RH-Electronics/MyGeiger_ver2/Photos/mygeiger-dosimeter-assembled-kit.jpg

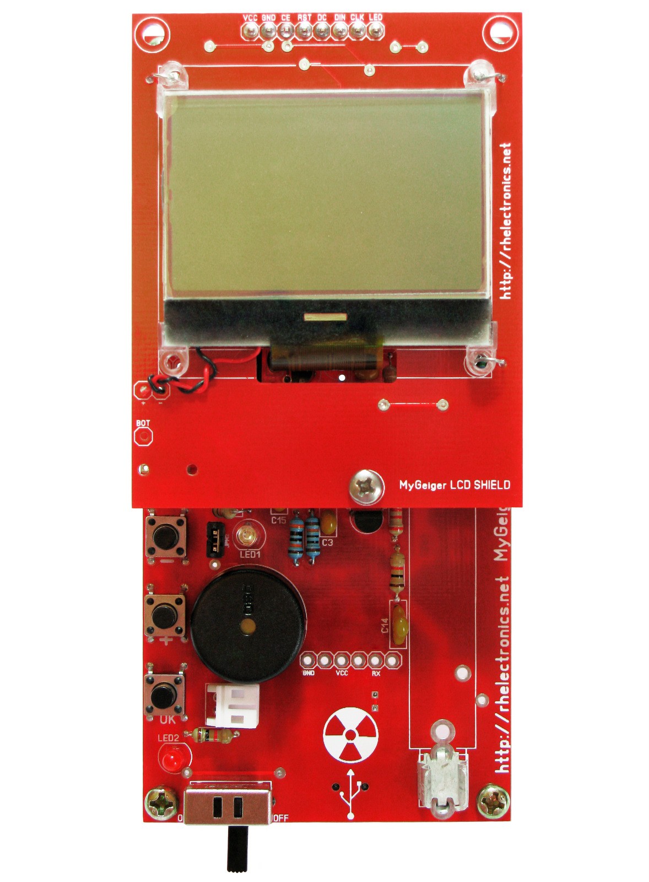
Photos/mygeiger-dosimeter-assembled-kit.jpg
