RH-Electronics/MyGeiger_ver2/Hardware/DYaDNbcA.jpeg

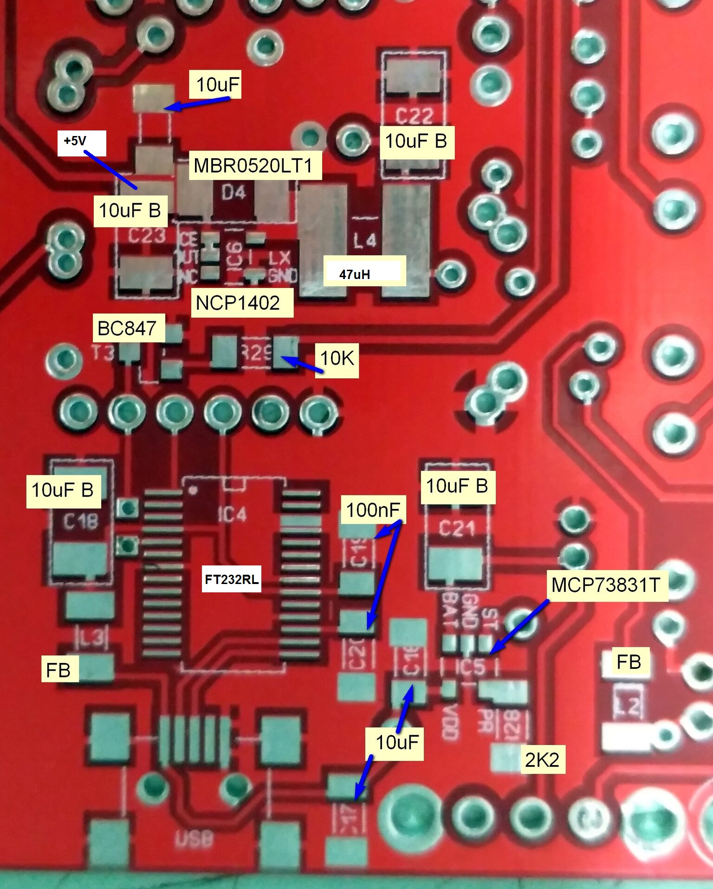
Hardware/DYaDNbcA.jpeg
