RH-Electronics/MyGeiger_ver2/README.md

# MyGeiger_ver2
MyGeiger ver.2 Dosimeter DIY Geiger Counter Kit with LCD Shield and USB

https://www.rhelectronics.store/mygeiger-dosimeter-diy-geiger-counter-kit-with-lcd-shield-usb-pic18f2550-second-edition
