RH-Electronics/MyGeiger_ver2/Firmware/readme

Firmware files with source code for main board and SD Logger module
