RH-Electronics/MyGeiger_ver2/Hardware/pic18f2550_ver2.GIF

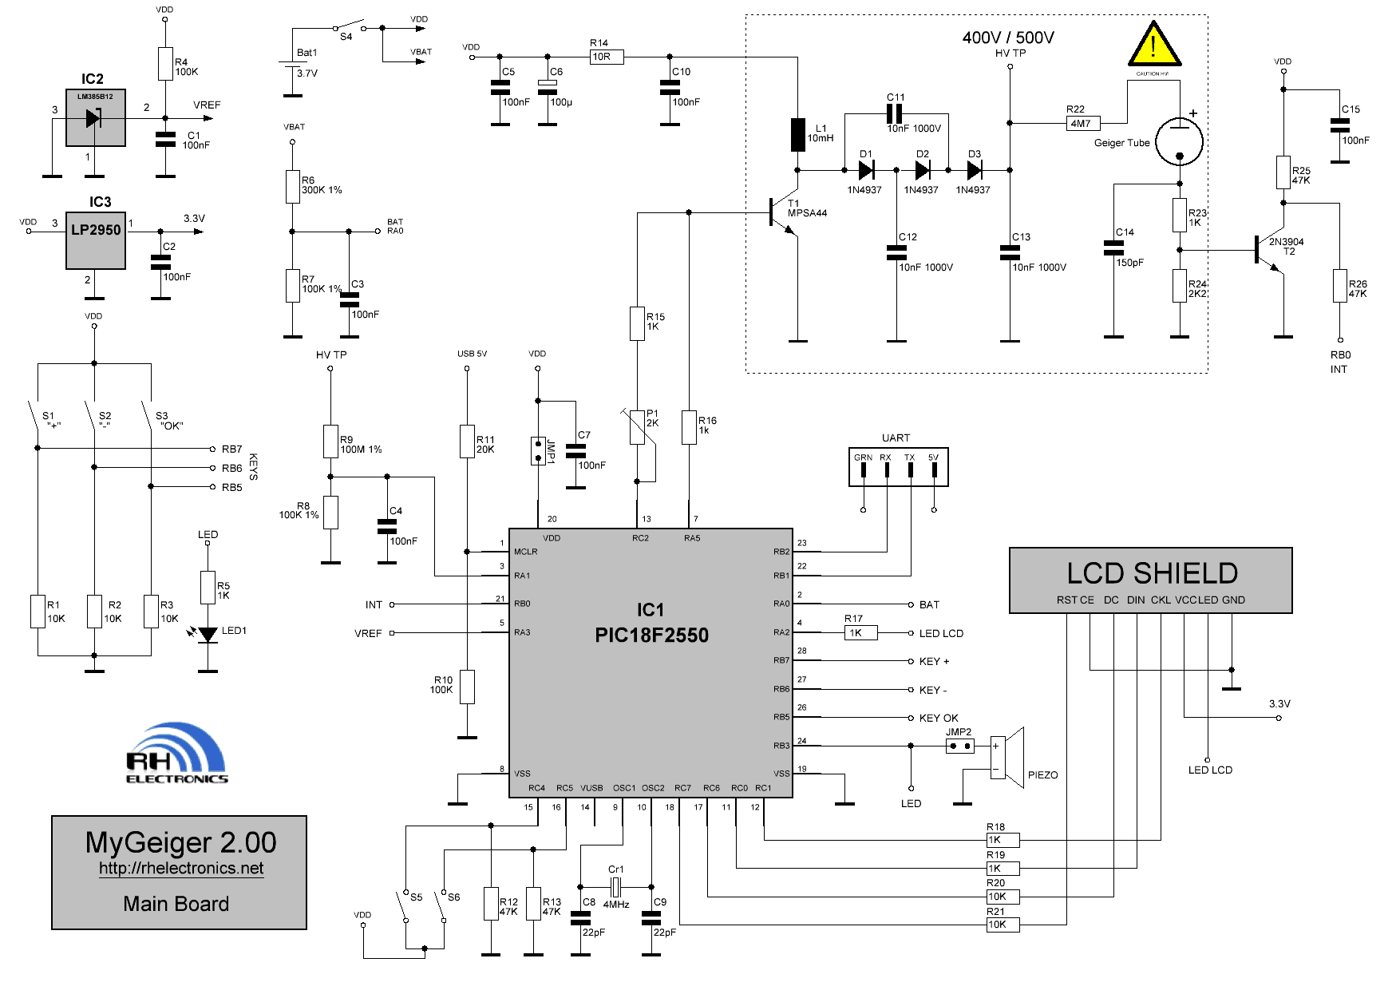
Hardware/pic18f2550_ver2.GIF
