RH-Electronics/MyGeiger_ver2/Photos/dosimeter_mygeiger_second_edition.jpg

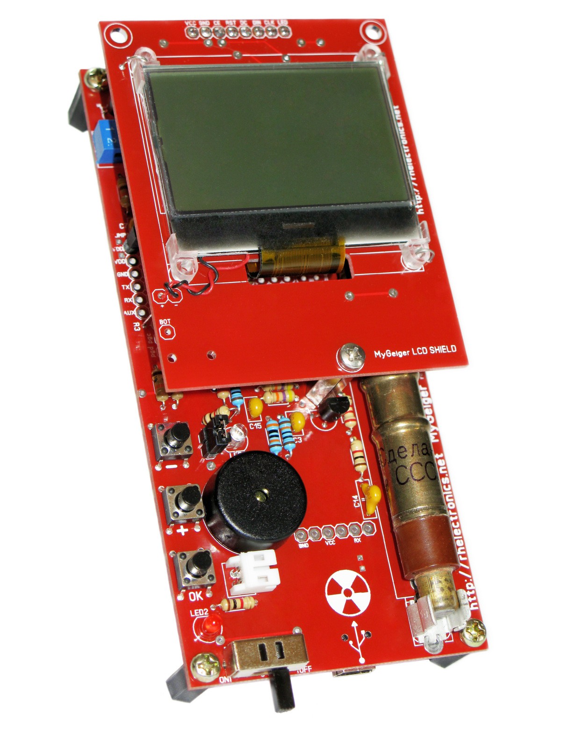
Photos/dosimeter_mygeiger_second_edition.jpg
