RH-Electronics/MyGeiger_ver2/Photos/img_1046.jpg

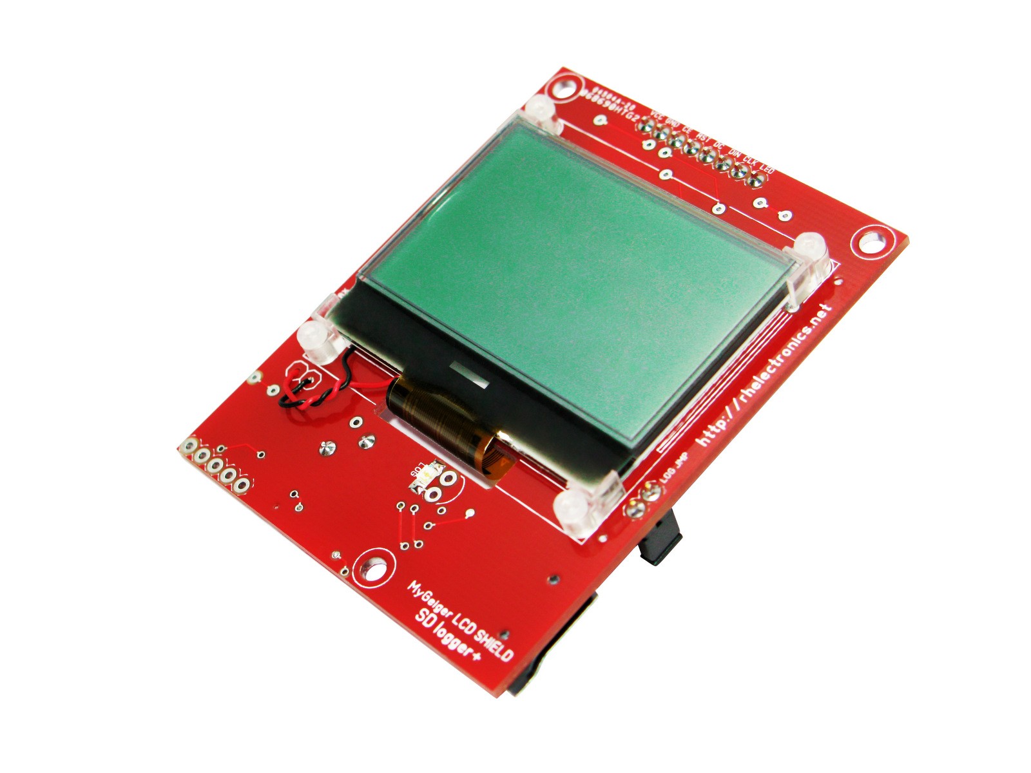
Photos/img_1046.jpg
