RH-Electronics/MyGeiger_ver2/Photos/img_1079.jpg

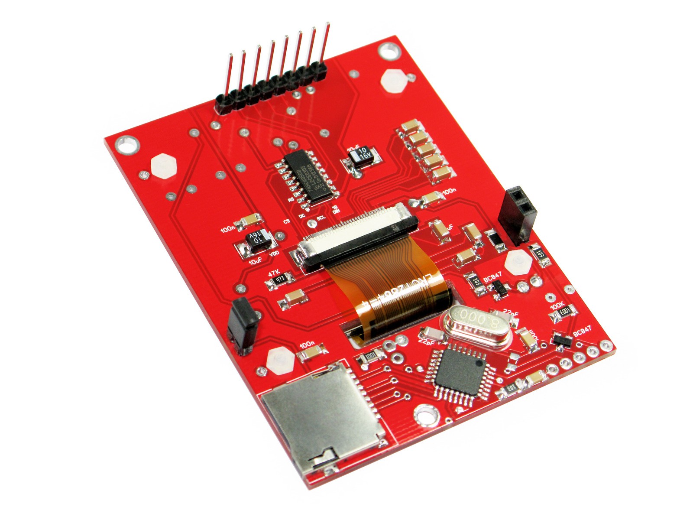
Photos/img_1079.jpg
