RH-Electronics/MyGeiger_ver2/Photos/img_8147.jpg

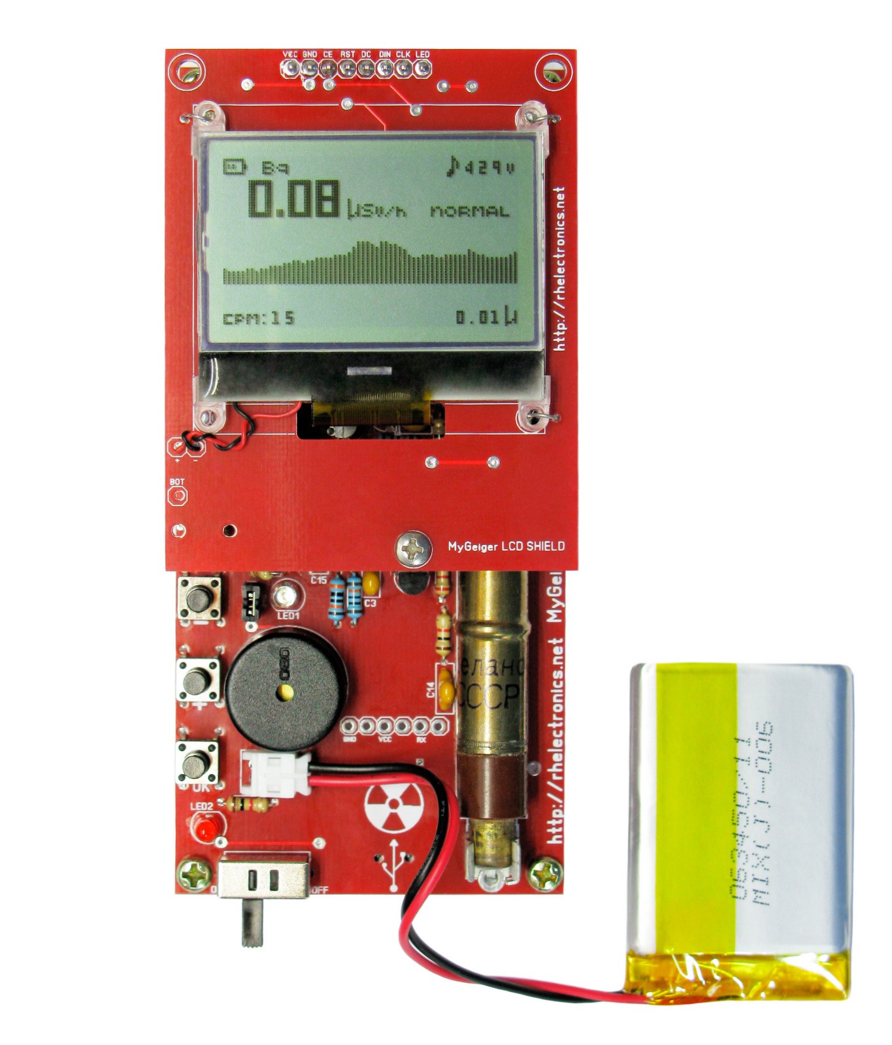
Photos/img_8147.jpg
