RH-Electronics/MyGeiger_ver2/Photos/img_8734_vertical.jpg

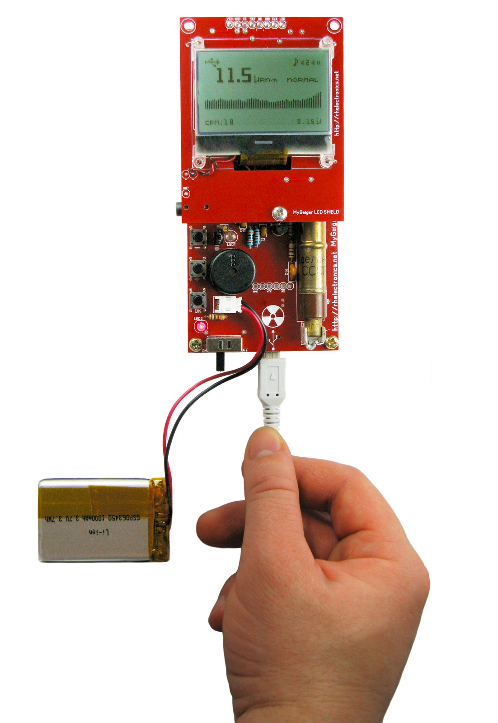
Photos/img_8734_vertical.jpg
