RH-Electronics/MyGeiger_ver2/Photos/mygeiger-urn.jpg

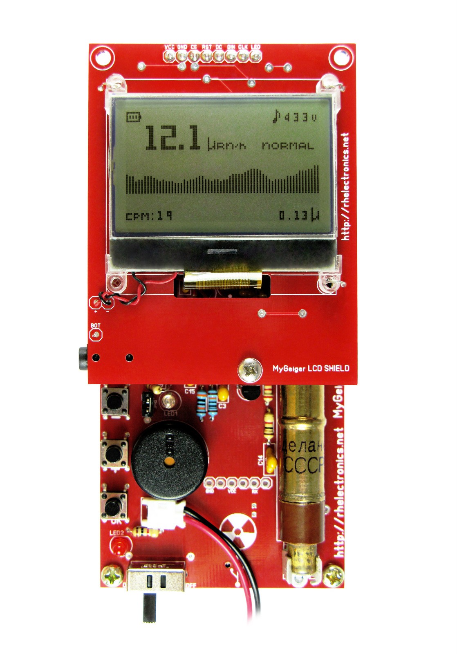
Photos/mygeiger-urn.jpg
