RH-Electronics/MyGeiger_ver2/Photos/mygeiger_2.jpg

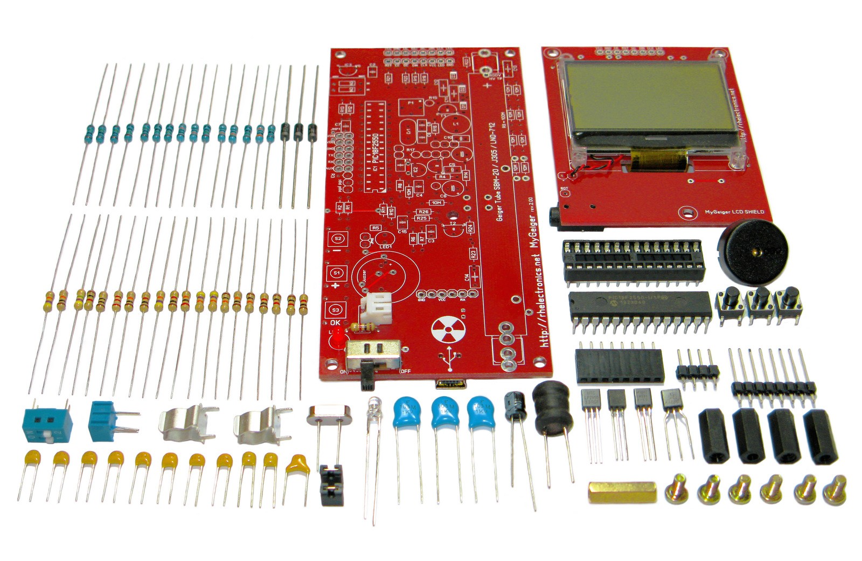
Photos/mygeiger_2.jpg
