RH-Electronics/MyGeiger_ver2/Photos/mygeiger_diy_dosimeter.jpg

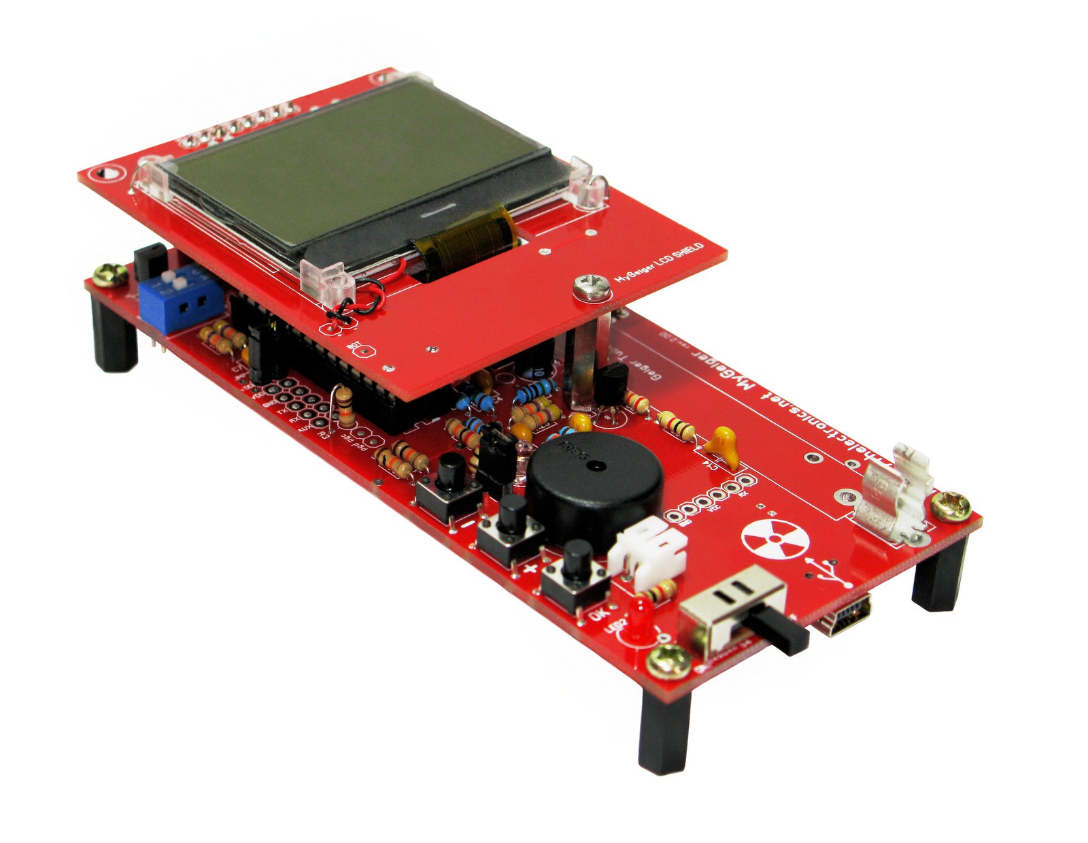
Photos/mygeiger_diy_dosimeter.jpg
