RH-Electronics/MyGeiger_ver2/Photos/mygeiger_diy_kit.jpg

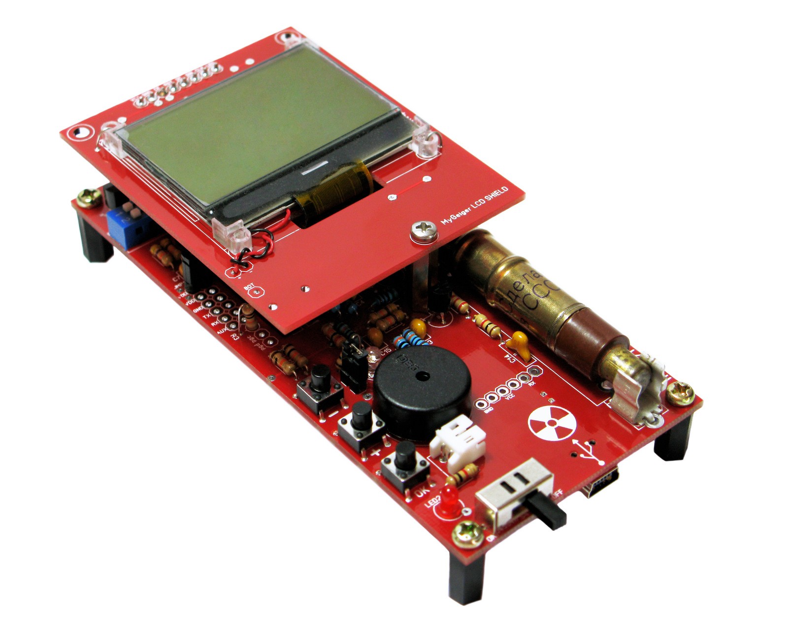
Photos/mygeiger_diy_kit.jpg
