RH-Electronics/MyGeiger_ver2/Photos/mygeiger_kit.jpg

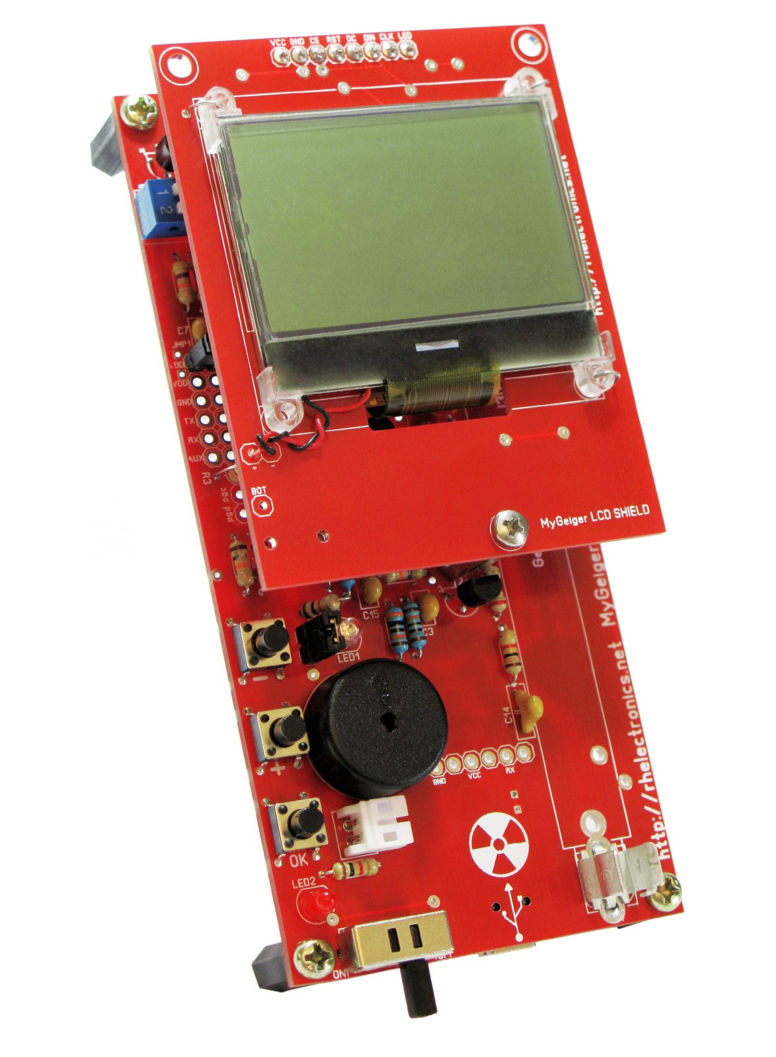
Photos/mygeiger_kit.jpg
