RH-Electronics/MyGeiger_ver2/Photos/mygeiger_side_view.jpg

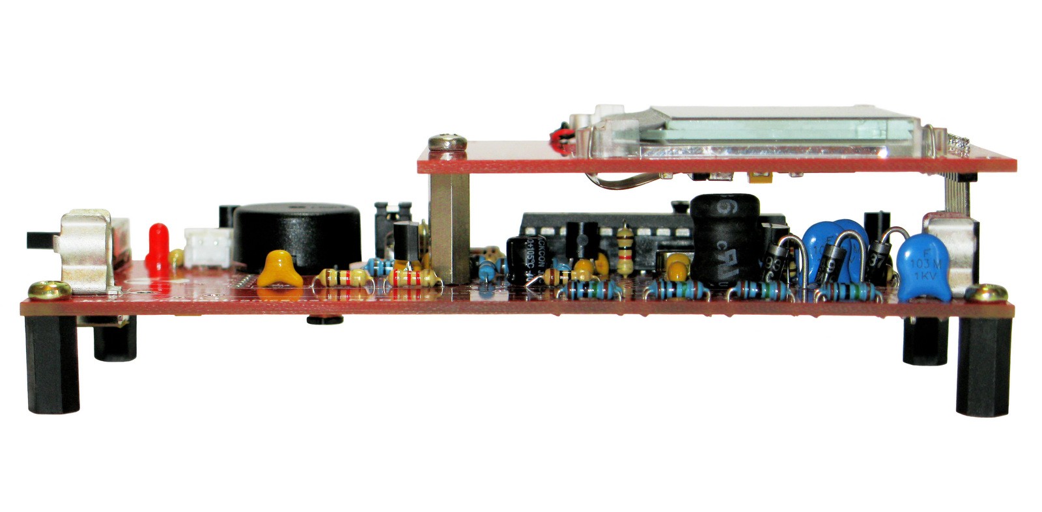
Photos/mygeiger_side_view.jpg
