RH-Electronics/MyGeiger_ver2/Photos/mygeiger_side_view_with_sbm-20.jpg

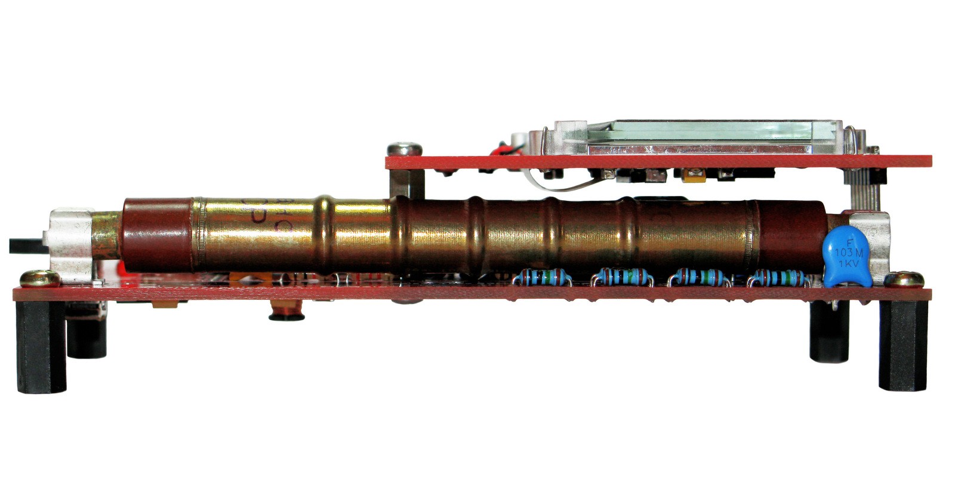
Photos/mygeiger_side_view_with_sbm-20.jpg
