RH-Electronics/MyGeiger_ver2/Photos/mygeiger_with_sbm-20.jpg

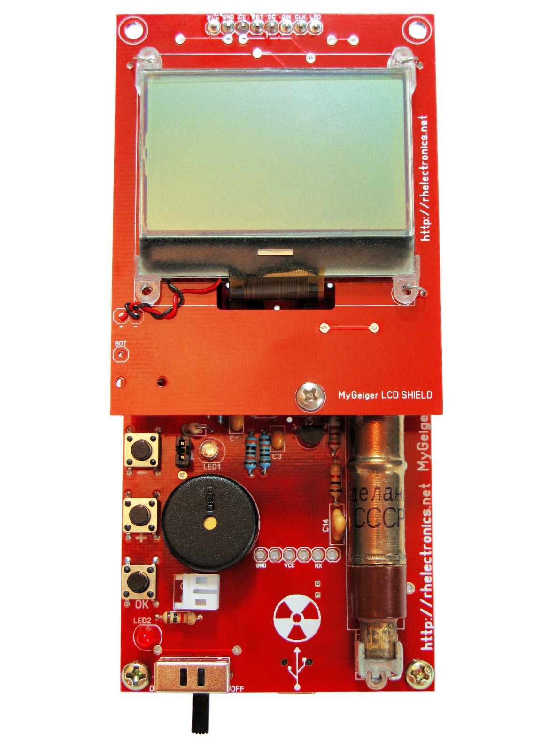
Photos/mygeiger_with_sbm-20.jpg
