RH-Electronics/MyGeiger_ver2/Photos/SD_Logger_LCD_Shield-002.jpg

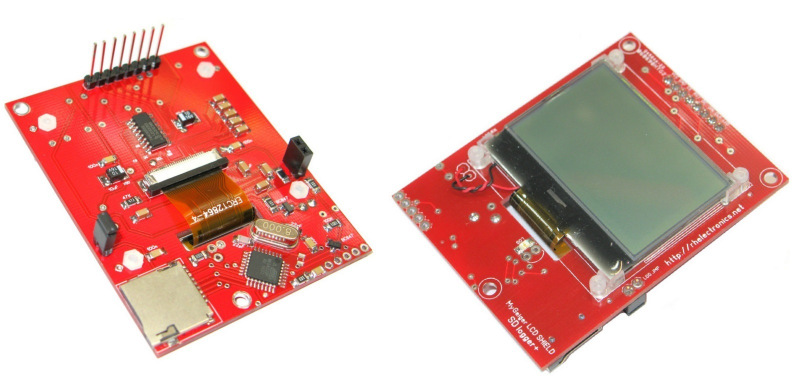
Photos/SD_Logger_LCD_Shield-002.jpg
