RH-Electronics/MyGeiger_ver2/Hardware/BOM-MyGeiger-2.xlsx

Sheet: CUSTOMER
Component Name | Quantitiy | Additional
Resistor 10K | 5 | 0.25W 5%
Resistor 1K | 7 | 0.25W 5%
Resistor 20K | 1 | 0.25W 5%
Resistor 2.2K | 1 | 0.25W 5%
Resistor 47K | 4 | 0.25W 5%
Resistor 10R | 1 | 0.25W 5%
Resistor 4.7M | 1 | 0.25W 5%
Resistor 300K | 1 | 0.25W 1%
Resistor 100K | 4 | 0.25W 1%
Resistor 10M | 10 | 0.25W 1%
Potentiometer 2K | 1 | 3362P
Ceramic Capacitor 100nF | 8 | Multilayer
Ceramic Capacitor 22pF | 2 | Multilayer
Ceramic Capacitor 150pF | 1 | Multilayer
Ceramic Capacitor 10nF 1000V | 3 | Multilayer
Electrolythic Capacitor 100uF | 1 | 5x6 mm
LED blue | 1 | 3mm
Diode 1N4937 | 3 | Fast Rectifier
Crystal 4.000MHz | 1 | HS-49S
Piezo Buzzer | 1 | Passive
Ferrite Radial Inductor 10mH | 1 | 8x10 15Ohm
Tact Switch | 3 | 6x6
Dip Switch 2 Position | 1
8 Pin Female Header | 1
2 Pin Male Header | 2
Jumper Cup | 2
Tube Clips | 2
M3x6 Screw | 6
M3x12 Standoff | 4
M3x15 Standoff | 1
28 Pin IC Socket | 1
Transistor MPSA44 | 1 | TO-92
Transistor 2N3904 | 1 | TO-92
LP2950 3.3V LDO | 1 | TO-92
LM385B12 VREF | 1 | TO-92
PIC18F2550 | 1 | DIP-28

Sheet: MAIN BOARD SMD
Component Name | Quantitiy | Additional | LINK
Resistor 1k | 1 | 0.25 W DIP
LED red | 1 | 3mm DIP
Resistor 2.2K | 1 | 1206
Resistor 10K | 1 | 1206
Ceramic Capacitor 100nF | 3 | 1206
Ceramic Capacitor 10uF | 2 | 1206
Tantalum Capacitor 10uF B | 4 | 3528
Diode MBR0520LT1 | 1 | SOD123
Inductor 47uH | 1 | CD54-470L
Ferrite Bead | 2 | 1206
Mini USB 5 Pin | 1 | SMD
BC847 | 1 | SOT-23
NCP1402 5V | 1 | SOT-23-5
MCP73831T | 1 | SOT-23-5
FT232-RL | 1 | SSOP-28 | https://www.digikey.co.il/product-detail/en/ftdi-future-technology-devices-international-ltd/FT232RL-REEL/768-1007-1-ND/1836402
Slide Switch | 1 | On/Off
LIPO Connector | 1 | 2.0mm
zener 75V BZX84C75 | 1 | sot-23
zener 91V MMBZ5270BLT1G | 2 | sot-23
zener 51V BZX84C51 | 1 | sot-23

Sheet: LCD SHIELD without Logger
Component Name | Quantitiy | Additional | LINK
Resistor 10K | 1 | 1206
Resistor 200R | 1 | 1206
Resistor 3.9K | 1 | 1206
Resistor 39K | 1 | 1206
Resistor 47K | 1 | 1206
Ceramic Capacitor 1uF 25V | 9 | 1206
Ceramic Capacitor 100nF | 2 | 1206
Ceramic Capacitor 10nF | 1 | 1206
Tantalum Capacitor 10uF size B | 2 | 3528
TRSS Audio Connector for Geiger Bot | 1 | SMD
Transistor BC847 | 1 | SOT-23
74HC4050 | 1 | SOP-16
1.8 inch SPI Serial 128x64 COG LCD | 1 | ERC12864FBF | https://www.buydisplay.com/default/1-8-inch-spi-serial-128x64-touch-cog-lcd-module-display-black-on-blue
30 Pins 0.50mm Pitch ZIF Connector | 1
8 Pin Male Header Long 15mm | 1

Sheet: LCD_SHIELD with Logger
Component Name | Quantitiy | Additional | LINK
Resistor 100K | 1 | 1206
Resistor 10K | 3 | 1206
Resistor 200R | 1 | 1206
Resistor 1K | 1 | 1206
Resistor 39K | 1 | 1206
Resistor 47K | 1 | 1206
Ceramic Capacitor 1uF 25V | 9 | 1206
Ceramic Capacitor 100nF | 5 | 1206
Ceramic Capacitor 22pF | 2 | 1206
SMD led | 1 | 1206
Tantalum Capacitor 10uF size B | 2 | 3528
Transistor BC847 | 2 | SOT-23
74HC4050 | 1 | SOP-16
1.8 inch SPI Serial 128x64 COG LCD | 1 | ERC12864FBF | https://www.buydisplay.com/default/1-8-inch-spi-serial-128x64-touch-cog-lcd-module-display-black-on-blue
30 Pins 0.50mm Pitch ZIF Connector | 1
10 Pin Male Header Long 15mm | 1
2.54mm Jumper cup | 1
ATMEGA328PB-AU | 1 | 32-TQFP (7x7) | install arduino IDE prior soldering, see PDF manual for logger
Crystal 8MHz | 1 | HC-49S
SD Socket | 1 | Micro SD Push/Push Socket w/ 9 SMT Contacts | https://www.ebay.com/itm/10Pcs-Push-Push-Type-TF-Micro-SD-Card-Solder-Socket-Memmory-Card-Connector/171722065875
