RH-Electronics/MyGeiger_ver2/Photos/atomic-dave-internal-wiring-diagram.jpg

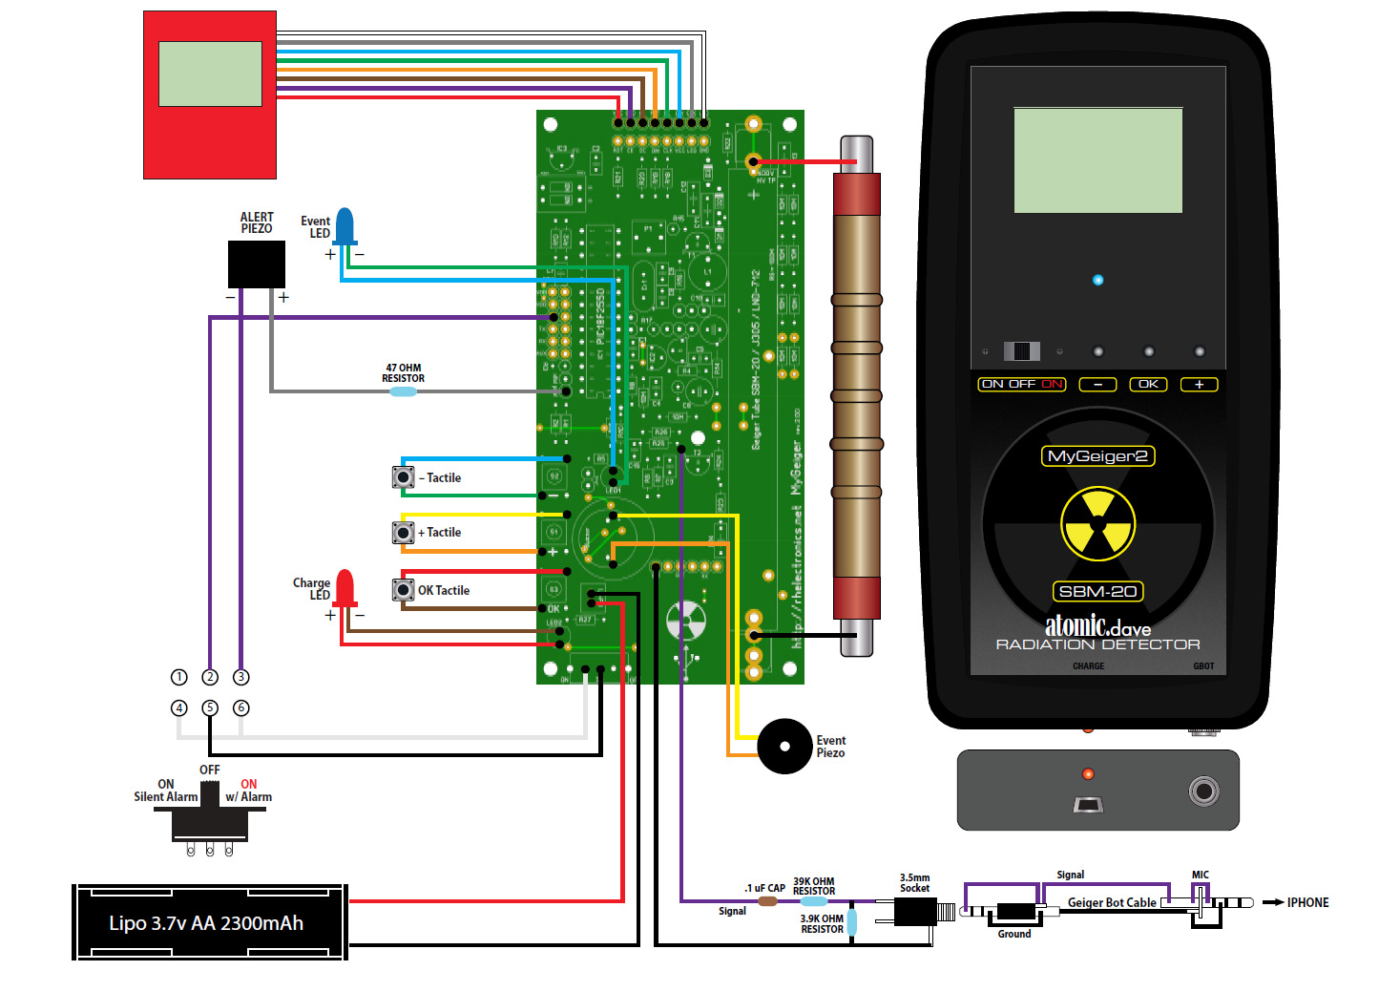
Photos/atomic-dave-internal-wiring-diagram.jpg
