RH-Electronics/MyGeiger_ver2/(list of files, drawings)

Other design files:
Hardware/LOGGER_LCD.lay6
Hardware/MyGeiger_ver2_main_board.lay6
