RH-Electronics/MyGeiger_ver2/Firmware/MyGeiger_NT.asm

_interrupt:

;MyGeiger_NT.mbas,477 :: 		sub procedure interrupt()             ' Interrupt Settings
;MyGeiger_NT.mbas,479 :: 		if (TMR0IF_bit = 1) then
	BTFSS       TMR0IF_bit+0, BitPos(TMR0IF_bit+0) 
	GOTO        L__interrupt2
;MyGeiger_NT.mbas,480 :: 		LATA.5  = 0                        ' turn off podkachka
	BCF         LATA+0, 5 
;MyGeiger_NT.mbas,481 :: 		T0CON = %01001000
	MOVLW       72
	MOVWF       T0CON+0 
;MyGeiger_NT.mbas,482 :: 		TMR0IF_bit = 0
	BCF         TMR0IF_bit+0, BitPos(TMR0IF_bit+0) 
L__interrupt2:
;MyGeiger_NT.mbas,485 :: 		if (TMR3IF_bit = 1) then
	BTFSS       TMR3IF_bit+0, BitPos(TMR3IF_bit+0) 
	GOTO        L__interrupt5
;MyGeiger_NT.mbas,486 :: 		if (buzzer_counter = 4) then
	MOVF        _buzzer_counter+0, 0 
	XORLW       4
	BTFSS       STATUS+0, 2 
	GOTO        L__interrupt8
;MyGeiger_NT.mbas,487 :: 		LATB.3 = 0
	BCF         LATB+0, 3 
;MyGeiger_NT.mbas,488 :: 		buzzer_counter = 0
	CLRF        _buzzer_counter+0 
;MyGeiger_NT.mbas,489 :: 		buzzer_started = 0
	BCF         _buzzer_started+0, BitPos(_buzzer_started+0) 
;MyGeiger_NT.mbas,490 :: 		TMR3ON_bit = 0
	BCF         TMR3ON_bit+0, BitPos(TMR3ON_bit+0) 
	GOTO        L__interrupt9
;MyGeiger_NT.mbas,491 :: 		else
L__interrupt8:
;MyGeiger_NT.mbas,492 :: 		if buzzer_started = 1 then
	BTFSS       _buzzer_started+0, BitPos(_buzzer_started+0) 
	GOTO        L__interrupt11
;MyGeiger_NT.mbas,493 :: 		LATB.3 = not LATB.3
	BTG         LATB+0, 3 
L__interrupt11:
;MyGeiger_NT.mbas,495 :: 		inc (buzzer_counter)
	INCF        _buzzer_counter+0, 1 
;MyGeiger_NT.mbas,496 :: 		end if
L__interrupt9:
;MyGeiger_NT.mbas,497 :: 		TMR3H = 0xFF
	MOVLW       255
	MOVWF       TMR3H+0 
;MyGeiger_NT.mbas,498 :: 		TMR3L = 0x91                       'd2
	MOVLW       145
	MOVWF       TMR3L+0 
;MyGeiger_NT.mbas,500 :: 		TMR3IF_bit = 0
	BCF         TMR3IF_bit+0, BitPos(TMR3IF_bit+0) 
L__interrupt5:
;MyGeiger_NT.mbas,505 :: 		if (TMR1IF_bit = 1) then             ' Test Timer1 interrupt flag
	BTFSS       TMR1IF_bit+0, BitPos(TMR1IF_bit+0) 
	GOTO        L__interrupt14
;MyGeiger_NT.mbas,507 :: 		if(b_count = 4) then               ' let check buttons every 250 ms
	MOVF        _b_count+0, 0 
	XORLW       4
	BTFSS       STATUS+0, 2 
	GOTO        L__interrupt17
;MyGeiger_NT.mbas,508 :: 		b_count = 0
	CLRF        _b_count+0 
;MyGeiger_NT.mbas,509 :: 		button_check = 1
	BSF         _button_check+0, BitPos(_button_check+0) 
	GOTO        L__interrupt18
;MyGeiger_NT.mbas,510 :: 		else
L__interrupt17:
;MyGeiger_NT.mbas,511 :: 		inc(b_count)
	INCF        _b_count+0, 1 
;MyGeiger_NT.mbas,512 :: 		end if
L__interrupt18:
;MyGeiger_NT.mbas,514 :: 		if(sek_counter = 19) then          ' secund is over timer
	MOVF        _sek_counter+0, 0 
	XORLW       19
	BTFSS       STATUS+0, 2 
	GOTO        L__interrupt20
;MyGeiger_NT.mbas,515 :: 		sek_counter = 0
	CLRF        _sek_counter+0 
;MyGeiger_NT.mbas,516 :: 		sek_cnt = cnt_s
	MOVF        _cnt_s+0, 0 
	MOVWF       _sek_cnt+0 
	MOVF        _cnt_s+1, 0 
	MOVWF       _sek_cnt+1 
;MyGeiger_NT.mbas,517 :: 		cnt_s = 0
	CLRF        _cnt_s+0 
	CLRF        _cnt_s+1 
;MyGeiger_NT.mbas,518 :: 		sek_over = 1
	BSF         _sek_over+0, BitPos(_sek_over+0) 
	GOTO        L__interrupt21
;MyGeiger_NT.mbas,519 :: 		else
L__interrupt20:
;MyGeiger_NT.mbas,520 :: 		inc(sek_counter)
	INCF        _sek_counter+0, 1 
;MyGeiger_NT.mbas,521 :: 		end if
L__interrupt21:
;MyGeiger_NT.mbas,523 :: 		if(timer_cnt = m_period) then      ' When time elapsed    m_period
	MOVF        _timer_cnt+0, 0 
	XORWF       _m_period+0, 0 
	BTFSS       STATUS+0, 2 
	GOTO        L__interrupt23
;MyGeiger_NT.mbas,524 :: 		counts = cnt                     ' Store result in counts
	MOVF        _cnt+0, 0 
	MOVWF       _counts+0 
	MOVF        _cnt+1, 0 
	MOVWF       _counts+1 
;MyGeiger_NT.mbas,525 :: 		cnt = 0                          ' Reset counter
	CLRF        _cnt+0 
	CLRF        _cnt+1 
;MyGeiger_NT.mbas,526 :: 		timer_cnt = 0                    ' Reset timer_cnt
	CLRF        _timer_cnt+0 
;MyGeiger_NT.mbas,527 :: 		cpm_read_done = 1                ' Set flag = 1
	BSF         _cpm_read_done+0, BitPos(_cpm_read_done+0) 
	GOTO        L__interrupt24
;MyGeiger_NT.mbas,528 :: 		else
L__interrupt23:
;MyGeiger_NT.mbas,529 :: 		inc(timer_cnt)                   ' Increment timer_cnt if not elapsed 10 second
	INCF        _timer_cnt+0, 1 
;MyGeiger_NT.mbas,530 :: 		end if
L__interrupt24:
;MyGeiger_NT.mbas,532 :: 		TMR1H = 0xE7                       ' First write higher byte to TMR1 0xCF2C
	MOVLW       231
	MOVWF       TMR1H+0 
;MyGeiger_NT.mbas,533 :: 		TMR1L = 0x96                       ' Write lower byte to TMR1
	MOVLW       150
	MOVWF       TMR1L+0 
;MyGeiger_NT.mbas,536 :: 		TMR1IF_bit = 0                     ' Clear Timer1 interrupt flag
	BCF         TMR1IF_bit+0, BitPos(TMR1IF_bit+0) 
L__interrupt14:
;MyGeiger_NT.mbas,539 :: 		if(INT0F_bit) then                   ' Test RB0/INT interrupt flag
	BTFSS       INT0F_bit+0, BitPos(INT0F_bit+0) 
	GOTO        L__interrupt26
;MyGeiger_NT.mbas,540 :: 		cnt = cnt + 1                      ' Count interrupts on RB0/INT pin
	INFSNZ      _cnt+0, 1 
	INCF        _cnt+1, 1 
;MyGeiger_NT.mbas,541 :: 		cnt_s = cnt_s + 1
	INFSNZ      _cnt_s+0, 1 
	INCF        _cnt_s+1, 1 
;MyGeiger_NT.mbas,542 :: 		if probe = 0x00 then
	MOVF        _probe+0, 0 
	XORLW       0
	BTFSS       STATUS+0, 2 
	GOTO        L__interrupt29
;MyGeiger_NT.mbas,543 :: 		LATA.5  = 1                        ' Turn on podka4ka
	BSF         LATA+0, 5 
;MyGeiger_NT.mbas,545 :: 		TMR0L   = timer_byte               ' set timer
	MOVF        _timer_byte+0, 0 
	MOVWF       TMR0L+0 
;MyGeiger_NT.mbas,546 :: 		T0CON = %11001000                  ' start timer
	MOVLW       200
	MOVWF       T0CON+0 
L__interrupt29:
;MyGeiger_NT.mbas,549 :: 		if sound = 1 then
	BTFSS       _sound+0, BitPos(_sound+0) 
	GOTO        L__interrupt32
;MyGeiger_NT.mbas,550 :: 		buzzer_started = 1
	BSF         _buzzer_started+0, BitPos(_buzzer_started+0) 
;MyGeiger_NT.mbas,551 :: 		buzzer_counter = 0
	CLRF        _buzzer_counter+0 
;MyGeiger_NT.mbas,552 :: 		LATB.3 = 1
	BSF         LATB+0, 3 
;MyGeiger_NT.mbas,553 :: 		TMR3H = 0xFF
	MOVLW       255
	MOVWF       TMR3H+0 
;MyGeiger_NT.mbas,554 :: 		TMR3L = 0x91
	MOVLW       145
	MOVWF       TMR3L+0 
;MyGeiger_NT.mbas,555 :: 		TMR3ON_bit = 1
	BSF         TMR3ON_bit+0, BitPos(TMR3ON_bit+0) 
L__interrupt32:
;MyGeiger_NT.mbas,557 :: 		INT0F_bit = 0                      ' Clear RB0/INT interrupt flag
	BCF         INT0F_bit+0, BitPos(INT0F_bit+0) 
L__interrupt26:
;MyGeiger_NT.mbas,561 :: 		end sub
L_end_interrupt:
L__interrupt805:
	RETFIE      1
; end of _interrupt

_InitLCD:

;MyGeiger_NT.mbas,566 :: 		sub procedure InitLCD()
;MyGeiger_NT.mbas,567 :: 		rreset = 1
	BSF         PORTC+0, 7 
;MyGeiger_NT.mbas,568 :: 		ddata  = 0
	BCF         PORTC+0, 6 
;MyGeiger_NT.mbas,569 :: 		Soft_SPI_Write (RESETD)
	MOVLW       226
	MOVWF       FARG_Soft_SPI_Write_sdata+0 
	CALL        _Soft_SPI_Write+0, 0
;MyGeiger_NT.mbas,570 :: 		delay_us(2000)
	MOVLW       3
	MOVWF       R12, 0
	MOVLW       151
	MOVWF       R13, 0
L__InitLCD35:
	DECFSZ      R13, 1, 1
	BRA         L__InitLCD35
	DECFSZ      R12, 1, 1
	BRA         L__InitLCD35
	NOP
	NOP
;MyGeiger_NT.mbas,571 :: 		rreset = 0
	BCF         PORTC+0, 7 
;MyGeiger_NT.mbas,572 :: 		delay_us(2000)
	MOVLW       3
	MOVWF       R12, 0
	MOVLW       151
	MOVWF       R13, 0
L__InitLCD36:
	DECFSZ      R13, 1, 1
	BRA         L__InitLCD36
	DECFSZ      R12, 1, 1
	BRA         L__InitLCD36
	NOP
	NOP
;MyGeiger_NT.mbas,573 :: 		rreset = 1
	BSF         PORTC+0, 7 
;MyGeiger_NT.mbas,574 :: 		delay_ms(100)
	MOVLW       130
	MOVWF       R12, 0
	MOVLW       221
	MOVWF       R13, 0
L__InitLCD37:
	DECFSZ      R13, 1, 1
	BRA         L__InitLCD37
	DECFSZ      R12, 1, 1
	BRA         L__InitLCD37
	NOP
	NOP
;MyGeiger_NT.mbas,575 :: 		Soft_SPI_Write (CLEAR_ADC)
	MOVLW       160
	MOVWF       FARG_Soft_SPI_Write_sdata+0 
	CALL        _Soft_SPI_Write+0, 0
;MyGeiger_NT.mbas,576 :: 		Soft_SPI_Write (CLEAR_BIAS)
	MOVLW       162
	MOVWF       FARG_Soft_SPI_Write_sdata+0 
	CALL        _Soft_SPI_Write+0, 0
;MyGeiger_NT.mbas,577 :: 		Soft_SPI_Write (%00101111)              ' power control
	MOVLW       47
	MOVWF       FARG_Soft_SPI_Write_sdata+0 
	CALL        _Soft_SPI_Write+0, 0
;MyGeiger_NT.mbas,578 :: 		Soft_SPI_Write (%00100100)              ' LCD contrast level 4
	MOVLW       36
	MOVWF       FARG_Soft_SPI_Write_sdata+0 
	CALL        _Soft_SPI_Write+0, 0
;MyGeiger_NT.mbas,581 :: 		Soft_SPI_Write (SET_SHL)
	MOVLW       200
	MOVWF       FARG_Soft_SPI_Write_sdata+0 
	CALL        _Soft_SPI_Write+0, 0
;MyGeiger_NT.mbas,582 :: 		Soft_SPI_Write (0x40)                   ' initial dispaly line  COM0
	MOVLW       64
	MOVWF       FARG_Soft_SPI_Write_sdata+0 
	CALL        _Soft_SPI_Write+0, 0
;MyGeiger_NT.mbas,583 :: 		Soft_SPI_Write (DISPLAY_ON)
	MOVLW       175
	MOVWF       FARG_Soft_SPI_Write_sdata+0 
	CALL        _Soft_SPI_Write+0, 0
;MyGeiger_NT.mbas,585 :: 		end sub
L_end_InitLCD:
	RETURN      0
; end of _InitLCD

_ClearLCD:

;MyGeiger_NT.mbas,588 :: 		dim cl, cnn as byte
;MyGeiger_NT.mbas,589 :: 		for cl = 176 to 183 step 1            ' clear whole display   183 176
	MOVLW       176
	MOVWF       ClearLCD_cl+0 
L__ClearLCD40:
;MyGeiger_NT.mbas,590 :: 		ddata = 0
	BCF         PORTC+0, 6 
;MyGeiger_NT.mbas,591 :: 		Soft_SPI_Write(cl)             ' set page from 0 to 7
	MOVF        ClearLCD_cl+0, 0 
	MOVWF       FARG_Soft_SPI_Write_sdata+0 
	CALL        _Soft_SPI_Write+0, 0
;MyGeiger_NT.mbas,592 :: 		Soft_SPI_Write(%00010000)     ' set column on 0 column position
	MOVLW       16
	MOVWF       FARG_Soft_SPI_Write_sdata+0 
	CALL        _Soft_SPI_Write+0, 0
;MyGeiger_NT.mbas,593 :: 		Soft_SPI_Write(%00000000)
	CLRF        FARG_Soft_SPI_Write_sdata+0 
	CALL        _Soft_SPI_Write+0, 0
;MyGeiger_NT.mbas,594 :: 		ddata = 1
	BSF         PORTC+0, 6 
;MyGeiger_NT.mbas,595 :: 		for cnn = 0 to 127            ' write zero array
	CLRF        ClearLCD_cnn+0 
L__ClearLCD45:
;MyGeiger_NT.mbas,596 :: 		Soft_SPI_Write(0x00)
	CLRF        FARG_Soft_SPI_Write_sdata+0 
	CALL        _Soft_SPI_Write+0, 0
;MyGeiger_NT.mbas,597 :: 		next cnn
	MOVF        ClearLCD_cnn+0, 0 
	XORLW       127
	BTFSC       STATUS+0, 2 
	GOTO        L__ClearLCD48
	INCF        ClearLCD_cnn+0, 1 
	GOTO        L__ClearLCD45
L__ClearLCD48:
;MyGeiger_NT.mbas,598 :: 		next cl
	MOVF        ClearLCD_cl+0, 0 
	XORLW       183
	BTFSC       STATUS+0, 2 
	GOTO        L__ClearLCD43
	INCF        ClearLCD_cl+0, 1 
	GOTO        L__ClearLCD40
L__ClearLCD43:
;MyGeiger_NT.mbas,599 :: 		end sub
L_end_ClearLCD:
	RETURN      0
; end of _ClearLCD

_PositionLCD:

;MyGeiger_NT.mbas,602 :: 		dim position_low, position_high, temp_x as byte
;MyGeiger_NT.mbas,604 :: 		position_high = %00010000 OR x>>4
	MOVF        FARG_PositionLCD_x+0, 0 
	MOVWF       R0 
	RRCF        R0, 1 
	BCF         R0, 7 
	RRCF        R0, 1 
	BCF         R0, 7 
	RRCF        R0, 1 
	BCF         R0, 7 
	RRCF        R0, 1 
	BCF         R0, 7 
	MOVLW       16
	IORWF       R0, 0 
	MOVWF       PositionLCD_position_high+0 
;MyGeiger_NT.mbas,605 :: 		position_low  = %00000000 OR temp_x<<4
	MOVF        FARG_PositionLCD_x+0, 0 
	MOVWF       PositionLCD_position_low+0 
	RLCF        PositionLCD_position_low+0, 1 
	BCF         PositionLCD_position_low+0, 0 
	RLCF        PositionLCD_position_low+0, 1 
	BCF         PositionLCD_position_low+0, 0 
	RLCF        PositionLCD_position_low+0, 1 
	BCF         PositionLCD_position_low+0, 0 
	RLCF        PositionLCD_position_low+0, 1 
	BCF         PositionLCD_position_low+0, 0 
;MyGeiger_NT.mbas,606 :: 		position_low  = %00000000 OR position_low>>4
	RRCF        PositionLCD_position_low+0, 1 
	BCF         PositionLCD_position_low+0, 7 
	RRCF        PositionLCD_position_low+0, 1 
	BCF         PositionLCD_position_low+0, 7 
	RRCF        PositionLCD_position_low+0, 1 
	BCF         PositionLCD_position_low+0, 7 
	RRCF        PositionLCD_position_low+0, 1 
	BCF         PositionLCD_position_low+0, 7 
;MyGeiger_NT.mbas,607 :: 		ddata = 0
	BCF         PORTC+0, 6 
;MyGeiger_NT.mbas,609 :: 		case 7
	MOVF        FARG_PositionLCD_y+0, 0 
	XORLW       7
	BTFSS       STATUS+0, 2 
	GOTO        L__PositionLCD53
;MyGeiger_NT.mbas,610 :: 		Soft_SPI_Write(183)
	MOVLW       183
	MOVWF       FARG_Soft_SPI_Write_sdata+0 
	CALL        _Soft_SPI_Write+0, 0
	GOTO        L__PositionLCD50
L__PositionLCD53:
;MyGeiger_NT.mbas,611 :: 		case 6
	MOVF        FARG_PositionLCD_y+0, 0 
	XORLW       6
	BTFSS       STATUS+0, 2 
	GOTO        L__PositionLCD56
;MyGeiger_NT.mbas,612 :: 		Soft_SPI_Write(182)
	MOVLW       182
	MOVWF       FARG_Soft_SPI_Write_sdata+0 
	CALL        _Soft_SPI_Write+0, 0
	GOTO        L__PositionLCD50
L__PositionLCD56:
;MyGeiger_NT.mbas,613 :: 		case 5
	MOVF        FARG_PositionLCD_y+0, 0 
	XORLW       5
	BTFSS       STATUS+0, 2 
	GOTO        L__PositionLCD59
;MyGeiger_NT.mbas,614 :: 		Soft_SPI_Write(181)
	MOVLW       181
	MOVWF       FARG_Soft_SPI_Write_sdata+0 
	CALL        _Soft_SPI_Write+0, 0
	GOTO        L__PositionLCD50
L__PositionLCD59:
;MyGeiger_NT.mbas,615 :: 		case 4
	MOVF        FARG_PositionLCD_y+0, 0 
	XORLW       4
	BTFSS       STATUS+0, 2 
	GOTO        L__PositionLCD62
;MyGeiger_NT.mbas,616 :: 		Soft_SPI_Write(180)
	MOVLW       180
	MOVWF       FARG_Soft_SPI_Write_sdata+0 
	CALL        _Soft_SPI_Write+0, 0
	GOTO        L__PositionLCD50
L__PositionLCD62:
;MyGeiger_NT.mbas,617 :: 		case 3
	MOVF        FARG_PositionLCD_y+0, 0 
	XORLW       3
	BTFSS       STATUS+0, 2 
	GOTO        L__PositionLCD65
;MyGeiger_NT.mbas,618 :: 		Soft_SPI_Write(179)
	MOVLW       179
	MOVWF       FARG_Soft_SPI_Write_sdata+0 
	CALL        _Soft_SPI_Write+0, 0
	GOTO        L__PositionLCD50
L__PositionLCD65:
;MyGeiger_NT.mbas,619 :: 		case 2
	MOVF        FARG_PositionLCD_y+0, 0 
	XORLW       2
	BTFSS       STATUS+0, 2 
	GOTO        L__PositionLCD68
;MyGeiger_NT.mbas,620 :: 		Soft_SPI_Write(178)
	MOVLW       178
	MOVWF       FARG_Soft_SPI_Write_sdata+0 
	CALL        _Soft_SPI_Write+0, 0
	GOTO        L__PositionLCD50
L__PositionLCD68:
;MyGeiger_NT.mbas,621 :: 		case 1
	MOVF        FARG_PositionLCD_y+0, 0 
	XORLW       1
	BTFSS       STATUS+0, 2 
	GOTO        L__PositionLCD71
;MyGeiger_NT.mbas,622 :: 		Soft_SPI_Write(177)
	MOVLW       177
	MOVWF       FARG_Soft_SPI_Write_sdata+0 
	CALL        _Soft_SPI_Write+0, 0
	GOTO        L__PositionLCD50
L__PositionLCD71:
;MyGeiger_NT.mbas,623 :: 		case 0
	MOVF        FARG_PositionLCD_y+0, 0 
	XORLW       0
	BTFSS       STATUS+0, 2 
	GOTO        L__PositionLCD74
;MyGeiger_NT.mbas,624 :: 		Soft_SPI_Write(176)
	MOVLW       176
	MOVWF       FARG_Soft_SPI_Write_sdata+0 
	CALL        _Soft_SPI_Write+0, 0
	GOTO        L__PositionLCD50
L__PositionLCD74:
L__PositionLCD50:
;MyGeiger_NT.mbas,626 :: 		Soft_SPI_Write(position_high)
	MOVF        PositionLCD_position_high+0, 0 
	MOVWF       FARG_Soft_SPI_Write_sdata+0 
	CALL        _Soft_SPI_Write+0, 0
;MyGeiger_NT.mbas,627 :: 		Soft_SPI_Write(position_low)
	MOVF        PositionLCD_position_low+0, 0 
	MOVWF       FARG_Soft_SPI_Write_sdata+0 
	CALL        _Soft_SPI_Write+0, 0
;MyGeiger_NT.mbas,628 :: 		ddata = 1
	BSF         PORTC+0, 6 
;MyGeiger_NT.mbas,629 :: 		end sub
L_end_PositionLCD:
	RETURN      0
; end of _PositionLCD

_Chr_LCD:

;MyGeiger_NT.mbas,632 :: 		Dim l, m as Byte
;MyGeiger_NT.mbas,633 :: 		ddata = 1
	BSF         PORTC+0, 6 
;MyGeiger_NT.mbas,634 :: 		For l = 1 to 5
	MOVLW       1
	MOVWF       Chr_LCD_l+0 
L__Chr_LCD77:
;MyGeiger_NT.mbas,635 :: 		m = (symlcd - 32)
	MOVLW       32
	SUBWF       FARG_Chr_LCD_symlcd+0, 0 
	MOVWF       R0 
;MyGeiger_NT.mbas,636 :: 		m = m * 5
	MOVLW       5
	MULWF       R0 
	MOVF        PRODL+0, 0 
	MOVWF       R0 
;MyGeiger_NT.mbas,637 :: 		m = m + l
	MOVF        Chr_LCD_l+0, 0 
	ADDWF       R0, 1 
;MyGeiger_NT.mbas,638 :: 		m = m - 1
	DECF        R0, 1 
;MyGeiger_NT.mbas,639 :: 		Soft_SPI_Write(fontlookup1[m])
	MOVLW       _fontlookup1+0
	ADDWF       R0, 0 
	MOVWF       TBLPTRL 
	MOVLW       hi_addr(_fontlookup1+0)
	MOVWF       TBLPTRH 
	MOVLW       0
	ADDWFC      TBLPTRH, 1 
	MOVLW       higher_addr(_fontlookup1+0)
	MOVWF       TBLPTRU 
	MOVLW       0
	ADDWFC      TBLPTRU, 1 
	TBLRD*+
	MOVFF       TABLAT+0, FARG_Soft_SPI_Write_sdata+0
	CALL        _Soft_SPI_Write+0, 0
;MyGeiger_NT.mbas,640 :: 		Next l
	MOVF        Chr_LCD_l+0, 0 
	XORLW       5
	BTFSC       STATUS+0, 2 
	GOTO        L__Chr_LCD80
	INCF        Chr_LCD_l+0, 1 
	GOTO        L__Chr_LCD77
L__Chr_LCD80:
;MyGeiger_NT.mbas,641 :: 		Soft_SPI_Write(0x00)          ' Space between characters
	CLRF        FARG_Soft_SPI_Write_sdata+0 
	CALL        _Soft_SPI_Write+0, 0
;MyGeiger_NT.mbas,643 :: 		end sub
L_end_Chr_LCD:
	RETURN      0
; end of _Chr_LCD

_Text_LCD:

;MyGeiger_NT.mbas,646 :: 		Dim v as byte
;MyGeiger_NT.mbas,648 :: 		PositionLCD(x,y)
	MOVF        FARG_Text_LCD_x+0, 0 
	MOVWF       FARG_PositionLCD_x+0 
	MOVF        FARG_Text_LCD_y+0, 0 
	MOVWF       FARG_PositionLCD_y+0 
	CALL        _PositionLCD+0, 0
;MyGeiger_NT.mbas,649 :: 		For v = 0 to length(sentance)-1
	CLRF        Text_LCD_v+0 
L__Text_LCD82:
	MOVF        FARG_Text_LCD_sentance+0, 0 
	MOVWF       FARG_Length_Text+0 
	MOVF        FARG_Text_LCD_sentance+1, 0 
	MOVWF       FARG_Length_Text+1 
	CALL        _Length+0, 0
	MOVLW       1
	SUBWF       R0, 0 
	MOVWF       FLOC__Text_LCD+0 
	MOVLW       0
	SUBWFB      R1, 0 
	MOVWF       FLOC__Text_LCD+1 
	MOVLW       0
	SUBWF       FLOC__Text_LCD+1, 0 
	BTFSS       STATUS+0, 2 
	GOTO        L__Text_LCD811
	MOVF        Text_LCD_v+0, 0 
	SUBWF       FLOC__Text_LCD+0, 0 
L__Text_LCD811:
	BTFSS       STATUS+0, 0 
	GOTO        L__Text_LCD86
;MyGeiger_NT.mbas,650 :: 		Chr_LCD(sentance[v])
	MOVF        Text_LCD_v+0, 0 
	ADDWF       FARG_Text_LCD_sentance+0, 0 
	MOVWF       FSR0 
	MOVLW       0
	ADDWFC      FARG_Text_LCD_sentance+1, 0 
	MOVWF       FSR0H 
	MOVF        POSTINC0+0, 0 
	MOVWF       FARG_Chr_LCD_symlcd+0 
	CALL        _Chr_LCD+0, 0
;MyGeiger_NT.mbas,651 :: 		Next v
	MOVLW       0
	XORWF       FLOC__Text_LCD+1, 0 
	BTFSS       STATUS+0, 2 
	GOTO        L__Text_LCD812
	MOVF        FLOC__Text_LCD+0, 0 
	XORWF       Text_LCD_v+0, 0 
L__Text_LCD812:
	BTFSC       STATUS+0, 2 
	GOTO        L__Text_LCD86
	INCF        Text_LCD_v+0, 1 
	GOTO        L__Text_LCD82
L__Text_LCD86:
;MyGeiger_NT.mbas,652 :: 		End Sub
L_end_Text_LCD:
	RETURN      0
; end of _Text_LCD

_Char_LCD:

;MyGeiger_NT.mbas,656 :: 		dim character as integer
;MyGeiger_NT.mbas,657 :: 		ddata = 1
	BSF         PORTC+0, 6 
;MyGeiger_NT.mbas,658 :: 		for index =1 to 5
	MOVLW       1
	MOVWF       Char_LCD_index+0 
	MOVLW       0
	MOVWF       Char_LCD_index+1 
L__Char_LCD89:
;MyGeiger_NT.mbas,659 :: 		character = bykva - 0x20
	MOVLW       32
	SUBWF       FARG_Char_LCD_bykva+0, 0 
	MOVWF       R0 
	MOVLW       0
	MOVWF       R1 
	MOVLW       0
	SUBFWB      R1, 1 
;MyGeiger_NT.mbas,660 :: 		character = character * 5
	MOVLW       5
	MOVWF       R4 
	MOVLW       0
	MOVWF       R5 
	CALL        _Mul_16x16_U+0, 0
;MyGeiger_NT.mbas,661 :: 		character = character + index
	MOVF        Char_LCD_index+0, 0 
	ADDWF       R0, 1 
	MOVF        Char_LCD_index+1, 0 
	ADDWFC      R1, 1 
;MyGeiger_NT.mbas,662 :: 		character = character - 1
	MOVLW       1
	SUBWF       R0, 1 
	MOVLW       0
	SUBWFB      R1, 1 
;MyGeiger_NT.mbas,663 :: 		Soft_SPI_Write(table[character])
	MOVLW       _table+0
	ADDWF       R0, 0 
	MOVWF       TBLPTRL 
	MOVLW       hi_addr(_table+0)
	ADDWFC      R1, 0 
	MOVWF       TBLPTRH 
	MOVLW       higher_addr(_table+0)
	MOVWF       TBLPTRU 
	MOVLW       0
	BTFSC       R1, 7 
	MOVLW       255
	ADDWFC      TBLPTRU, 1 
	TBLRD*+
	MOVFF       TABLAT+0, FARG_Soft_SPI_Write_sdata+0
	CALL        _Soft_SPI_Write+0, 0
;MyGeiger_NT.mbas,665 :: 		next index
	MOVLW       0
	XORWF       Char_LCD_index+1, 0 
	BTFSS       STATUS+0, 2 
	GOTO        L__Char_LCD814
	MOVLW       5
	XORWF       Char_LCD_index+0, 0 
L__Char_LCD814:
	BTFSC       STATUS+0, 2 
	GOTO        L__Char_LCD92
	INFSNZ      Char_LCD_index+0, 1 
	INCF        Char_LCD_index+1, 1 
	GOTO        L__Char_LCD89
L__Char_LCD92:
;MyGeiger_NT.mbas,666 :: 		end sub
L_end_Char_LCD:
	RETURN      0
; end of _Char_LCD

_MyText_LCD:

;MyGeiger_NT.mbas,669 :: 		Dim v as byte
;MyGeiger_NT.mbas,671 :: 		PositionLCD(x,y)
	MOVF        FARG_MyText_LCD_x+0, 0 
	MOVWF       FARG_PositionLCD_x+0 
	MOVF        FARG_MyText_LCD_y+0, 0 
	MOVWF       FARG_PositionLCD_y+0 
	CALL        _PositionLCD+0, 0
;MyGeiger_NT.mbas,672 :: 		For v = 0 to length(sentance)-1
	CLRF        MyText_LCD_v+0 
L__MyText_LCD94:
	MOVF        FARG_MyText_LCD_sentance+0, 0 
	MOVWF       FARG_Length_Text+0 
	MOVF        FARG_MyText_LCD_sentance+1, 0 
	MOVWF       FARG_Length_Text+1 
	CALL        _Length+0, 0
	MOVLW       1
	SUBWF       R0, 0 
	MOVWF       FLOC__MyText_LCD+0 
	MOVLW       0
	SUBWFB      R1, 0 
	MOVWF       FLOC__MyText_LCD+1 
	MOVLW       0
	SUBWF       FLOC__MyText_LCD+1, 0 
	BTFSS       STATUS+0, 2 
	GOTO        L__MyText_LCD816
	MOVF        MyText_LCD_v+0, 0 
	SUBWF       FLOC__MyText_LCD+0, 0 
L__MyText_LCD816:
	BTFSS       STATUS+0, 0 
	GOTO        L__MyText_LCD98
;MyGeiger_NT.mbas,673 :: 		Char_LCD(sentance[v])
	MOVF        MyText_LCD_v+0, 0 
	ADDWF       FARG_MyText_LCD_sentance+0, 0 
	MOVWF       FSR0 
	MOVLW       0
	ADDWFC      FARG_MyText_LCD_sentance+1, 0 
	MOVWF       FSR0H 
	MOVF        POSTINC0+0, 0 
	MOVWF       FARG_Char_LCD_bykva+0 
	CALL        _Char_LCD+0, 0
;MyGeiger_NT.mbas,674 :: 		Soft_SPI_Write(0x00)
	CLRF        FARG_Soft_SPI_Write_sdata+0 
	CALL        _Soft_SPI_Write+0, 0
;MyGeiger_NT.mbas,675 :: 		Next v
	MOVLW       0
	XORWF       FLOC__MyText_LCD+1, 0 
	BTFSS       STATUS+0, 2 
	GOTO        L__MyText_LCD817
	MOVF        FLOC__MyText_LCD+0, 0 
	XORWF       MyText_LCD_v+0, 0 
L__MyText_LCD817:
	BTFSC       STATUS+0, 2 
	GOTO        L__MyText_LCD98
	INCF        MyText_LCD_v+0, 1 
	GOTO        L__MyText_LCD94
L__MyText_LCD98:
;MyGeiger_NT.mbas,676 :: 		End Sub
L_end_MyText_LCD:
	RETURN      0
; end of _MyText_LCD

_LCD_Chr_Big:

;MyGeiger_NT.mbas,679 :: 		dim hh as byte
;MyGeiger_NT.mbas,681 :: 		PositionLCD (px, py)
	MOVF        FARG_LCD_Chr_Big_px+0, 0 
	MOVWF       FARG_PositionLCD_x+0 
	MOVF        FARG_LCD_Chr_Big_py+0, 0 
	MOVWF       FARG_PositionLCD_y+0 
	CALL        _PositionLCD+0, 0
;MyGeiger_NT.mbas,682 :: 		py = py + 1
	INCF        FARG_LCD_Chr_Big_py+0, 1 
;MyGeiger_NT.mbas,683 :: 		digit = 48+digit
	MOVF        FARG_LCD_Chr_Big_digit+0, 0 
	ADDLW       48
	MOVWF       R1 
	MOVF        R1, 0 
	MOVWF       FARG_LCD_Chr_Big_digit+0 
;MyGeiger_NT.mbas,684 :: 		ddata = 1
	BSF         PORTC+0, 6 
;MyGeiger_NT.mbas,685 :: 		if digit = "0" then
	MOVF        R1, 0 
	XORLW       48
	BTFSS       STATUS+0, 2 
	GOTO        L__LCD_Chr_Big101
;MyGeiger_NT.mbas,686 :: 		for hh = 0 to 11
	CLRF        LCD_Chr_Big_hh+0 
L__LCD_Chr_Big104:
;MyGeiger_NT.mbas,687 :: 		Soft_SPI_Write (Zero[hh])
	MOVLW       _Zero+0
	ADDWF       LCD_Chr_Big_hh+0, 0 
	MOVWF       TBLPTRL 
	MOVLW       hi_addr(_Zero+0)
	MOVWF       TBLPTRH 
	MOVLW       0
	ADDWFC      TBLPTRH, 1 
	MOVLW       higher_addr(_Zero+0)
	MOVWF       TBLPTRU 
	MOVLW       0
	ADDWFC      TBLPTRU, 1 
	TBLRD*+
	MOVFF       TABLAT+0, FARG_Soft_SPI_Write_sdata+0
	CALL        _Soft_SPI_Write+0, 0
;MyGeiger_NT.mbas,688 :: 		next hh
	MOVF        LCD_Chr_Big_hh+0, 0 
	XORLW       11
	BTFSC       STATUS+0, 2 
	GOTO        L__LCD_Chr_Big107
	INCF        LCD_Chr_Big_hh+0, 1 
	GOTO        L__LCD_Chr_Big104
L__LCD_Chr_Big107:
;MyGeiger_NT.mbas,689 :: 		PositionLCD (px, py)
	MOVF        FARG_LCD_Chr_Big_px+0, 0 
	MOVWF       FARG_PositionLCD_x+0 
	MOVF        FARG_LCD_Chr_Big_py+0, 0 
	MOVWF       FARG_PositionLCD_y+0 
	CALL        _PositionLCD+0, 0
;MyGeiger_NT.mbas,690 :: 		for hh = 12 to 23
	MOVLW       12
	MOVWF       LCD_Chr_Big_hh+0 
L__LCD_Chr_Big109:
;MyGeiger_NT.mbas,691 :: 		Soft_SPI_Write (Zero[hh])
	MOVLW       _Zero+0
	ADDWF       LCD_Chr_Big_hh+0, 0 
	MOVWF       TBLPTRL 
	MOVLW       hi_addr(_Zero+0)
	MOVWF       TBLPTRH 
	MOVLW       0
	ADDWFC      TBLPTRH, 1 
	MOVLW       higher_addr(_Zero+0)
	MOVWF       TBLPTRU 
	MOVLW       0
	ADDWFC      TBLPTRU, 1 
	TBLRD*+
	MOVFF       TABLAT+0, FARG_Soft_SPI_Write_sdata+0
	CALL        _Soft_SPI_Write+0, 0
;MyGeiger_NT.mbas,692 :: 		next hh
	MOVF        LCD_Chr_Big_hh+0, 0 
	XORLW       23
	BTFSC       STATUS+0, 2 
	GOTO        L__LCD_Chr_Big112
	INCF        LCD_Chr_Big_hh+0, 1 
	GOTO        L__LCD_Chr_Big109
L__LCD_Chr_Big112:
L__LCD_Chr_Big101:
;MyGeiger_NT.mbas,695 :: 		if digit = "1" then
	MOVF        FARG_LCD_Chr_Big_digit+0, 0 
	XORLW       49
	BTFSS       STATUS+0, 2 
	GOTO        L__LCD_Chr_Big114
;MyGeiger_NT.mbas,696 :: 		for hh = 0 to 11
	CLRF        LCD_Chr_Big_hh+0 
L__LCD_Chr_Big117:
;MyGeiger_NT.mbas,697 :: 		Soft_SPI_Write (One[hh])
	MOVLW       _One+0
	ADDWF       LCD_Chr_Big_hh+0, 0 
	MOVWF       TBLPTRL 
	MOVLW       hi_addr(_One+0)
	MOVWF       TBLPTRH 
	MOVLW       0
	ADDWFC      TBLPTRH, 1 
	MOVLW       higher_addr(_One+0)
	MOVWF       TBLPTRU 
	MOVLW       0
	ADDWFC      TBLPTRU, 1 
	TBLRD*+
	MOVFF       TABLAT+0, FARG_Soft_SPI_Write_sdata+0
	CALL        _Soft_SPI_Write+0, 0
;MyGeiger_NT.mbas,698 :: 		next hh
	MOVF        LCD_Chr_Big_hh+0, 0 
	XORLW       11
	BTFSC       STATUS+0, 2 
	GOTO        L__LCD_Chr_Big120
	INCF        LCD_Chr_Big_hh+0, 1 
	GOTO        L__LCD_Chr_Big117
L__LCD_Chr_Big120:
;MyGeiger_NT.mbas,699 :: 		PositionLCD (px, py)
	MOVF        FARG_LCD_Chr_Big_px+0, 0 
	MOVWF       FARG_PositionLCD_x+0 
	MOVF        FARG_LCD_Chr_Big_py+0, 0 
	MOVWF       FARG_PositionLCD_y+0 
	CALL        _PositionLCD+0, 0
;MyGeiger_NT.mbas,700 :: 		for hh = 12 to 23
	MOVLW       12
	MOVWF       LCD_Chr_Big_hh+0 
L__LCD_Chr_Big122:
;MyGeiger_NT.mbas,701 :: 		Soft_SPI_Write (One[hh])
	MOVLW       _One+0
	ADDWF       LCD_Chr_Big_hh+0, 0 
	MOVWF       TBLPTRL 
	MOVLW       hi_addr(_One+0)
	MOVWF       TBLPTRH 
	MOVLW       0
	ADDWFC      TBLPTRH, 1 
	MOVLW       higher_addr(_One+0)
	MOVWF       TBLPTRU 
	MOVLW       0
	ADDWFC      TBLPTRU, 1 
	TBLRD*+
	MOVFF       TABLAT+0, FARG_Soft_SPI_Write_sdata+0
	CALL        _Soft_SPI_Write+0, 0
;MyGeiger_NT.mbas,702 :: 		next hh
	MOVF        LCD_Chr_Big_hh+0, 0 
	XORLW       23
	BTFSC       STATUS+0, 2 
	GOTO        L__LCD_Chr_Big125
	INCF        LCD_Chr_Big_hh+0, 1 
	GOTO        L__LCD_Chr_Big122
L__LCD_Chr_Big125:
L__LCD_Chr_Big114:
;MyGeiger_NT.mbas,705 :: 		if digit = "2" then
	MOVF        FARG_LCD_Chr_Big_digit+0, 0 
	XORLW       50
	BTFSS       STATUS+0, 2 
	GOTO        L__LCD_Chr_Big127
;MyGeiger_NT.mbas,706 :: 		for hh = 0 to 11
	CLRF        LCD_Chr_Big_hh+0 
L__LCD_Chr_Big130:
;MyGeiger_NT.mbas,707 :: 		Soft_SPI_Write (Two[hh])
	MOVLW       _Two+0
	ADDWF       LCD_Chr_Big_hh+0, 0 
	MOVWF       TBLPTRL 
	MOVLW       hi_addr(_Two+0)
	MOVWF       TBLPTRH 
	MOVLW       0
	ADDWFC      TBLPTRH, 1 
	MOVLW       higher_addr(_Two+0)
	MOVWF       TBLPTRU 
	MOVLW       0
	ADDWFC      TBLPTRU, 1 
	TBLRD*+
	MOVFF       TABLAT+0, FARG_Soft_SPI_Write_sdata+0
	CALL        _Soft_SPI_Write+0, 0
;MyGeiger_NT.mbas,708 :: 		next hh
	MOVF        LCD_Chr_Big_hh+0, 0 
	XORLW       11
	BTFSC       STATUS+0, 2 
	GOTO        L__LCD_Chr_Big133
	INCF        LCD_Chr_Big_hh+0, 1 
	GOTO        L__LCD_Chr_Big130
L__LCD_Chr_Big133:
;MyGeiger_NT.mbas,709 :: 		PositionLCD (px, py)
	MOVF        FARG_LCD_Chr_Big_px+0, 0 
	MOVWF       FARG_PositionLCD_x+0 
	MOVF        FARG_LCD_Chr_Big_py+0, 0 
	MOVWF       FARG_PositionLCD_y+0 
	CALL        _PositionLCD+0, 0
;MyGeiger_NT.mbas,710 :: 		for hh = 12 to 23
	MOVLW       12
	MOVWF       LCD_Chr_Big_hh+0 
L__LCD_Chr_Big135:
;MyGeiger_NT.mbas,711 :: 		Soft_SPI_Write (Two[hh])
	MOVLW       _Two+0
	ADDWF       LCD_Chr_Big_hh+0, 0 
	MOVWF       TBLPTRL 
	MOVLW       hi_addr(_Two+0)
	MOVWF       TBLPTRH 
	MOVLW       0
	ADDWFC      TBLPTRH, 1 
	MOVLW       higher_addr(_Two+0)
	MOVWF       TBLPTRU 
	MOVLW       0
	ADDWFC      TBLPTRU, 1 
	TBLRD*+
	MOVFF       TABLAT+0, FARG_Soft_SPI_Write_sdata+0
	CALL        _Soft_SPI_Write+0, 0
;MyGeiger_NT.mbas,712 :: 		next hh
	MOVF        LCD_Chr_Big_hh+0, 0 
	XORLW       23
	BTFSC       STATUS+0, 2 
	GOTO        L__LCD_Chr_Big138
	INCF        LCD_Chr_Big_hh+0, 1 
	GOTO        L__LCD_Chr_Big135
L__LCD_Chr_Big138:
L__LCD_Chr_Big127:
;MyGeiger_NT.mbas,715 :: 		if digit = "3" then
	MOVF        FARG_LCD_Chr_Big_digit+0, 0 
	XORLW       51
	BTFSS       STATUS+0, 2 
	GOTO        L__LCD_Chr_Big140
;MyGeiger_NT.mbas,716 :: 		for hh = 0 to 11
	CLRF        LCD_Chr_Big_hh+0 
L__LCD_Chr_Big143:
;MyGeiger_NT.mbas,717 :: 		Soft_SPI_Write (Thre[hh])
	MOVLW       _Thre+0
	ADDWF       LCD_Chr_Big_hh+0, 0 
	MOVWF       TBLPTRL 
	MOVLW       hi_addr(_Thre+0)
	MOVWF       TBLPTRH 
	MOVLW       0
	ADDWFC      TBLPTRH, 1 
	MOVLW       higher_addr(_Thre+0)
	MOVWF       TBLPTRU 
	MOVLW       0
	ADDWFC      TBLPTRU, 1 
	TBLRD*+
	MOVFF       TABLAT+0, FARG_Soft_SPI_Write_sdata+0
	CALL        _Soft_SPI_Write+0, 0
;MyGeiger_NT.mbas,718 :: 		next hh
	MOVF        LCD_Chr_Big_hh+0, 0 
	XORLW       11
	BTFSC       STATUS+0, 2 
	GOTO        L__LCD_Chr_Big146
	INCF        LCD_Chr_Big_hh+0, 1 
	GOTO        L__LCD_Chr_Big143
L__LCD_Chr_Big146:
;MyGeiger_NT.mbas,719 :: 		PositionLCD (px, py)
	MOVF        FARG_LCD_Chr_Big_px+0, 0 
	MOVWF       FARG_PositionLCD_x+0 
	MOVF        FARG_LCD_Chr_Big_py+0, 0 
	MOVWF       FARG_PositionLCD_y+0 
	CALL        _PositionLCD+0, 0
;MyGeiger_NT.mbas,720 :: 		for hh = 12 to 23
	MOVLW       12
	MOVWF       LCD_Chr_Big_hh+0 
L__LCD_Chr_Big148:
;MyGeiger_NT.mbas,721 :: 		Soft_SPI_Write (Thre[hh])
	MOVLW       _Thre+0
	ADDWF       LCD_Chr_Big_hh+0, 0 
	MOVWF       TBLPTRL 
	MOVLW       hi_addr(_Thre+0)
	MOVWF       TBLPTRH 
	MOVLW       0
	ADDWFC      TBLPTRH, 1 
	MOVLW       higher_addr(_Thre+0)
	MOVWF       TBLPTRU 
	MOVLW       0
	ADDWFC      TBLPTRU, 1 
	TBLRD*+
	MOVFF       TABLAT+0, FARG_Soft_SPI_Write_sdata+0
	CALL        _Soft_SPI_Write+0, 0
;MyGeiger_NT.mbas,722 :: 		next hh
	MOVF        LCD_Chr_Big_hh+0, 0 
	XORLW       23
	BTFSC       STATUS+0, 2 
	GOTO        L__LCD_Chr_Big151
	INCF        LCD_Chr_Big_hh+0, 1 
	GOTO        L__LCD_Chr_Big148
L__LCD_Chr_Big151:
L__LCD_Chr_Big140:
;MyGeiger_NT.mbas,725 :: 		if digit = "4" then
	MOVF        FARG_LCD_Chr_Big_digit+0, 0 
	XORLW       52
	BTFSS       STATUS+0, 2 
	GOTO        L__LCD_Chr_Big153
;MyGeiger_NT.mbas,726 :: 		for hh = 0 to 11
	CLRF        LCD_Chr_Big_hh+0 
L__LCD_Chr_Big156:
;MyGeiger_NT.mbas,727 :: 		Soft_SPI_Write (Four[hh])
	MOVLW       _Four+0
	ADDWF       LCD_Chr_Big_hh+0, 0 
	MOVWF       TBLPTRL 
	MOVLW       hi_addr(_Four+0)
	MOVWF       TBLPTRH 
	MOVLW       0
	ADDWFC      TBLPTRH, 1 
	MOVLW       higher_addr(_Four+0)
	MOVWF       TBLPTRU 
	MOVLW       0
	ADDWFC      TBLPTRU, 1 
	TBLRD*+
	MOVFF       TABLAT+0, FARG_Soft_SPI_Write_sdata+0
	CALL        _Soft_SPI_Write+0, 0
;MyGeiger_NT.mbas,728 :: 		next hh
	MOVF        LCD_Chr_Big_hh+0, 0 
	XORLW       11
	BTFSC       STATUS+0, 2 
	GOTO        L__LCD_Chr_Big159
	INCF        LCD_Chr_Big_hh+0, 1 
	GOTO        L__LCD_Chr_Big156
L__LCD_Chr_Big159:
;MyGeiger_NT.mbas,729 :: 		PositionLCD (px, py)
	MOVF        FARG_LCD_Chr_Big_px+0, 0 
	MOVWF       FARG_PositionLCD_x+0 
	MOVF        FARG_LCD_Chr_Big_py+0, 0 
	MOVWF       FARG_PositionLCD_y+0 
	CALL        _PositionLCD+0, 0
;MyGeiger_NT.mbas,730 :: 		for hh = 12 to 23
	MOVLW       12
	MOVWF       LCD_Chr_Big_hh+0 
L__LCD_Chr_Big161:
;MyGeiger_NT.mbas,731 :: 		Soft_SPI_Write (Four[hh])
	MOVLW       _Four+0
	ADDWF       LCD_Chr_Big_hh+0, 0 
	MOVWF       TBLPTRL 
	MOVLW       hi_addr(_Four+0)
	MOVWF       TBLPTRH 
	MOVLW       0
	ADDWFC      TBLPTRH, 1 
	MOVLW       higher_addr(_Four+0)
	MOVWF       TBLPTRU 
	MOVLW       0
	ADDWFC      TBLPTRU, 1 
	TBLRD*+
	MOVFF       TABLAT+0, FARG_Soft_SPI_Write_sdata+0
	CALL        _Soft_SPI_Write+0, 0
;MyGeiger_NT.mbas,732 :: 		next hh
	MOVF        LCD_Chr_Big_hh+0, 0 
	XORLW       23
	BTFSC       STATUS+0, 2 
	GOTO        L__LCD_Chr_Big164
	INCF        LCD_Chr_Big_hh+0, 1 
	GOTO        L__LCD_Chr_Big161
L__LCD_Chr_Big164:
L__LCD_Chr_Big153:
;MyGeiger_NT.mbas,735 :: 		if digit = "5" then
	MOVF        FARG_LCD_Chr_Big_digit+0, 0 
	XORLW       53
	BTFSS       STATUS+0, 2 
	GOTO        L__LCD_Chr_Big166
;MyGeiger_NT.mbas,736 :: 		for hh = 0 to 11
	CLRF        LCD_Chr_Big_hh+0 
L__LCD_Chr_Big169:
;MyGeiger_NT.mbas,737 :: 		Soft_SPI_Write (Five[hh])
	MOVLW       _Five+0
	ADDWF       LCD_Chr_Big_hh+0, 0 
	MOVWF       TBLPTRL 
	MOVLW       hi_addr(_Five+0)
	MOVWF       TBLPTRH 
	MOVLW       0
	ADDWFC      TBLPTRH, 1 
	MOVLW       higher_addr(_Five+0)
	MOVWF       TBLPTRU 
	MOVLW       0
	ADDWFC      TBLPTRU, 1 
	TBLRD*+
	MOVFF       TABLAT+0, FARG_Soft_SPI_Write_sdata+0
	CALL        _Soft_SPI_Write+0, 0
;MyGeiger_NT.mbas,738 :: 		next hh
	MOVF        LCD_Chr_Big_hh+0, 0 
	XORLW       11
	BTFSC       STATUS+0, 2 
	GOTO        L__LCD_Chr_Big172
	INCF        LCD_Chr_Big_hh+0, 1 
	GOTO        L__LCD_Chr_Big169
L__LCD_Chr_Big172:
;MyGeiger_NT.mbas,739 :: 		PositionLCD (px, py)
	MOVF        FARG_LCD_Chr_Big_px+0, 0 
	MOVWF       FARG_PositionLCD_x+0 
	MOVF        FARG_LCD_Chr_Big_py+0, 0 
	MOVWF       FARG_PositionLCD_y+0 
	CALL        _PositionLCD+0, 0
;MyGeiger_NT.mbas,740 :: 		for hh = 12 to 23
	MOVLW       12
	MOVWF       LCD_Chr_Big_hh+0 
L__LCD_Chr_Big174:
;MyGeiger_NT.mbas,741 :: 		Soft_SPI_Write (Five[hh])
	MOVLW       _Five+0
	ADDWF       LCD_Chr_Big_hh+0, 0 
	MOVWF       TBLPTRL 
	MOVLW       hi_addr(_Five+0)
	MOVWF       TBLPTRH 
	MOVLW       0
	ADDWFC      TBLPTRH, 1 
	MOVLW       higher_addr(_Five+0)
	MOVWF       TBLPTRU 
	MOVLW       0
	ADDWFC      TBLPTRU, 1 
	TBLRD*+
	MOVFF       TABLAT+0, FARG_Soft_SPI_Write_sdata+0
	CALL        _Soft_SPI_Write+0, 0
;MyGeiger_NT.mbas,742 :: 		next hh
	MOVF        LCD_Chr_Big_hh+0, 0 
	XORLW       23
	BTFSC       STATUS+0, 2 
	GOTO        L__LCD_Chr_Big177
	INCF        LCD_Chr_Big_hh+0, 1 
	GOTO        L__LCD_Chr_Big174
L__LCD_Chr_Big177:
L__LCD_Chr_Big166:
;MyGeiger_NT.mbas,745 :: 		if digit = "6" then
	MOVF        FARG_LCD_Chr_Big_digit+0, 0 
	XORLW       54
	BTFSS       STATUS+0, 2 
	GOTO        L__LCD_Chr_Big179
;MyGeiger_NT.mbas,746 :: 		for hh = 0 to 11
	CLRF        LCD_Chr_Big_hh+0 
L__LCD_Chr_Big182:
;MyGeiger_NT.mbas,747 :: 		Soft_SPI_Write (Six[hh])
	MOVLW       _Six+0
	ADDWF       LCD_Chr_Big_hh+0, 0 
	MOVWF       TBLPTRL 
	MOVLW       hi_addr(_Six+0)
	MOVWF       TBLPTRH 
	MOVLW       0
	ADDWFC      TBLPTRH, 1 
	MOVLW       higher_addr(_Six+0)
	MOVWF       TBLPTRU 
	MOVLW       0
	ADDWFC      TBLPTRU, 1 
	TBLRD*+
	MOVFF       TABLAT+0, FARG_Soft_SPI_Write_sdata+0
	CALL        _Soft_SPI_Write+0, 0
;MyGeiger_NT.mbas,748 :: 		next hh
	MOVF        LCD_Chr_Big_hh+0, 0 
	XORLW       11
	BTFSC       STATUS+0, 2 
	GOTO        L__LCD_Chr_Big185
	INCF        LCD_Chr_Big_hh+0, 1 
	GOTO        L__LCD_Chr_Big182
L__LCD_Chr_Big185:
;MyGeiger_NT.mbas,749 :: 		PositionLCD (px, py)
	MOVF        FARG_LCD_Chr_Big_px+0, 0 
	MOVWF       FARG_PositionLCD_x+0 
	MOVF        FARG_LCD_Chr_Big_py+0, 0 
	MOVWF       FARG_PositionLCD_y+0 
	CALL        _PositionLCD+0, 0
;MyGeiger_NT.mbas,750 :: 		for hh = 12 to 23
	MOVLW       12
	MOVWF       LCD_Chr_Big_hh+0 
L__LCD_Chr_Big187:
;MyGeiger_NT.mbas,751 :: 		Soft_SPI_Write (Six[hh])
	MOVLW       _Six+0
	ADDWF       LCD_Chr_Big_hh+0, 0 
	MOVWF       TBLPTRL 
	MOVLW       hi_addr(_Six+0)
	MOVWF       TBLPTRH 
	MOVLW       0
	ADDWFC      TBLPTRH, 1 
	MOVLW       higher_addr(_Six+0)
	MOVWF       TBLPTRU 
	MOVLW       0
	ADDWFC      TBLPTRU, 1 
	TBLRD*+
	MOVFF       TABLAT+0, FARG_Soft_SPI_Write_sdata+0
	CALL        _Soft_SPI_Write+0, 0
;MyGeiger_NT.mbas,752 :: 		next hh
	MOVF        LCD_Chr_Big_hh+0, 0 
	XORLW       23
	BTFSC       STATUS+0, 2 
	GOTO        L__LCD_Chr_Big190
	INCF        LCD_Chr_Big_hh+0, 1 
	GOTO        L__LCD_Chr_Big187
L__LCD_Chr_Big190:
L__LCD_Chr_Big179:
;MyGeiger_NT.mbas,755 :: 		if digit = "7" then
	MOVF        FARG_LCD_Chr_Big_digit+0, 0 
	XORLW       55
	BTFSS       STATUS+0, 2 
	GOTO        L__LCD_Chr_Big192
;MyGeiger_NT.mbas,756 :: 		for hh = 0 to 11
	CLRF        LCD_Chr_Big_hh+0 
L__LCD_Chr_Big195:
;MyGeiger_NT.mbas,757 :: 		Soft_SPI_Write (Seven[hh])
	MOVLW       _Seven+0
	ADDWF       LCD_Chr_Big_hh+0, 0 
	MOVWF       TBLPTRL 
	MOVLW       hi_addr(_Seven+0)
	MOVWF       TBLPTRH 
	MOVLW       0
	ADDWFC      TBLPTRH, 1 
	MOVLW       higher_addr(_Seven+0)
	MOVWF       TBLPTRU 
	MOVLW       0
	ADDWFC      TBLPTRU, 1 
	TBLRD*+
	MOVFF       TABLAT+0, FARG_Soft_SPI_Write_sdata+0
	CALL        _Soft_SPI_Write+0, 0
;MyGeiger_NT.mbas,758 :: 		next hh
	MOVF        LCD_Chr_Big_hh+0, 0 
	XORLW       11
	BTFSC       STATUS+0, 2 
	GOTO        L__LCD_Chr_Big198
	INCF        LCD_Chr_Big_hh+0, 1 
	GOTO        L__LCD_Chr_Big195
L__LCD_Chr_Big198:
;MyGeiger_NT.mbas,759 :: 		PositionLCD(px, py)
	MOVF        FARG_LCD_Chr_Big_px+0, 0 
	MOVWF       FARG_PositionLCD_x+0 
	MOVF        FARG_LCD_Chr_Big_py+0, 0 
	MOVWF       FARG_PositionLCD_y+0 
	CALL        _PositionLCD+0, 0
;MyGeiger_NT.mbas,760 :: 		for hh = 12 to 23
	MOVLW       12
	MOVWF       LCD_Chr_Big_hh+0 
L__LCD_Chr_Big200:
;MyGeiger_NT.mbas,761 :: 		Soft_SPI_Write (Seven[hh])
	MOVLW       _Seven+0
	ADDWF       LCD_Chr_Big_hh+0, 0 
	MOVWF       TBLPTRL 
	MOVLW       hi_addr(_Seven+0)
	MOVWF       TBLPTRH 
	MOVLW       0
	ADDWFC      TBLPTRH, 1 
	MOVLW       higher_addr(_Seven+0)
	MOVWF       TBLPTRU 
	MOVLW       0
	ADDWFC      TBLPTRU, 1 
	TBLRD*+
	MOVFF       TABLAT+0, FARG_Soft_SPI_Write_sdata+0
	CALL        _Soft_SPI_Write+0, 0
;MyGeiger_NT.mbas,762 :: 		next hh
	MOVF        LCD_Chr_Big_hh+0, 0 
	XORLW       23
	BTFSC       STATUS+0, 2 
	GOTO        L__LCD_Chr_Big203
	INCF        LCD_Chr_Big_hh+0, 1 
	GOTO        L__LCD_Chr_Big200
L__LCD_Chr_Big203:
L__LCD_Chr_Big192:
;MyGeiger_NT.mbas,765 :: 		if digit = "8" then
	MOVF        FARG_LCD_Chr_Big_digit+0, 0 
	XORLW       56
	BTFSS       STATUS+0, 2 
	GOTO        L__LCD_Chr_Big205
;MyGeiger_NT.mbas,766 :: 		for hh = 0 to 11
	CLRF        LCD_Chr_Big_hh+0 
L__LCD_Chr_Big208:
;MyGeiger_NT.mbas,767 :: 		Soft_SPI_Write (Eight[hh])
	MOVLW       _Eight+0
	ADDWF       LCD_Chr_Big_hh+0, 0 
	MOVWF       TBLPTRL 
	MOVLW       hi_addr(_Eight+0)
	MOVWF       TBLPTRH 
	MOVLW       0
	ADDWFC      TBLPTRH, 1 
	MOVLW       higher_addr(_Eight+0)
	MOVWF       TBLPTRU 
	MOVLW       0
	ADDWFC      TBLPTRU, 1 
	TBLRD*+
	MOVFF       TABLAT+0, FARG_Soft_SPI_Write_sdata+0
	CALL        _Soft_SPI_Write+0, 0
;MyGeiger_NT.mbas,768 :: 		next hh
	MOVF        LCD_Chr_Big_hh+0, 0 
	XORLW       11
	BTFSC       STATUS+0, 2 
	GOTO        L__LCD_Chr_Big211
	INCF        LCD_Chr_Big_hh+0, 1 
	GOTO        L__LCD_Chr_Big208
L__LCD_Chr_Big211:
;MyGeiger_NT.mbas,769 :: 		PositionLCD (px, py)
	MOVF        FARG_LCD_Chr_Big_px+0, 0 
	MOVWF       FARG_PositionLCD_x+0 
	MOVF        FARG_LCD_Chr_Big_py+0, 0 
	MOVWF       FARG_PositionLCD_y+0 
	CALL        _PositionLCD+0, 0
;MyGeiger_NT.mbas,770 :: 		for hh = 12 to 23
	MOVLW       12
	MOVWF       LCD_Chr_Big_hh+0 
L__LCD_Chr_Big213:
;MyGeiger_NT.mbas,771 :: 		Soft_SPI_Write (Eight[hh])
	MOVLW       _Eight+0
	ADDWF       LCD_Chr_Big_hh+0, 0 
	MOVWF       TBLPTRL 
	MOVLW       hi_addr(_Eight+0)
	MOVWF       TBLPTRH 
	MOVLW       0
	ADDWFC      TBLPTRH, 1 
	MOVLW       higher_addr(_Eight+0)
	MOVWF       TBLPTRU 
	MOVLW       0
	ADDWFC      TBLPTRU, 1 
	TBLRD*+
	MOVFF       TABLAT+0, FARG_Soft_SPI_Write_sdata+0
	CALL        _Soft_SPI_Write+0, 0
;MyGeiger_NT.mbas,772 :: 		next hh
	MOVF        LCD_Chr_Big_hh+0, 0 
	XORLW       23
	BTFSC       STATUS+0, 2 
	GOTO        L__LCD_Chr_Big216
	INCF        LCD_Chr_Big_hh+0, 1 
	GOTO        L__LCD_Chr_Big213
L__LCD_Chr_Big216:
L__LCD_Chr_Big205:
;MyGeiger_NT.mbas,775 :: 		if digit = "9" then
	MOVF        FARG_LCD_Chr_Big_digit+0, 0 
	XORLW       57
	BTFSS       STATUS+0, 2 
	GOTO        L__LCD_Chr_Big218
;MyGeiger_NT.mbas,776 :: 		for hh = 0 to 11
	CLRF        LCD_Chr_Big_hh+0 
L__LCD_Chr_Big221:
;MyGeiger_NT.mbas,777 :: 		Soft_SPI_Write (Nine[hh])
	MOVLW       _Nine+0
	ADDWF       LCD_Chr_Big_hh+0, 0 
	MOVWF       TBLPTRL 
	MOVLW       hi_addr(_Nine+0)
	MOVWF       TBLPTRH 
	MOVLW       0
	ADDWFC      TBLPTRH, 1 
	MOVLW       higher_addr(_Nine+0)
	MOVWF       TBLPTRU 
	MOVLW       0
	ADDWFC      TBLPTRU, 1 
	TBLRD*+
	MOVFF       TABLAT+0, FARG_Soft_SPI_Write_sdata+0
	CALL        _Soft_SPI_Write+0, 0
;MyGeiger_NT.mbas,778 :: 		next hh
	MOVF        LCD_Chr_Big_hh+0, 0 
	XORLW       11
	BTFSC       STATUS+0, 2 
	GOTO        L__LCD_Chr_Big224
	INCF        LCD_Chr_Big_hh+0, 1 
	GOTO        L__LCD_Chr_Big221
L__LCD_Chr_Big224:
;MyGeiger_NT.mbas,779 :: 		PositionLCD (px, py)
	MOVF        FARG_LCD_Chr_Big_px+0, 0 
	MOVWF       FARG_PositionLCD_x+0 
	MOVF        FARG_LCD_Chr_Big_py+0, 0 
	MOVWF       FARG_PositionLCD_y+0 
	CALL        _PositionLCD+0, 0
;MyGeiger_NT.mbas,780 :: 		for hh = 12 to 23
	MOVLW       12
	MOVWF       LCD_Chr_Big_hh+0 
L__LCD_Chr_Big226:
;MyGeiger_NT.mbas,781 :: 		Soft_SPI_Write (Nine[hh])
	MOVLW       _Nine+0
	ADDWF       LCD_Chr_Big_hh+0, 0 
	MOVWF       TBLPTRL 
	MOVLW       hi_addr(_Nine+0)
	MOVWF       TBLPTRH 
	MOVLW       0
	ADDWFC      TBLPTRH, 1 
	MOVLW       higher_addr(_Nine+0)
	MOVWF       TBLPTRU 
	MOVLW       0
	ADDWFC      TBLPTRU, 1 
	TBLRD*+
	MOVFF       TABLAT+0, FARG_Soft_SPI_Write_sdata+0
	CALL        _Soft_SPI_Write+0, 0
;MyGeiger_NT.mbas,782 :: 		next hh
	MOVF        LCD_Chr_Big_hh+0, 0 
	XORLW       23
	BTFSC       STATUS+0, 2 
	GOTO        L__LCD_Chr_Big229
	INCF        LCD_Chr_Big_hh+0, 1 
	GOTO        L__LCD_Chr_Big226
L__LCD_Chr_Big229:
L__LCD_Chr_Big218:
;MyGeiger_NT.mbas,785 :: 		end sub
L_end_LCD_Chr_Big:
	RETURN      0
; end of _LCD_Chr_Big

_NOK_Print:

;MyGeiger_NT.mbas,786 :: 		sub procedure NOK_Print(dim poloska as byte)
;MyGeiger_NT.mbas,787 :: 		Soft_SPI_Write(poloska)
	MOVF        FARG_NOK_Print_poloska+0, 0 
	MOVWF       FARG_Soft_SPI_Write_sdata+0 
	CALL        _Soft_SPI_Write+0, 0
;MyGeiger_NT.mbas,788 :: 		end sub
L_end_NOK_Print:
	RETURN      0
; end of _NOK_Print

_Display_Logo:

;MyGeiger_NT.mbas,792 :: 		zz as word
;MyGeiger_NT.mbas,793 :: 		zz = 0
	CLRF        Display_Logo_zz+0 
	CLRF        Display_Logo_zz+1 
;MyGeiger_NT.mbas,794 :: 		for xx = 0 to 7
	CLRF        Display_Logo_xx+0 
L__Display_Logo233:
;MyGeiger_NT.mbas,795 :: 		PositionLCD (0, xx)
	CLRF        FARG_PositionLCD_x+0 
	MOVF        Display_Logo_xx+0, 0 
	MOVWF       FARG_PositionLCD_y+0 
	CALL        _PositionLCD+0, 0
;MyGeiger_NT.mbas,796 :: 		for yy = 0 to 127
	CLRF        Display_Logo_yy+0 
L__Display_Logo238:
;MyGeiger_NT.mbas,797 :: 		Soft_SPI_Write (rh_logo[zz+yy])
	MOVF        Display_Logo_yy+0, 0 
	ADDWF       Display_Logo_zz+0, 0 
	MOVWF       R0 
	MOVLW       0
	ADDWFC      Display_Logo_zz+1, 0 
	MOVWF       R1 
	MOVLW       _rh_logo+0
	ADDWF       R0, 0 
	MOVWF       TBLPTRL 
	MOVLW       hi_addr(_rh_logo+0)
	ADDWFC      R1, 0 
	MOVWF       TBLPTRH 
	MOVLW       higher_addr(_rh_logo+0)
	MOVWF       TBLPTRU 
	MOVLW       0
	ADDWFC      TBLPTRU, 1 
	TBLRD*+
	MOVFF       TABLAT+0, FARG_Soft_SPI_Write_sdata+0
	CALL        _Soft_SPI_Write+0, 0
;MyGeiger_NT.mbas,798 :: 		next yy
	MOVF        Display_Logo_yy+0, 0 
	XORLW       127
	BTFSC       STATUS+0, 2 
	GOTO        L__Display_Logo241
	INCF        Display_Logo_yy+0, 1 
	GOTO        L__Display_Logo238
L__Display_Logo241:
;MyGeiger_NT.mbas,799 :: 		zz = zz+128
	MOVLW       128
	ADDWF       Display_Logo_zz+0, 1 
	MOVLW       0
	ADDWFC      Display_Logo_zz+1, 1 
;MyGeiger_NT.mbas,800 :: 		next xx
	MOVF        Display_Logo_xx+0, 0 
	XORLW       7
	BTFSC       STATUS+0, 2 
	GOTO        L__Display_Logo236
	INCF        Display_Logo_xx+0, 1 
	GOTO        L__Display_Logo233
L__Display_Logo236:
;MyGeiger_NT.mbas,801 :: 		end sub
L_end_Display_Logo:
	RETURN      0
; end of _Display_Logo

_halt_system:

;MyGeiger_NT.mbas,805 :: 		zz as word
;MyGeiger_NT.mbas,806 :: 		zz = 0
	CLRF        halt_system_zz+0 
	CLRF        halt_system_zz+1 
;MyGeiger_NT.mbas,807 :: 		for xx = 0 to 7
	CLRF        halt_system_xx+0 
L__halt_system244:
;MyGeiger_NT.mbas,808 :: 		PositionLCD (0, xx)
	CLRF        FARG_PositionLCD_x+0 
	MOVF        halt_system_xx+0, 0 
	MOVWF       FARG_PositionLCD_y+0 
	CALL        _PositionLCD+0, 0
;MyGeiger_NT.mbas,809 :: 		for yy = 0 to 127
	CLRF        halt_system_yy+0 
L__halt_system249:
;MyGeiger_NT.mbas,810 :: 		Soft_SPI_Write (lowbat[zz+yy])
	MOVF        halt_system_yy+0, 0 
	ADDWF       halt_system_zz+0, 0 
	MOVWF       R0 
	MOVLW       0
	ADDWFC      halt_system_zz+1, 0 
	MOVWF       R1 
	MOVLW       _lowbat+0
	ADDWF       R0, 0 
	MOVWF       TBLPTRL 
	MOVLW       hi_addr(_lowbat+0)
	ADDWFC      R1, 0 
	MOVWF       TBLPTRH 
	MOVLW       higher_addr(_lowbat+0)
	MOVWF       TBLPTRU 
	MOVLW       0
	ADDWFC      TBLPTRU, 1 
	TBLRD*+
	MOVFF       TABLAT+0, FARG_Soft_SPI_Write_sdata+0
	CALL        _Soft_SPI_Write+0, 0
;MyGeiger_NT.mbas,811 :: 		next yy
	MOVF        halt_system_yy+0, 0 
	XORLW       127
	BTFSC       STATUS+0, 2 
	GOTO        L__halt_system252
	INCF        halt_system_yy+0, 1 
	GOTO        L__halt_system249
L__halt_system252:
;MyGeiger_NT.mbas,812 :: 		zz = zz+128
	MOVLW       128
	ADDWF       halt_system_zz+0, 1 
	MOVLW       0
	ADDWFC      halt_system_zz+1, 1 
;MyGeiger_NT.mbas,813 :: 		next xx
	MOVF        halt_system_xx+0, 0 
	XORLW       7
	BTFSC       STATUS+0, 2 
	GOTO        L__halt_system247
	INCF        halt_system_xx+0, 1 
	GOTO        L__halt_system244
L__halt_system247:
;MyGeiger_NT.mbas,814 :: 		LATA.2   = 0
	BCF         LATA+0, 2 
;MyGeiger_NT.mbas,815 :: 		LATB.3   = 0
	BCF         LATB+0, 3 
;MyGeiger_NT.mbas,816 :: 		LATA.5   = 0
	BCF         LATA+0, 5 
;MyGeiger_NT.mbas,817 :: 		TMR0IE_bit = 0
	BCF         TMR0IE_bit+0, BitPos(TMR0IE_bit+0) 
;MyGeiger_NT.mbas,818 :: 		TMR1IE_bit = 0
	BCF         TMR1IE_bit+0, BitPos(TMR1IE_bit+0) 
;MyGeiger_NT.mbas,819 :: 		TMR2IE_bit = 0
	BCF         TMR2IE_bit+0, BitPos(TMR2IE_bit+0) 
;MyGeiger_NT.mbas,820 :: 		TMR3IE_bit = 0
	BCF         TMR3IE_bit+0, BitPos(TMR3IE_bit+0) 
;MyGeiger_NT.mbas,821 :: 		INT0IE_bit = 0
	BCF         INT0IE_bit+0, BitPos(INT0IE_bit+0) 
;MyGeiger_NT.mbas,822 :: 		CCP1CON    = %00000000
	CLRF        CCP1CON+0 
;MyGeiger_NT.mbas,823 :: 		PORTC.2    = 0
	BCF         PORTC+0, 2 
;MyGeiger_NT.mbas,824 :: 		ADCON0     = %00000000
	CLRF        ADCON0+0 
;MyGeiger_NT.mbas,825 :: 		sleep
	SLEEP
;MyGeiger_NT.mbas,826 :: 		end sub
L_end_halt_system:
	RETURN      0
; end of _halt_system

_sendcpm:

;MyGeiger_NT.mbas,854 :: 		dim res1, v1 as byte
;MyGeiger_NT.mbas,855 :: 		ltrim (cpms)
	MOVF        FARG_sendcpm_cpms+0, 0 
	MOVWF       FARG_ltrim_astring+0 
	MOVF        FARG_sendcpm_cpms+1, 0 
	MOVWF       FARG_ltrim_astring+1 
	CALL        _ltrim+0, 0
;MyGeiger_NT.mbas,856 :: 		res1 = length(cpms)
	MOVF        FARG_sendcpm_cpms+0, 0 
	MOVWF       FARG_Length_Text+0 
	MOVF        FARG_sendcpm_cpms+1, 0 
	MOVWF       FARG_Length_Text+1 
	CALL        _Length+0, 0
	MOVF        R0, 0 
	MOVWF       sendcpm_res1+0 
;MyGeiger_NT.mbas,857 :: 		res1 = res1 -1
	DECF        R0, 0 
	MOVWF       sendcpm_res1+0 
;MyGeiger_NT.mbas,858 :: 		GIEH_bit = 0
	BCF         GIEH_bit+0, BitPos(GIEH_bit+0) 
;MyGeiger_NT.mbas,859 :: 		GIEL_bit = 0
	BCF         GIEL_bit+0, BitPos(GIEL_bit+0) 
;MyGeiger_NT.mbas,860 :: 		LATA.5  = 0
	BCF         LATA+0, 5 
;MyGeiger_NT.mbas,861 :: 		LATB.3 = 0
	BCF         LATB+0, 3 
;MyGeiger_NT.mbas,862 :: 		for v1 = 0 to res1
	CLRF        sendcpm_v1+0 
L__sendcpm254:
	MOVF        sendcpm_v1+0, 0 
	SUBWF       sendcpm_res1+0, 0 
	BTFSS       STATUS+0, 0 
	GOTO        L__sendcpm258
;MyGeiger_NT.mbas,863 :: 		Soft_UART_Write(cpms[v1])
	MOVF        sendcpm_v1+0, 0 
	ADDWF       FARG_sendcpm_cpms+0, 0 
	MOVWF       FSR0 
	MOVLW       0
	ADDWFC      FARG_sendcpm_cpms+1, 0 
	MOVWF       FSR0H 
	MOVF        POSTINC0+0, 0 
	MOVWF       FARG_Soft_UART_Write_udata+0 
	CALL        _Soft_UART_Write+0, 0
;MyGeiger_NT.mbas,864 :: 		next v1
	MOVF        sendcpm_v1+0, 0 
	XORWF       sendcpm_res1+0, 0 
	BTFSC       STATUS+0, 2 
	GOTO        L__sendcpm258
	INCF        sendcpm_v1+0, 1 
	GOTO        L__sendcpm254
L__sendcpm258:
;MyGeiger_NT.mbas,866 :: 		end sub
L_end_sendcpm:
	RETURN      0
; end of _sendcpm

_sendrandom:

;MyGeiger_NT.mbas,869 :: 		dim v2 as byte
;MyGeiger_NT.mbas,871 :: 		for v2 = 7 to 0 step -1
	MOVLW       7
	MOVWF       sendrandom_v2+0 
L__sendrandom261:
;MyGeiger_NT.mbas,872 :: 		Soft_UART_Write(randomtxt[v2])
	MOVF        sendrandom_v2+0, 0 
	ADDWF       FARG_sendrandom_randomtxt+0, 0 
	MOVWF       FSR0 
	MOVLW       0
	ADDWFC      FARG_sendrandom_randomtxt+1, 0 
	MOVWF       FSR0H 
	MOVF        POSTINC0+0, 0 
	MOVWF       FARG_Soft_UART_Write_udata+0 
	CALL        _Soft_UART_Write+0, 0
;MyGeiger_NT.mbas,873 :: 		next v2
	MOVF        sendrandom_v2+0, 0 
	XORLW       0
	BTFSC       STATUS+0, 2 
	GOTO        L__sendrandom264
	MOVLW       255
	ADDWF       sendrandom_v2+0, 1 
	GOTO        L__sendrandom261
L__sendrandom264:
;MyGeiger_NT.mbas,875 :: 		end sub
L_end_sendrandom:
	RETURN      0
; end of _sendrandom

_calibration:

;MyGeiger_NT.mbas,879 :: 		sub procedure calibration()
;MyGeiger_NT.mbas,880 :: 		GIE_bit = 0
	BCF         GIE_bit+0, BitPos(GIE_bit+0) 
;MyGeiger_NT.mbas,882 :: 		LATA.2   = 1 ' light
	BSF         LATA+0, 2 
;MyGeiger_NT.mbas,883 :: 		LATB.3 = 0
	BCF         LATB+0, 3 
;MyGeiger_NT.mbas,884 :: 		LATA.5  = 0
	BCF         LATA+0, 5 
;MyGeiger_NT.mbas,885 :: 		LATB.7  = 0             ' turn off alert on portb.7 and wait for button
	BCF         LATB+0, 7 
;MyGeiger_NT.mbas,886 :: 		TRISB.7 = 1             ' input
	BSF         TRISB+0, 7 
;MyGeiger_NT.mbas,888 :: 		ClearLCD()
	CALL        _ClearLCD+0, 0
;MyGeiger_NT.mbas,889 :: 		MyText_LCD(32,6,  "use to set:")
	MOVLW       32
	MOVWF       FARG_MyText_LCD_x+0 
	MOVLW       6
	MOVWF       FARG_MyText_LCD_y+0 
	MOVLW       117
	MOVWF       ?LocalText_calibration+0 
	MOVLW       115
	MOVWF       ?LocalText_calibration+1 
	MOVLW       101
	MOVWF       ?LocalText_calibration+2 
	MOVLW       32
	MOVWF       ?LocalText_calibration+3 
	MOVLW       116
	MOVWF       ?LocalText_calibration+4 
	MOVLW       111
	MOVWF       ?LocalText_calibration+5 
	MOVLW       32
	MOVWF       ?LocalText_calibration+6 
	MOVLW       115
	MOVWF       ?LocalText_calibration+7 
	MOVLW       101
	MOVWF       ?LocalText_calibration+8 
	MOVLW       116
	MOVWF       ?LocalText_calibration+9 
	MOVLW       58
	MOVWF       ?LocalText_calibration+10 
	CLRF        ?LocalText_calibration+11 
	MOVLW       ?LocalText_calibration+0
	MOVWF       FARG_MyText_LCD_sentance+0 
	MOVLW       hi_addr(?LocalText_calibration+0)
	MOVWF       FARG_MyText_LCD_sentance+1 
	CALL        _MyText_LCD+0, 0
;MyGeiger_NT.mbas,890 :: 		MyText_LCD(24, 7, "plus,minus,OK")
	MOVLW       24
	MOVWF       FARG_MyText_LCD_x+0 
	MOVLW       7
	MOVWF       FARG_MyText_LCD_y+0 
	MOVLW       112
	MOVWF       ?LocalText_calibration+0 
	MOVLW       108
	MOVWF       ?LocalText_calibration+1 
	MOVLW       117
	MOVWF       ?LocalText_calibration+2 
	MOVLW       115
	MOVWF       ?LocalText_calibration+3 
	MOVLW       44
	MOVWF       ?LocalText_calibration+4 
	MOVLW       109
	MOVWF       ?LocalText_calibration+5 
	MOVLW       105
	MOVWF       ?LocalText_calibration+6 
	MOVLW       110
	MOVWF       ?LocalText_calibration+7 
	MOVLW       117
	MOVWF       ?LocalText_calibration+8 
	MOVLW       115
	MOVWF       ?LocalText_calibration+9 
	MOVLW       44
	MOVWF       ?LocalText_calibration+10 
	MOVLW       79
	MOVWF       ?LocalText_calibration+11 
	MOVLW       75
	MOVWF       ?LocalText_calibration+12 
	CLRF        ?LocalText_calibration+13 
	MOVLW       ?LocalText_calibration+0
	MOVWF       FARG_MyText_LCD_sentance+0 
	MOVLW       hi_addr(?LocalText_calibration+0)
	MOVWF       FARG_MyText_LCD_sentance+1 
	CALL        _MyText_LCD+0, 0
;MyGeiger_NT.mbas,891 :: 		MyText_LCD(0,0, "CF=0.0")
	CLRF        FARG_MyText_LCD_x+0 
	CLRF        FARG_MyText_LCD_y+0 
	MOVLW       67
	MOVWF       ?LocalText_calibration+0 
	MOVLW       70
	MOVWF       ?LocalText_calibration+1 
	MOVLW       61
	MOVWF       ?LocalText_calibration+2 
	MOVLW       48
	MOVWF       ?LocalText_calibration+3 
	MOVLW       46
	MOVWF       ?LocalText_calibration+4 
	MOVLW       48
	MOVWF       ?LocalText_calibration+5 
	CLRF        ?LocalText_calibration+6 
	MOVLW       ?LocalText_calibration+0
	MOVWF       FARG_MyText_LCD_sentance+0 
	MOVLW       hi_addr(?LocalText_calibration+0)
	MOVWF       FARG_MyText_LCD_sentance+1 
	CALL        _MyText_LCD+0, 0
;MyGeiger_NT.mbas,892 :: 		ch = (CF div 100) mod 10
	MOVLW       100
	MOVWF       R4 
	MOVLW       0
	MOVWF       R5 
	MOVF        _CF+0, 0 
	MOVWF       R0 
	MOVLW       0
	MOVWF       R1 
	CALL        _Div_16x16_U+0, 0
	MOVLW       10
	MOVWF       R4 
	MOVLW       0
	MOVWF       R5 
	CALL        _Div_16x16_U+0, 0
	MOVF        R8, 0 
	MOVWF       R0 
	MOVF        R9, 0 
	MOVWF       R1 
	MOVF        R0, 0 
	MOVWF       _ch+0 
	MOVF        R1, 0 
	MOVWF       _ch+1 
;MyGeiger_NT.mbas,893 :: 		PositionLCD(36, 0)
	MOVLW       36
	MOVWF       FARG_PositionLCD_x+0 
	CLRF        FARG_PositionLCD_y+0 
	CALL        _PositionLCD+0, 0
;MyGeiger_NT.mbas,894 :: 		Char_LCD (48+ch)
	MOVF        _ch+0, 0 
	ADDLW       48
	MOVWF       FARG_Char_LCD_bykva+0 
	CALL        _Char_LCD+0, 0
;MyGeiger_NT.mbas,895 :: 		Soft_SPI_Write(0x00)
	CLRF        FARG_Soft_SPI_Write_sdata+0 
	CALL        _Soft_SPI_Write+0, 0
;MyGeiger_NT.mbas,896 :: 		ch = (CF div 10) mod 10
	MOVLW       10
	MOVWF       R4 
	MOVLW       0
	MOVWF       R5 
	MOVF        _CF+0, 0 
	MOVWF       R0 
	MOVLW       0
	MOVWF       R1 
	CALL        _Div_16x16_U+0, 0
	MOVLW       10
	MOVWF       R4 
	MOVLW       0
	MOVWF       R5 
	CALL        _Div_16x16_U+0, 0
	MOVF        R8, 0 
	MOVWF       R0 
	MOVF        R9, 0 
	MOVWF       R1 
	MOVF        R0, 0 
	MOVWF       _ch+0 
	MOVF        R1, 0 
	MOVWF       _ch+1 
;MyGeiger_NT.mbas,897 :: 		Char_LCD (48+ch)
	MOVF        R0, 0 
	ADDLW       48
	MOVWF       FARG_Char_LCD_bykva+0 
	CALL        _Char_LCD+0, 0
;MyGeiger_NT.mbas,898 :: 		Soft_SPI_Write(0x00)
	CLRF        FARG_Soft_SPI_Write_sdata+0 
	CALL        _Soft_SPI_Write+0, 0
;MyGeiger_NT.mbas,899 :: 		ch = CF mod 10
	MOVLW       10
	MOVWF       R4 
	MOVLW       0
	MOVWF       R5 
	MOVF        _CF+0, 0 
	MOVWF       R0 
	MOVLW       0
	MOVWF       R1 
	CALL        _Div_16x16_U+0, 0
	MOVF        R8, 0 
	MOVWF       R0 
	MOVF        R9, 0 
	MOVWF       R1 
	MOVF        R0, 0 
	MOVWF       _ch+0 
	MOVF        R1, 0 
	MOVWF       _ch+1 
;MyGeiger_NT.mbas,900 :: 		Char_LCD (48+ch)
	MOVF        R0, 0 
	ADDLW       48
	MOVWF       FARG_Char_LCD_bykva+0 
	CALL        _Char_LCD+0, 0
;MyGeiger_NT.mbas,901 :: 		Soft_SPI_Write(0x00)
	CLRF        FARG_Soft_SPI_Write_sdata+0 
	CALL        _Soft_SPI_Write+0, 0
;MyGeiger_NT.mbas,906 :: 		while (1)
L__calibration268:
;MyGeiger_NT.mbas,907 :: 		if Button (PORTB, 7, 150, 1) then
	MOVLW       PORTB+0
	MOVWF       FARG_Button_port+0 
	MOVLW       hi_addr(PORTB+0)
	MOVWF       FARG_Button_port+1 
	MOVLW       7
	MOVWF       FARG_Button_pin+0 
	MOVLW       150
	MOVWF       FARG_Button_time+0 
	MOVLW       1
	MOVWF       FARG_Button_activeState+0 
	CALL        _Button+0, 0
	MOVF        R0, 1 
	BTFSC       STATUS+0, 2 
	GOTO        L__calibration273
;MyGeiger_NT.mbas,908 :: 		inc (CF)
	INCF        _CF+0, 1 
;MyGeiger_NT.mbas,909 :: 		if CF> 0xFA then
	MOVF        _CF+0, 0 
	SUBLW       250
	BTFSC       STATUS+0, 0 
	GOTO        L__calibration276
;MyGeiger_NT.mbas,910 :: 		dec (CF)
	DECF        _CF+0, 1 
L__calibration276:
;MyGeiger_NT.mbas,912 :: 		ch = (CF div 100) mod 10
	MOVLW       100
	MOVWF       R4 
	MOVLW       0
	MOVWF       R5 
	MOVF        _CF+0, 0 
	MOVWF       R0 
	MOVLW       0
	MOVWF       R1 
	CALL        _Div_16x16_U+0, 0
	MOVLW       10
	MOVWF       R4 
	MOVLW       0
	MOVWF       R5 
	CALL        _Div_16x16_U+0, 0
	MOVF        R8, 0 
	MOVWF       R0 
	MOVF        R9, 0 
	MOVWF       R1 
	MOVF        R0, 0 
	MOVWF       _ch+0 
	MOVF        R1, 0 
	MOVWF       _ch+1 
;MyGeiger_NT.mbas,913 :: 		PositionLCD(36, 0)
	MOVLW       36
	MOVWF       FARG_PositionLCD_x+0 
	CLRF        FARG_PositionLCD_y+0 
	CALL        _PositionLCD+0, 0
;MyGeiger_NT.mbas,914 :: 		Char_LCD (48+ch)
	MOVF        _ch+0, 0 
	ADDLW       48
	MOVWF       FARG_Char_LCD_bykva+0 
	CALL        _Char_LCD+0, 0
;MyGeiger_NT.mbas,915 :: 		Soft_SPI_Write(0x00)
	CLRF        FARG_Soft_SPI_Write_sdata+0 
	CALL        _Soft_SPI_Write+0, 0
;MyGeiger_NT.mbas,916 :: 		ch = (CF div 10) mod 10
	MOVLW       10
	MOVWF       R4 
	MOVLW       0
	MOVWF       R5 
	MOVF        _CF+0, 0 
	MOVWF       R0 
	MOVLW       0
	MOVWF       R1 
	CALL        _Div_16x16_U+0, 0
	MOVLW       10
	MOVWF       R4 
	MOVLW       0
	MOVWF       R5 
	CALL        _Div_16x16_U+0, 0
	MOVF        R8, 0 
	MOVWF       R0 
	MOVF        R9, 0 
	MOVWF       R1 
	MOVF        R0, 0 
	MOVWF       _ch+0 
	MOVF        R1, 0 
	MOVWF       _ch+1 
;MyGeiger_NT.mbas,917 :: 		Char_LCD (48+ch)
	MOVF        R0, 0 
	ADDLW       48
	MOVWF       FARG_Char_LCD_bykva+0 
	CALL        _Char_LCD+0, 0
;MyGeiger_NT.mbas,918 :: 		Soft_SPI_Write(0x00)
	CLRF        FARG_Soft_SPI_Write_sdata+0 
	CALL        _Soft_SPI_Write+0, 0
;MyGeiger_NT.mbas,919 :: 		ch = CF mod 10
	MOVLW       10
	MOVWF       R4 
	MOVLW       0
	MOVWF       R5 
	MOVF        _CF+0, 0 
	MOVWF       R0 
	MOVLW       0
	MOVWF       R1 
	CALL        _Div_16x16_U+0, 0
	MOVF        R8, 0 
	MOVWF       R0 
	MOVF        R9, 0 
	MOVWF       R1 
	MOVF        R0, 0 
	MOVWF       _ch+0 
	MOVF        R1, 0 
	MOVWF       _ch+1 
;MyGeiger_NT.mbas,920 :: 		Char_LCD (48+ch)
	MOVF        R0, 0 
	ADDLW       48
	MOVWF       FARG_Char_LCD_bykva+0 
	CALL        _Char_LCD+0, 0
;MyGeiger_NT.mbas,921 :: 		Soft_SPI_Write(0x00)
	CLRF        FARG_Soft_SPI_Write_sdata+0 
	CALL        _Soft_SPI_Write+0, 0
L__calibration273:
;MyGeiger_NT.mbas,925 :: 		if Button (PORTB, 6, 150, 1) then
	MOVLW       PORTB+0
	MOVWF       FARG_Button_port+0 
	MOVLW       hi_addr(PORTB+0)
	MOVWF       FARG_Button_port+1 
	MOVLW       6
	MOVWF       FARG_Button_pin+0 
	MOVLW       150
	MOVWF       FARG_Button_time+0 
	MOVLW       1
	MOVWF       FARG_Button_activeState+0 
	CALL        _Button+0, 0
	MOVF        R0, 1 
	BTFSC       STATUS+0, 2 
	GOTO        L__calibration279
;MyGeiger_NT.mbas,926 :: 		dec (CF)
	DECF        _CF+0, 1 
;MyGeiger_NT.mbas,927 :: 		if CF<0x01 then
	MOVLW       1
	SUBWF       _CF+0, 0 
	BTFSC       STATUS+0, 0 
	GOTO        L__calibration282
;MyGeiger_NT.mbas,928 :: 		inc (CF)
	INCF        _CF+0, 1 
L__calibration282:
;MyGeiger_NT.mbas,930 :: 		ch = (CF div 100) mod 10
	MOVLW       100
	MOVWF       R4 
	MOVLW       0
	MOVWF       R5 
	MOVF        _CF+0, 0 
	MOVWF       R0 
	MOVLW       0
	MOVWF       R1 
	CALL        _Div_16x16_U+0, 0
	MOVLW       10
	MOVWF       R4 
	MOVLW       0
	MOVWF       R5 
	CALL        _Div_16x16_U+0, 0
	MOVF        R8, 0 
	MOVWF       R0 
	MOVF        R9, 0 
	MOVWF       R1 
	MOVF        R0, 0 
	MOVWF       _ch+0 
	MOVF        R1, 0 
	MOVWF       _ch+1 
;MyGeiger_NT.mbas,931 :: 		PositionLCD(36, 0)
	MOVLW       36
	MOVWF       FARG_PositionLCD_x+0 
	CLRF        FARG_PositionLCD_y+0 
	CALL        _PositionLCD+0, 0
;MyGeiger_NT.mbas,932 :: 		Char_LCD (48+ch)
	MOVF        _ch+0, 0 
	ADDLW       48
	MOVWF       FARG_Char_LCD_bykva+0 
	CALL        _Char_LCD+0, 0
;MyGeiger_NT.mbas,933 :: 		Soft_SPI_Write(0x00)
	CLRF        FARG_Soft_SPI_Write_sdata+0 
	CALL        _Soft_SPI_Write+0, 0
;MyGeiger_NT.mbas,934 :: 		ch = (CF div 10) mod 10
	MOVLW       10
	MOVWF       R4 
	MOVLW       0
	MOVWF       R5 
	MOVF        _CF+0, 0 
	MOVWF       R0 
	MOVLW       0
	MOVWF       R1 
	CALL        _Div_16x16_U+0, 0
	MOVLW       10
	MOVWF       R4 
	MOVLW       0
	MOVWF       R5 
	CALL        _Div_16x16_U+0, 0
	MOVF        R8, 0 
	MOVWF       R0 
	MOVF        R9, 0 
	MOVWF       R1 
	MOVF        R0, 0 
	MOVWF       _ch+0 
	MOVF        R1, 0 
	MOVWF       _ch+1 
;MyGeiger_NT.mbas,935 :: 		Char_LCD (48+ch)
	MOVF        R0, 0 
	ADDLW       48
	MOVWF       FARG_Char_LCD_bykva+0 
	CALL        _Char_LCD+0, 0
;MyGeiger_NT.mbas,936 :: 		Soft_SPI_Write(0x00)
	CLRF        FARG_Soft_SPI_Write_sdata+0 
	CALL        _Soft_SPI_Write+0, 0
;MyGeiger_NT.mbas,937 :: 		ch = CF mod 10
	MOVLW       10
	MOVWF       R4 
	MOVLW       0
	MOVWF       R5 
	MOVF        _CF+0, 0 
	MOVWF       R0 
	MOVLW       0
	MOVWF       R1 
	CALL        _Div_16x16_U+0, 0
	MOVF        R8, 0 
	MOVWF       R0 
	MOVF        R9, 0 
	MOVWF       R1 
	MOVF        R0, 0 
	MOVWF       _ch+0 
	MOVF        R1, 0 
	MOVWF       _ch+1 
;MyGeiger_NT.mbas,938 :: 		Char_LCD (48+ch)
	MOVF        R0, 0 
	ADDLW       48
	MOVWF       FARG_Char_LCD_bykva+0 
	CALL        _Char_LCD+0, 0
;MyGeiger_NT.mbas,939 :: 		Soft_SPI_Write(0x00)
	CLRF        FARG_Soft_SPI_Write_sdata+0 
	CALL        _Soft_SPI_Write+0, 0
L__calibration279:
;MyGeiger_NT.mbas,943 :: 		if Button (PORTB, 5, 150, 1) then         'ok
	MOVLW       PORTB+0
	MOVWF       FARG_Button_port+0 
	MOVLW       hi_addr(PORTB+0)
	MOVWF       FARG_Button_port+1 
	MOVLW       5
	MOVWF       FARG_Button_pin+0 
	MOVLW       150
	MOVWF       FARG_Button_time+0 
	MOVLW       1
	MOVWF       FARG_Button_activeState+0 
	CALL        _Button+0, 0
	MOVF        R0, 1 
	BTFSC       STATUS+0, 2 
	GOTO        L__calibration285
;MyGeiger_NT.mbas,944 :: 		EEPROM_Write (0x00, CF)
	CLRF        FARG_EEPROM_Write_address+0 
	MOVF        _CF+0, 0 
	MOVWF       FARG_EEPROM_Write_data_+0 
	CALL        _EEPROM_Write+0, 0
;MyGeiger_NT.mbas,945 :: 		delay_ms(100)
	MOVLW       130
	MOVWF       R12, 0
	MOVLW       221
	MOVWF       R13, 0
L__calibration287:
	DECFSZ      R13, 1, 1
	BRA         L__calibration287
	DECFSZ      R12, 1, 1
	BRA         L__calibration287
	NOP
	NOP
;MyGeiger_NT.mbas,946 :: 		goto tube_limit
	GOTO        L__calibration_tube_limit
L__calibration285:
;MyGeiger_NT.mbas,948 :: 		wend
	GOTO        L__calibration268
;MyGeiger_NT.mbas,951 :: 		tube_limit:                                   ' set normal background limit
L__calibration_tube_limit:
;MyGeiger_NT.mbas,953 :: 		MyText_LCD(0,1, "BG=              CPM")
	CLRF        FARG_MyText_LCD_x+0 
	MOVLW       1
	MOVWF       FARG_MyText_LCD_y+0 
	MOVLW       66
	MOVWF       ?LocalText_calibration+0 
	MOVLW       71
	MOVWF       ?LocalText_calibration+1 
	MOVLW       61
	MOVWF       ?LocalText_calibration+2 
	MOVLW       32
	MOVWF       ?LocalText_calibration+3 
	MOVLW       32
	MOVWF       ?LocalText_calibration+4 
	MOVLW       32
	MOVWF       ?LocalText_calibration+5 
	MOVLW       32
	MOVWF       ?LocalText_calibration+6 
	MOVLW       32
	MOVWF       ?LocalText_calibration+7 
	MOVLW       32
	MOVWF       ?LocalText_calibration+8 
	MOVLW       32
	MOVWF       ?LocalText_calibration+9 
	MOVLW       32
	MOVWF       ?LocalText_calibration+10 
	MOVLW       32
	MOVWF       ?LocalText_calibration+11 
	MOVLW       32
	MOVWF       ?LocalText_calibration+12 
	MOVLW       32
	MOVWF       ?LocalText_calibration+13 
	MOVLW       32
	MOVWF       ?LocalText_calibration+14 
	MOVLW       32
	MOVWF       ?LocalText_calibration+15 
	MOVLW       32
	MOVWF       ?LocalText_calibration+16 
	MOVLW       67
	MOVWF       ?LocalText_calibration+17 
	MOVLW       80
	MOVWF       ?LocalText_calibration+18 
	MOVLW       77
	MOVWF       ?LocalText_calibration+19 
	CLRF        ?LocalText_calibration+20 
	MOVLW       ?LocalText_calibration+0
	MOVWF       FARG_MyText_LCD_sentance+0 
	MOVLW       hi_addr(?LocalText_calibration+0)
	MOVWF       FARG_MyText_LCD_sentance+1 
	CALL        _MyText_LCD+0, 0
;MyGeiger_NT.mbas,954 :: 		ByteToStr (BG, tube_limit_txt)
	MOVF        _BG+0, 0 
	MOVWF       FARG_ByteToStr_input+0 
	MOVLW       _tube_limit_txt+0
	MOVWF       FARG_ByteToStr_output+0 
	MOVLW       hi_addr(_tube_limit_txt+0)
	MOVWF       FARG_ByteToStr_output+1 
	CALL        _ByteToStr+0, 0
;MyGeiger_NT.mbas,955 :: 		MyText_LCD(20, 1, tube_limit_txt)
	MOVLW       20
	MOVWF       FARG_MyText_LCD_x+0 
	MOVLW       1
	MOVWF       FARG_MyText_LCD_y+0 
	MOVLW       _tube_limit_txt+0
	MOVWF       FARG_MyText_LCD_sentance+0 
	MOVLW       hi_addr(_tube_limit_txt+0)
	MOVWF       FARG_MyText_LCD_sentance+1 
	CALL        _MyText_LCD+0, 0
;MyGeiger_NT.mbas,957 :: 		while(1)
L__calibration291:
;MyGeiger_NT.mbas,958 :: 		if Button (PORTB, 7, 150, 1) then
	MOVLW       PORTB+0
	MOVWF       FARG_Button_port+0 
	MOVLW       hi_addr(PORTB+0)
	MOVWF       FARG_Button_port+1 
	MOVLW       7
	MOVWF       FARG_Button_pin+0 
	MOVLW       150
	MOVWF       FARG_Button_time+0 
	MOVLW       1
	MOVWF       FARG_Button_activeState+0 
	CALL        _Button+0, 0
	MOVF        R0, 1 
	BTFSC       STATUS+0, 2 
	GOTO        L__calibration296
;MyGeiger_NT.mbas,959 :: 		inc(BG)
	INCF        _BG+0, 1 
;MyGeiger_NT.mbas,960 :: 		if BG>254 then
	MOVF        _BG+0, 0 
	SUBLW       254
	BTFSC       STATUS+0, 0 
	GOTO        L__calibration299
;MyGeiger_NT.mbas,961 :: 		BG = 254
	MOVLW       254
	MOVWF       _BG+0 
L__calibration299:
;MyGeiger_NT.mbas,963 :: 		ByteToStr (BG, tube_limit_txt)
	MOVF        _BG+0, 0 
	MOVWF       FARG_ByteToStr_input+0 
	MOVLW       _tube_limit_txt+0
	MOVWF       FARG_ByteToStr_output+0 
	MOVLW       hi_addr(_tube_limit_txt+0)
	MOVWF       FARG_ByteToStr_output+1 
	CALL        _ByteToStr+0, 0
;MyGeiger_NT.mbas,964 :: 		MyText_LCD(20, 1, tube_limit_txt)
	MOVLW       20
	MOVWF       FARG_MyText_LCD_x+0 
	MOVLW       1
	MOVWF       FARG_MyText_LCD_y+0 
	MOVLW       _tube_limit_txt+0
	MOVWF       FARG_MyText_LCD_sentance+0 
	MOVLW       hi_addr(_tube_limit_txt+0)
	MOVWF       FARG_MyText_LCD_sentance+1 
	CALL        _MyText_LCD+0, 0
L__calibration296:
;MyGeiger_NT.mbas,967 :: 		if Button (PORTB, 6, 150, 1) then
	MOVLW       PORTB+0
	MOVWF       FARG_Button_port+0 
	MOVLW       hi_addr(PORTB+0)
	MOVWF       FARG_Button_port+1 
	MOVLW       6
	MOVWF       FARG_Button_pin+0 
	MOVLW       150
	MOVWF       FARG_Button_time+0 
	MOVLW       1
	MOVWF       FARG_Button_activeState+0 
	CALL        _Button+0, 0
	MOVF        R0, 1 
	BTFSC       STATUS+0, 2 
	GOTO        L__calibration302
;MyGeiger_NT.mbas,968 :: 		dec(BG)
	DECF        _BG+0, 1 
;MyGeiger_NT.mbas,969 :: 		if BG<3 then
	MOVLW       3
	SUBWF       _BG+0, 0 
	BTFSC       STATUS+0, 0 
	GOTO        L__calibration305
;MyGeiger_NT.mbas,970 :: 		BG = 3
	MOVLW       3
	MOVWF       _BG+0 
L__calibration305:
;MyGeiger_NT.mbas,972 :: 		ByteToStr (BG, tube_limit_txt)
	MOVF        _BG+0, 0 
	MOVWF       FARG_ByteToStr_input+0 
	MOVLW       _tube_limit_txt+0
	MOVWF       FARG_ByteToStr_output+0 
	MOVLW       hi_addr(_tube_limit_txt+0)
	MOVWF       FARG_ByteToStr_output+1 
	CALL        _ByteToStr+0, 0
;MyGeiger_NT.mbas,973 :: 		MyText_LCD(20, 1, tube_limit_txt)
	MOVLW       20
	MOVWF       FARG_MyText_LCD_x+0 
	MOVLW       1
	MOVWF       FARG_MyText_LCD_y+0 
	MOVLW       _tube_limit_txt+0
	MOVWF       FARG_MyText_LCD_sentance+0 
	MOVLW       hi_addr(_tube_limit_txt+0)
	MOVWF       FARG_MyText_LCD_sentance+1 
	CALL        _MyText_LCD+0, 0
L__calibration302:
;MyGeiger_NT.mbas,975 :: 		if Button (PORTB, 5, 150, 1) then         'ok
	MOVLW       PORTB+0
	MOVWF       FARG_Button_port+0 
	MOVLW       hi_addr(PORTB+0)
	MOVWF       FARG_Button_port+1 
	MOVLW       5
	MOVWF       FARG_Button_pin+0 
	MOVLW       150
	MOVWF       FARG_Button_time+0 
	MOVLW       1
	MOVWF       FARG_Button_activeState+0 
	CALL        _Button+0, 0
	MOVF        R0, 1 
	BTFSC       STATUS+0, 2 
	GOTO        L__calibration308
;MyGeiger_NT.mbas,976 :: 		DL = sqrt(BG) * 4.65 + 3
	MOVF        _BG+0, 0 
	MOVWF       R0 
	CALL        _Byte2Double+0, 0
	MOVF        R0, 0 
	MOVWF       FARG_sqrt_x+0 
	MOVF        R1, 0 
	MOVWF       FARG_sqrt_x+1 
	MOVF        R2, 0 
	MOVWF       FARG_sqrt_x+2 
	MOVF        R3, 0 
	MOVWF       FARG_sqrt_x+3 
	CALL        _sqrt+0, 0
	MOVLW       205
	MOVWF       R4 
	MOVLW       204
	MOVWF       R5 
	MOVLW       20
	MOVWF       R6 
	MOVLW       129
	MOVWF       R7 
	CALL        _Mul_32x32_FP+0, 0
	MOVLW       0
	MOVWF       R4 
	MOVLW       0
	MOVWF       R5 
	MOVLW       64
	MOVWF       R6 
	MOVLW       128
	MOVWF       R7 
	CALL        _Add_32x32_FP+0, 0
	CALL        _Double2Byte+0, 0
	MOVF        R0, 0 
	MOVWF       _DL+0 
;MyGeiger_NT.mbas,977 :: 		EEPROM_Write (0x07, BG)
	MOVLW       7
	MOVWF       FARG_EEPROM_Write_address+0 
	MOVF        _BG+0, 0 
	MOVWF       FARG_EEPROM_Write_data_+0 
	CALL        _EEPROM_Write+0, 0
;MyGeiger_NT.mbas,978 :: 		delay_ms(100)
	MOVLW       130
	MOVWF       R12, 0
	MOVLW       221
	MOVWF       R13, 0
L__calibration310:
	DECFSZ      R13, 1, 1
	BRA         L__calibration310
	DECFSZ      R12, 1, 1
	BRA         L__calibration310
	NOP
	NOP
;MyGeiger_NT.mbas,979 :: 		EEPROM_Write (0x08, DL)
	MOVLW       8
	MOVWF       FARG_EEPROM_Write_address+0 
	MOVF        _DL+0, 0 
	MOVWF       FARG_EEPROM_Write_data_+0 
	CALL        _EEPROM_Write+0, 0
;MyGeiger_NT.mbas,980 :: 		delay_ms(100)
	MOVLW       130
	MOVWF       R12, 0
	MOVLW       221
	MOVWF       R13, 0
L__calibration311:
	DECFSZ      R13, 1, 1
	BRA         L__calibration311
	DECFSZ      R12, 1, 1
	BRA         L__calibration311
	NOP
	NOP
;MyGeiger_NT.mbas,981 :: 		goto tube_square_set
	GOTO        L__calibration_tube_square_set
L__calibration308:
;MyGeiger_NT.mbas,983 :: 		wend
	GOTO        L__calibration291
;MyGeiger_NT.mbas,984 :: 		tube_square_set:
L__calibration_tube_square_set:
;MyGeiger_NT.mbas,985 :: 		MyText_LCD(0,2,"SQ=             cm^2")
	CLRF        FARG_MyText_LCD_x+0 
	MOVLW       2
	MOVWF       FARG_MyText_LCD_y+0 
	MOVLW       83
	MOVWF       ?LocalText_calibration+0 
	MOVLW       81
	MOVWF       ?LocalText_calibration+1 
	MOVLW       61
	MOVWF       ?LocalText_calibration+2 
	MOVLW       32
	MOVWF       ?LocalText_calibration+3 
	MOVLW       32
	MOVWF       ?LocalText_calibration+4 
	MOVLW       32
	MOVWF       ?LocalText_calibration+5 
	MOVLW       32
	MOVWF       ?LocalText_calibration+6 
	MOVLW       32
	MOVWF       ?LocalText_calibration+7 
	MOVLW       32
	MOVWF       ?LocalText_calibration+8 
	MOVLW       32
	MOVWF       ?LocalText_calibration+9 
	MOVLW       32
	MOVWF       ?LocalText_calibration+10 
	MOVLW       32
	MOVWF       ?LocalText_calibration+11 
	MOVLW       32
	MOVWF       ?LocalText_calibration+12 
	MOVLW       32
	MOVWF       ?LocalText_calibration+13 
	MOVLW       32
	MOVWF       ?LocalText_calibration+14 
	MOVLW       32
	MOVWF       ?LocalText_calibration+15 
	MOVLW       99
	MOVWF       ?LocalText_calibration+16 
	MOVLW       109
	MOVWF       ?LocalText_calibration+17 
	MOVLW       94
	MOVWF       ?LocalText_calibration+18 
	MOVLW       50
	MOVWF       ?LocalText_calibration+19 
	CLRF        ?LocalText_calibration+20 
	MOVLW       ?LocalText_calibration+0
	MOVWF       FARG_MyText_LCD_sentance+0 
	MOVLW       hi_addr(?LocalText_calibration+0)
	MOVWF       FARG_MyText_LCD_sentance+1 
	CALL        _MyText_LCD+0, 0
;MyGeiger_NT.mbas,986 :: 		ByteToStr (tube_square, tube_limit_txt)
	MOVF        _tube_square+0, 0 
	MOVWF       FARG_ByteToStr_input+0 
	MOVLW       _tube_limit_txt+0
	MOVWF       FARG_ByteToStr_output+0 
	MOVLW       hi_addr(_tube_limit_txt+0)
	MOVWF       FARG_ByteToStr_output+1 
	CALL        _ByteToStr+0, 0
;MyGeiger_NT.mbas,987 :: 		MyText_LCD(20, 2, tube_limit_txt)
	MOVLW       20
	MOVWF       FARG_MyText_LCD_x+0 
	MOVLW       2
	MOVWF       FARG_MyText_LCD_y+0 
	MOVLW       _tube_limit_txt+0
	MOVWF       FARG_MyText_LCD_sentance+0 
	MOVLW       hi_addr(_tube_limit_txt+0)
	MOVWF       FARG_MyText_LCD_sentance+1 
	CALL        _MyText_LCD+0, 0
;MyGeiger_NT.mbas,988 :: 		while(1)
L__calibration314:
;MyGeiger_NT.mbas,989 :: 		if Button (PORTB, 7, 150, 1) then
	MOVLW       PORTB+0
	MOVWF       FARG_Button_port+0 
	MOVLW       hi_addr(PORTB+0)
	MOVWF       FARG_Button_port+1 
	MOVLW       7
	MOVWF       FARG_Button_pin+0 
	MOVLW       150
	MOVWF       FARG_Button_time+0 
	MOVLW       1
	MOVWF       FARG_Button_activeState+0 
	CALL        _Button+0, 0
	MOVF        R0, 1 
	BTFSC       STATUS+0, 2 
	GOTO        L__calibration319
;MyGeiger_NT.mbas,990 :: 		inc(tube_square)
	INCF        _tube_square+0, 1 
;MyGeiger_NT.mbas,991 :: 		if tube_square>254 then
	MOVF        _tube_square+0, 0 
	SUBLW       254
	BTFSC       STATUS+0, 0 
	GOTO        L__calibration322
;MyGeiger_NT.mbas,992 :: 		tube_square = 254
	MOVLW       254
	MOVWF       _tube_square+0 
L__calibration322:
;MyGeiger_NT.mbas,994 :: 		ByteToStr (tube_square, tube_limit_txt)
	MOVF        _tube_square+0, 0 
	MOVWF       FARG_ByteToStr_input+0 
	MOVLW       _tube_limit_txt+0
	MOVWF       FARG_ByteToStr_output+0 
	MOVLW       hi_addr(_tube_limit_txt+0)
	MOVWF       FARG_ByteToStr_output+1 
	CALL        _ByteToStr+0, 0
;MyGeiger_NT.mbas,995 :: 		MyText_LCD(20, 2, tube_limit_txt)
	MOVLW       20
	MOVWF       FARG_MyText_LCD_x+0 
	MOVLW       2
	MOVWF       FARG_MyText_LCD_y+0 
	MOVLW       _tube_limit_txt+0
	MOVWF       FARG_MyText_LCD_sentance+0 
	MOVLW       hi_addr(_tube_limit_txt+0)
	MOVWF       FARG_MyText_LCD_sentance+1 
	CALL        _MyText_LCD+0, 0
L__calibration319:
;MyGeiger_NT.mbas,998 :: 		if Button (PORTB, 6, 150, 1) then
	MOVLW       PORTB+0
	MOVWF       FARG_Button_port+0 
	MOVLW       hi_addr(PORTB+0)
	MOVWF       FARG_Button_port+1 
	MOVLW       6
	MOVWF       FARG_Button_pin+0 
	MOVLW       150
	MOVWF       FARG_Button_time+0 
	MOVLW       1
	MOVWF       FARG_Button_activeState+0 
	CALL        _Button+0, 0
	MOVF        R0, 1 
	BTFSC       STATUS+0, 2 
	GOTO        L__calibration325
;MyGeiger_NT.mbas,999 :: 		dec(tube_square)
	DECF        _tube_square+0, 1 
;MyGeiger_NT.mbas,1000 :: 		if tube_square<3 then
	MOVLW       3
	SUBWF       _tube_square+0, 0 
	BTFSC       STATUS+0, 0 
	GOTO        L__calibration328
;MyGeiger_NT.mbas,1001 :: 		tube_square = 3
	MOVLW       3
	MOVWF       _tube_square+0 
L__calibration328:
;MyGeiger_NT.mbas,1003 :: 		ByteToStr (tube_square, tube_limit_txt)
	MOVF        _tube_square+0, 0 
	MOVWF       FARG_ByteToStr_input+0 
	MOVLW       _tube_limit_txt+0
	MOVWF       FARG_ByteToStr_output+0 
	MOVLW       hi_addr(_tube_limit_txt+0)
	MOVWF       FARG_ByteToStr_output+1 
	CALL        _ByteToStr+0, 0
;MyGeiger_NT.mbas,1004 :: 		MyText_LCD(20, 2, tube_limit_txt)
	MOVLW       20
	MOVWF       FARG_MyText_LCD_x+0 
	MOVLW       2
	MOVWF       FARG_MyText_LCD_y+0 
	MOVLW       _tube_limit_txt+0
	MOVWF       FARG_MyText_LCD_sentance+0 
	MOVLW       hi_addr(_tube_limit_txt+0)
	MOVWF       FARG_MyText_LCD_sentance+1 
	CALL        _MyText_LCD+0, 0
L__calibration325:
;MyGeiger_NT.mbas,1006 :: 		if Button (PORTB, 5, 150, 1) then         'ok
	MOVLW       PORTB+0
	MOVWF       FARG_Button_port+0 
	MOVLW       hi_addr(PORTB+0)
	MOVWF       FARG_Button_port+1 
	MOVLW       5
	MOVWF       FARG_Button_pin+0 
	MOVLW       150
	MOVWF       FARG_Button_time+0 
	MOVLW       1
	MOVWF       FARG_Button_activeState+0 
	CALL        _Button+0, 0
	MOVF        R0, 1 
	BTFSC       STATUS+0, 2 
	GOTO        L__calibration331
;MyGeiger_NT.mbas,1007 :: 		EEPROM_Write (0x06, tube_square)
	MOVLW       6
	MOVWF       FARG_EEPROM_Write_address+0 
	MOVF        _tube_square+0, 0 
	MOVWF       FARG_EEPROM_Write_data_+0 
	CALL        _EEPROM_Write+0, 0
;MyGeiger_NT.mbas,1008 :: 		delay_ms(100)
	MOVLW       130
	MOVWF       R12, 0
	MOVLW       221
	MOVWF       R13, 0
L__calibration333:
	DECFSZ      R13, 1, 1
	BRA         L__calibration333
	DECFSZ      R12, 1, 1
	BRA         L__calibration333
	NOP
	NOP
;MyGeiger_NT.mbas,1009 :: 		goto dead_time_set
	GOTO        L__calibration_dead_time_set
L__calibration331:
;MyGeiger_NT.mbas,1011 :: 		wend
	GOTO        L__calibration314
;MyGeiger_NT.mbas,1012 :: 		dead_time_set:
L__calibration_dead_time_set:
;MyGeiger_NT.mbas,1013 :: 		MyText_LCD(0,3,"DT=             ;Sec")
	CLRF        FARG_MyText_LCD_x+0 
	MOVLW       3
	MOVWF       FARG_MyText_LCD_y+0 
	MOVLW       68
	MOVWF       ?LocalText_calibration+0 
	MOVLW       84
	MOVWF       ?LocalText_calibration+1 
	MOVLW       61
	MOVWF       ?LocalText_calibration+2 
	MOVLW       32
	MOVWF       ?LocalText_calibration+3 
	MOVLW       32
	MOVWF       ?LocalText_calibration+4 
	MOVLW       32
	MOVWF       ?LocalText_calibration+5 
	MOVLW       32
	MOVWF       ?LocalText_calibration+6 
	MOVLW       32
	MOVWF       ?LocalText_calibration+7 
	MOVLW       32
	MOVWF       ?LocalText_calibration+8 
	MOVLW       32
	MOVWF       ?LocalText_calibration+9 
	MOVLW       32
	MOVWF       ?LocalText_calibration+10 
	MOVLW       32
	MOVWF       ?LocalText_calibration+11 
	MOVLW       32
	MOVWF       ?LocalText_calibration+12 
	MOVLW       32
	MOVWF       ?LocalText_calibration+13 
	MOVLW       32
	MOVWF       ?LocalText_calibration+14 
	MOVLW       32
	MOVWF       ?LocalText_calibration+15 
	MOVLW       59
	MOVWF       ?LocalText_calibration+16 
	MOVLW       83
	MOVWF       ?LocalText_calibration+17 
	MOVLW       101
	MOVWF       ?LocalText_calibration+18 
	MOVLW       99
	MOVWF       ?LocalText_calibration+19 
	CLRF        ?LocalText_calibration+20 
	MOVLW       ?LocalText_calibration+0
	MOVWF       FARG_MyText_LCD_sentance+0 
	MOVLW       hi_addr(?LocalText_calibration+0)
	MOVWF       FARG_MyText_LCD_sentance+1 
	CALL        _MyText_LCD+0, 0
;MyGeiger_NT.mbas,1014 :: 		ByteToStr (DT, tube_limit_txt)
	MOVF        _DT+0, 0 
	MOVWF       FARG_ByteToStr_input+0 
	MOVLW       _tube_limit_txt+0
	MOVWF       FARG_ByteToStr_output+0 
	MOVLW       hi_addr(_tube_limit_txt+0)
	MOVWF       FARG_ByteToStr_output+1 
	CALL        _ByteToStr+0, 0
;MyGeiger_NT.mbas,1015 :: 		MyText_LCD(20, 3, tube_limit_txt)
	MOVLW       20
	MOVWF       FARG_MyText_LCD_x+0 
	MOVLW       3
	MOVWF       FARG_MyText_LCD_y+0 
	MOVLW       _tube_limit_txt+0
	MOVWF       FARG_MyText_LCD_sentance+0 
	MOVLW       hi_addr(_tube_limit_txt+0)
	MOVWF       FARG_MyText_LCD_sentance+1 
	CALL        _MyText_LCD+0, 0
;MyGeiger_NT.mbas,1016 :: 		while(1)
L__calibration336:
;MyGeiger_NT.mbas,1017 :: 		if Button (PORTB, 7, 150, 1) then
	MOVLW       PORTB+0
	MOVWF       FARG_Button_port+0 
	MOVLW       hi_addr(PORTB+0)
	MOVWF       FARG_Button_port+1 
	MOVLW       7
	MOVWF       FARG_Button_pin+0 
	MOVLW       150
	MOVWF       FARG_Button_time+0 
	MOVLW       1
	MOVWF       FARG_Button_activeState+0 
	CALL        _Button+0, 0
	MOVF        R0, 1 
	BTFSC       STATUS+0, 2 
	GOTO        L__calibration341
;MyGeiger_NT.mbas,1018 :: 		inc(DT)
	INCF        _DT+0, 1 
;MyGeiger_NT.mbas,1019 :: 		if DT>251 then
	MOVF        _DT+0, 0 
	SUBLW       251
	BTFSC       STATUS+0, 0 
	GOTO        L__calibration344
;MyGeiger_NT.mbas,1020 :: 		DT = 250
	MOVLW       250
	MOVWF       _DT+0 
L__calibration344:
;MyGeiger_NT.mbas,1022 :: 		ByteToStr (DT, tube_limit_txt)
	MOVF        _DT+0, 0 
	MOVWF       FARG_ByteToStr_input+0 
	MOVLW       _tube_limit_txt+0
	MOVWF       FARG_ByteToStr_output+0 
	MOVLW       hi_addr(_tube_limit_txt+0)
	MOVWF       FARG_ByteToStr_output+1 
	CALL        _ByteToStr+0, 0
;MyGeiger_NT.mbas,1023 :: 		MyText_LCD(20, 3, tube_limit_txt)
	MOVLW       20
	MOVWF       FARG_MyText_LCD_x+0 
	MOVLW       3
	MOVWF       FARG_MyText_LCD_y+0 
	MOVLW       _tube_limit_txt+0
	MOVWF       FARG_MyText_LCD_sentance+0 
	MOVLW       hi_addr(_tube_limit_txt+0)
	MOVWF       FARG_MyText_LCD_sentance+1 
	CALL        _MyText_LCD+0, 0
L__calibration341:
;MyGeiger_NT.mbas,1026 :: 		if Button (PORTB, 6, 150, 1) then
	MOVLW       PORTB+0
	MOVWF       FARG_Button_port+0 
	MOVLW       hi_addr(PORTB+0)
	MOVWF       FARG_Button_port+1 
	MOVLW       6
	MOVWF       FARG_Button_pin+0 
	MOVLW       150
	MOVWF       FARG_Button_time+0 
	MOVLW       1
	MOVWF       FARG_Button_activeState+0 
	CALL        _Button+0, 0
	MOVF        R0, 1 
	BTFSC       STATUS+0, 2 
	GOTO        L__calibration347
;MyGeiger_NT.mbas,1027 :: 		dec(DT)
	DECF        _DT+0, 1 
;MyGeiger_NT.mbas,1028 :: 		if DT<2 then
	MOVLW       2
	SUBWF       _DT+0, 0 
	BTFSC       STATUS+0, 0 
	GOTO        L__calibration350
;MyGeiger_NT.mbas,1029 :: 		DT = 1
	MOVLW       1
	MOVWF       _DT+0 
L__calibration350:
;MyGeiger_NT.mbas,1031 :: 		ByteToStr (DT, tube_limit_txt)
	MOVF        _DT+0, 0 
	MOVWF       FARG_ByteToStr_input+0 
	MOVLW       _tube_limit_txt+0
	MOVWF       FARG_ByteToStr_output+0 
	MOVLW       hi_addr(_tube_limit_txt+0)
	MOVWF       FARG_ByteToStr_output+1 
	CALL        _ByteToStr+0, 0
;MyGeiger_NT.mbas,1032 :: 		MyText_LCD(20, 3, tube_limit_txt)
	MOVLW       20
	MOVWF       FARG_MyText_LCD_x+0 
	MOVLW       3
	MOVWF       FARG_MyText_LCD_y+0 
	MOVLW       _tube_limit_txt+0
	MOVWF       FARG_MyText_LCD_sentance+0 
	MOVLW       hi_addr(_tube_limit_txt+0)
	MOVWF       FARG_MyText_LCD_sentance+1 
	CALL        _MyText_LCD+0, 0
L__calibration347:
;MyGeiger_NT.mbas,1034 :: 		if Button (PORTB, 5, 150, 1) then         'ok
	MOVLW       PORTB+0
	MOVWF       FARG_Button_port+0 
	MOVLW       hi_addr(PORTB+0)
	MOVWF       FARG_Button_port+1 
	MOVLW       5
	MOVWF       FARG_Button_pin+0 
	MOVLW       150
	MOVWF       FARG_Button_time+0 
	MOVLW       1
	MOVWF       FARG_Button_activeState+0 
	CALL        _Button+0, 0
	MOVF        R0, 1 
	BTFSC       STATUS+0, 2 
	GOTO        L__calibration353
;MyGeiger_NT.mbas,1035 :: 		EEPROM_Write (0x0A, DT)
	MOVLW       10
	MOVWF       FARG_EEPROM_Write_address+0 
	MOVF        _DT+0, 0 
	MOVWF       FARG_EEPROM_Write_data_+0 
	CALL        _EEPROM_Write+0, 0
;MyGeiger_NT.mbas,1036 :: 		delay_ms(100)
	MOVLW       130
	MOVWF       R12, 0
	MOVLW       221
	MOVWF       R13, 0
L__calibration355:
	DECFSZ      R13, 1, 1
	BRA         L__calibration355
	DECFSZ      R12, 1, 1
	BRA         L__calibration355
	NOP
	NOP
;MyGeiger_NT.mbas,1037 :: 		goto becquerel_output
	GOTO        L__calibration_becquerel_output
L__calibration353:
;MyGeiger_NT.mbas,1039 :: 		wend
	GOTO        L__calibration336
;MyGeiger_NT.mbas,1041 :: 		becquerel_output:
L__calibration_becquerel_output:
;MyGeiger_NT.mbas,1042 :: 		MyText_LCD(0,4,"USB data:CPM")
	CLRF        FARG_MyText_LCD_x+0 
	MOVLW       4
	MOVWF       FARG_MyText_LCD_y+0 
	MOVLW       85
	MOVWF       ?LocalText_calibration+0 
	MOVLW       83
	MOVWF       ?LocalText_calibration+1 
	MOVLW       66
	MOVWF       ?LocalText_calibration+2 
	MOVLW       32
	MOVWF       ?LocalText_calibration+3 
	MOVLW       100
	MOVWF       ?LocalText_calibration+4 
	MOVLW       97
	MOVWF       ?LocalText_calibration+5 
	MOVLW       116
	MOVWF       ?LocalText_calibration+6 
	MOVLW       97
	MOVWF       ?LocalText_calibration+7 
	MOVLW       58
	MOVWF       ?LocalText_calibration+8 
	MOVLW       67
	MOVWF       ?LocalText_calibration+9 
	MOVLW       80
	MOVWF       ?LocalText_calibration+10 
	MOVLW       77
	MOVWF       ?LocalText_calibration+11 
	CLRF        ?LocalText_calibration+12 
	MOVLW       ?LocalText_calibration+0
	MOVWF       FARG_MyText_LCD_sentance+0 
	MOVLW       hi_addr(?LocalText_calibration+0)
	MOVWF       FARG_MyText_LCD_sentance+1 
	CALL        _MyText_LCD+0, 0
;MyGeiger_NT.mbas,1043 :: 		becquerel  = 0x00
	CLRF        _becquerel+0 
;MyGeiger_NT.mbas,1044 :: 		while(1)
L__calibration358:
;MyGeiger_NT.mbas,1045 :: 		if Button (PORTB, 7, 150, 1) then        '+
	MOVLW       PORTB+0
	MOVWF       FARG_Button_port+0 
	MOVLW       hi_addr(PORTB+0)
	MOVWF       FARG_Button_port+1 
	MOVLW       7
	MOVWF       FARG_Button_pin+0 
	MOVLW       150
	MOVWF       FARG_Button_time+0 
	MOVLW       1
	MOVWF       FARG_Button_activeState+0 
	CALL        _Button+0, 0
	MOVF        R0, 1 
	BTFSC       STATUS+0, 2 
	GOTO        L__calibration363
;MyGeiger_NT.mbas,1046 :: 		MyText_LCD(54,4,"CPM")
	MOVLW       54
	MOVWF       FARG_MyText_LCD_x+0 
	MOVLW       4
	MOVWF       FARG_MyText_LCD_y+0 
	MOVLW       67
	MOVWF       ?LocalText_calibration+0 
	MOVLW       80
	MOVWF       ?LocalText_calibration+1 
	MOVLW       77
	MOVWF       ?LocalText_calibration+2 
	CLRF        ?LocalText_calibration+3 
	MOVLW       ?LocalText_calibration+0
	MOVWF       FARG_MyText_LCD_sentance+0 
	MOVLW       hi_addr(?LocalText_calibration+0)
	MOVWF       FARG_MyText_LCD_sentance+1 
	CALL        _MyText_LCD+0, 0
;MyGeiger_NT.mbas,1047 :: 		becquerel  = 0x00
	CLRF        _becquerel+0 
L__calibration363:
;MyGeiger_NT.mbas,1050 :: 		if Button (PORTB, 6, 150, 1) then        '-
	MOVLW       PORTB+0
	MOVWF       FARG_Button_port+0 
	MOVLW       hi_addr(PORTB+0)
	MOVWF       FARG_Button_port+1 
	MOVLW       6
	MOVWF       FARG_Button_pin+0 
	MOVLW       150
	MOVWF       FARG_Button_time+0 
	MOVLW       1
	MOVWF       FARG_Button_activeState+0 
	CALL        _Button+0, 0
	MOVF        R0, 1 
	BTFSC       STATUS+0, 2 
	GOTO        L__calibration366
;MyGeiger_NT.mbas,1051 :: 		MyText_LCD(54,4,"Bq ")
	MOVLW       54
	MOVWF       FARG_MyText_LCD_x+0 
	MOVLW       4
	MOVWF       FARG_MyText_LCD_y+0 
	MOVLW       66
	MOVWF       ?LocalText_calibration+0 
	MOVLW       113
	MOVWF       ?LocalText_calibration+1 
	MOVLW       32
	MOVWF       ?LocalText_calibration+2 
	CLRF        ?LocalText_calibration+3 
	MOVLW       ?LocalText_calibration+0
	MOVWF       FARG_MyText_LCD_sentance+0 
	MOVLW       hi_addr(?LocalText_calibration+0)
	MOVWF       FARG_MyText_LCD_sentance+1 
	CALL        _MyText_LCD+0, 0
;MyGeiger_NT.mbas,1052 :: 		becquerel = 0x01
	MOVLW       1
	MOVWF       _becquerel+0 
L__calibration366:
;MyGeiger_NT.mbas,1054 :: 		if Button (PORTB, 5, 150, 1) then         'ok
	MOVLW       PORTB+0
	MOVWF       FARG_Button_port+0 
	MOVLW       hi_addr(PORTB+0)
	MOVWF       FARG_Button_port+1 
	MOVLW       5
	MOVWF       FARG_Button_pin+0 
	MOVLW       150
	MOVWF       FARG_Button_time+0 
	MOVLW       1
	MOVWF       FARG_Button_activeState+0 
	CALL        _Button+0, 0
	MOVF        R0, 1 
	BTFSC       STATUS+0, 2 
	GOTO        L__calibration369
;MyGeiger_NT.mbas,1055 :: 		EEPROM_Write (0x09, becquerel)
	MOVLW       9
	MOVWF       FARG_EEPROM_Write_address+0 
	MOVF        _becquerel+0, 0 
	MOVWF       FARG_EEPROM_Write_data_+0 
	CALL        _EEPROM_Write+0, 0
;MyGeiger_NT.mbas,1056 :: 		delay_ms(100)
	MOVLW       130
	MOVWF       R12, 0
	MOVLW       221
	MOVWF       R13, 0
L__calibration371:
	DECFSZ      R13, 1, 1
	BRA         L__calibration371
	DECFSZ      R12, 1, 1
	BRA         L__calibration371
	NOP
	NOP
;MyGeiger_NT.mbas,1057 :: 		goto backlight_settings
	GOTO        L__calibration_backlight_settings
L__calibration369:
;MyGeiger_NT.mbas,1060 :: 		wend
	GOTO        L__calibration358
;MyGeiger_NT.mbas,1061 :: 		backlight_settings:
L__calibration_backlight_settings:
;MyGeiger_NT.mbas,1062 :: 		MyText_LCD(0,5,"Smart Backlight? YES")
	CLRF        FARG_MyText_LCD_x+0 
	MOVLW       5
	MOVWF       FARG_MyText_LCD_y+0 
	MOVLW       83
	MOVWF       ?LocalText_calibration+0 
	MOVLW       109
	MOVWF       ?LocalText_calibration+1 
	MOVLW       97
	MOVWF       ?LocalText_calibration+2 
	MOVLW       114
	MOVWF       ?LocalText_calibration+3 
	MOVLW       116
	MOVWF       ?LocalText_calibration+4 
	MOVLW       32
	MOVWF       ?LocalText_calibration+5 
	MOVLW       66
	MOVWF       ?LocalText_calibration+6 
	MOVLW       97
	MOVWF       ?LocalText_calibration+7 
	MOVLW       99
	MOVWF       ?LocalText_calibration+8 
	MOVLW       107
	MOVWF       ?LocalText_calibration+9 
	MOVLW       108
	MOVWF       ?LocalText_calibration+10 
	MOVLW       105
	MOVWF       ?LocalText_calibration+11 
	MOVLW       103
	MOVWF       ?LocalText_calibration+12 
	MOVLW       104
	MOVWF       ?LocalText_calibration+13 
	MOVLW       116
	MOVWF       ?LocalText_calibration+14 
	MOVLW       63
	MOVWF       ?LocalText_calibration+15 
	MOVLW       32
	MOVWF       ?LocalText_calibration+16 
	MOVLW       89
	MOVWF       ?LocalText_calibration+17 
	MOVLW       69
	MOVWF       ?LocalText_calibration+18 
	MOVLW       83
	MOVWF       ?LocalText_calibration+19 
	CLRF        ?LocalText_calibration+20 
	MOVLW       ?LocalText_calibration+0
	MOVWF       FARG_MyText_LCD_sentance+0 
	MOVLW       hi_addr(?LocalText_calibration+0)
	MOVWF       FARG_MyText_LCD_sentance+1 
	CALL        _MyText_LCD+0, 0
;MyGeiger_NT.mbas,1063 :: 		smartBL  = 0x01
	MOVLW       1
	MOVWF       _smartBL+0 
;MyGeiger_NT.mbas,1064 :: 		while(1)
L__calibration374:
;MyGeiger_NT.mbas,1065 :: 		if Button (PORTB, 7, 150, 1) then        '+
	MOVLW       PORTB+0
	MOVWF       FARG_Button_port+0 
	MOVLW       hi_addr(PORTB+0)
	MOVWF       FARG_Button_port+1 
	MOVLW       7
	MOVWF       FARG_Button_pin+0 
	MOVLW       150
	MOVWF       FARG_Button_time+0 
	MOVLW       1
	MOVWF       FARG_Button_activeState+0 
	CALL        _Button+0, 0
	MOVF        R0, 1 
	BTFSC       STATUS+0, 2 
	GOTO        L__calibration379
;MyGeiger_NT.mbas,1066 :: 		MyText_LCD(102,5,"YES")
	MOVLW       102
	MOVWF       FARG_MyText_LCD_x+0 
	MOVLW       5
	MOVWF       FARG_MyText_LCD_y+0 
	MOVLW       89
	MOVWF       ?LocalText_calibration+0 
	MOVLW       69
	MOVWF       ?LocalText_calibration+1 
	MOVLW       83
	MOVWF       ?LocalText_calibration+2 
	CLRF        ?LocalText_calibration+3 
	MOVLW       ?LocalText_calibration+0
	MOVWF       FARG_MyText_LCD_sentance+0 
	MOVLW       hi_addr(?LocalText_calibration+0)
	MOVWF       FARG_MyText_LCD_sentance+1 
	CALL        _MyText_LCD+0, 0
;MyGeiger_NT.mbas,1067 :: 		smartBL  = 0x01
	MOVLW       1
	MOVWF       _smartBL+0 
L__calibration379:
;MyGeiger_NT.mbas,1070 :: 		if Button (PORTB, 6, 150, 1) then        '-
	MOVLW       PORTB+0
	MOVWF       FARG_Button_port+0 
	MOVLW       hi_addr(PORTB+0)
	MOVWF       FARG_Button_port+1 
	MOVLW       6
	MOVWF       FARG_Button_pin+0 
	MOVLW       150
	MOVWF       FARG_Button_time+0 
	MOVLW       1
	MOVWF       FARG_Button_activeState+0 
	CALL        _Button+0, 0
	MOVF        R0, 1 
	BTFSC       STATUS+0, 2 
	GOTO        L__calibration382
;MyGeiger_NT.mbas,1071 :: 		MyText_LCD(102,5,"NO ")
	MOVLW       102
	MOVWF       FARG_MyText_LCD_x+0 
	MOVLW       5
	MOVWF       FARG_MyText_LCD_y+0 
	MOVLW       78
	MOVWF       ?LocalText_calibration+0 
	MOVLW       79
	MOVWF       ?LocalText_calibration+1 
	MOVLW       32
	MOVWF       ?LocalText_calibration+2 
	CLRF        ?LocalText_calibration+3 
	MOVLW       ?LocalText_calibration+0
	MOVWF       FARG_MyText_LCD_sentance+0 
	MOVLW       hi_addr(?LocalText_calibration+0)
	MOVWF       FARG_MyText_LCD_sentance+1 
	CALL        _MyText_LCD+0, 0
;MyGeiger_NT.mbas,1072 :: 		smartBL  = 0x00
	CLRF        _smartBL+0 
L__calibration382:
;MyGeiger_NT.mbas,1074 :: 		if Button (PORTB, 5, 150, 1) then         'ok
	MOVLW       PORTB+0
	MOVWF       FARG_Button_port+0 
	MOVLW       hi_addr(PORTB+0)
	MOVWF       FARG_Button_port+1 
	MOVLW       5
	MOVWF       FARG_Button_pin+0 
	MOVLW       150
	MOVWF       FARG_Button_time+0 
	MOVLW       1
	MOVWF       FARG_Button_activeState+0 
	CALL        _Button+0, 0
	MOVF        R0, 1 
	BTFSC       STATUS+0, 2 
	GOTO        L__calibration385
;MyGeiger_NT.mbas,1075 :: 		EEPROM_Write (0x10, smartBL)
	MOVLW       16
	MOVWF       FARG_EEPROM_Write_address+0 
	MOVF        _smartBL+0, 0 
	MOVWF       FARG_EEPROM_Write_data_+0 
	CALL        _EEPROM_Write+0, 0
;MyGeiger_NT.mbas,1076 :: 		delay_ms(100)
	MOVLW       130
	MOVWF       R12, 0
	MOVLW       221
	MOVWF       R13, 0
L__calibration387:
	DECFSZ      R13, 1, 1
	BRA         L__calibration387
	DECFSZ      R12, 1, 1
	BRA         L__calibration387
	NOP
	NOP
;MyGeiger_NT.mbas,1077 :: 		goto exit_calibration
	GOTO        L__calibration_exit_calibration
L__calibration385:
;MyGeiger_NT.mbas,1080 :: 		wend
	GOTO        L__calibration374
;MyGeiger_NT.mbas,1082 :: 		exit_calibration:
L__calibration_exit_calibration:
;MyGeiger_NT.mbas,1084 :: 		ClearLCD()
	CALL        _ClearLCD+0, 0
;MyGeiger_NT.mbas,1085 :: 		counts = 0
	CLRF        _counts+0 
	CLRF        _counts+1 
;MyGeiger_NT.mbas,1086 :: 		cpm = 0
	CLRF        _cpm+0 
	CLRF        _cpm+1 
	CLRF        _cpm+2 
	CLRF        _cpm+3 
;MyGeiger_NT.mbas,1087 :: 		dose = 0
	CLRF        _dose+0 
	CLRF        _dose+1 
	CLRF        _dose+2 
	CLRF        _dose+3 
;MyGeiger_NT.mbas,1088 :: 		timer_cnt = 0
	CLRF        _timer_cnt+0 
;MyGeiger_NT.mbas,1089 :: 		cpm_read_done = 0
	BCF         _cpm_read_done+0, BitPos(_cpm_read_done+0) 
;MyGeiger_NT.mbas,1090 :: 		TMR1IF_bit = 0
	BCF         TMR1IF_bit+0, BitPos(TMR1IF_bit+0) 
;MyGeiger_NT.mbas,1091 :: 		reset
	RESET
;MyGeiger_NT.mbas,1092 :: 		end sub
L_end_calibration:
	RETURN      0
; end of _calibration

_signalization:

;MyGeiger_NT.mbas,1099 :: 		dim shag as byte
;MyGeiger_NT.mbas,1100 :: 		shag = 10
	MOVLW       10
	MOVWF       signalization_shag+0 
;MyGeiger_NT.mbas,1101 :: 		ClearLCD()
	CALL        _ClearLCD+0, 0
;MyGeiger_NT.mbas,1103 :: 		MyText_LCD(8,0,   "SET ALERT CPM NOW?")
	MOVLW       8
	MOVWF       FARG_MyText_LCD_x+0 
	CLRF        FARG_MyText_LCD_y+0 
	MOVLW       83
	MOVWF       ?LocalText_signalization+0 
	MOVLW       69
	MOVWF       ?LocalText_signalization+1 
	MOVLW       84
	MOVWF       ?LocalText_signalization+2 
	MOVLW       32
	MOVWF       ?LocalText_signalization+3 
	MOVLW       65
	MOVWF       ?LocalText_signalization+4 
	MOVLW       76
	MOVWF       ?LocalText_signalization+5 
	MOVLW       69
	MOVWF       ?LocalText_signalization+6 
	MOVLW       82
	MOVWF       ?LocalText_signalization+7 
	MOVLW       84
	MOVWF       ?LocalText_signalization+8 
	MOVLW       32
	MOVWF       ?LocalText_signalization+9 
	MOVLW       67
	MOVWF       ?LocalText_signalization+10 
	MOVLW       80
	MOVWF       ?LocalText_signalization+11 
	MOVLW       77
	MOVWF       ?LocalText_signalization+12 
	MOVLW       32
	MOVWF       ?LocalText_signalization+13 
	MOVLW       78
	MOVWF       ?LocalText_signalization+14 
	MOVLW       79
	MOVWF       ?LocalText_signalization+15 
	MOVLW       87
	MOVWF       ?LocalText_signalization+16 
	MOVLW       63
	MOVWF       ?LocalText_signalization+17 
	CLRF        ?LocalText_signalization+18 
	MOVLW       ?LocalText_signalization+0
	MOVWF       FARG_MyText_LCD_sentance+0 
	MOVLW       hi_addr(?LocalText_signalization+0)
	MOVWF       FARG_MyText_LCD_sentance+1 
	CALL        _MyText_LCD+0, 0
;MyGeiger_NT.mbas,1104 :: 		MyText_LCD(32,6,  "use to set:")
	MOVLW       32
	MOVWF       FARG_MyText_LCD_x+0 
	MOVLW       6
	MOVWF       FARG_MyText_LCD_y+0 
	MOVLW       117
	MOVWF       ?LocalText_signalization+0 
	MOVLW       115
	MOVWF       ?LocalText_signalization+1 
	MOVLW       101
	MOVWF       ?LocalText_signalization+2 
	MOVLW       32
	MOVWF       ?LocalText_signalization+3 
	MOVLW       116
	MOVWF       ?LocalText_signalization+4 
	MOVLW       111
	MOVWF       ?LocalText_signalization+5 
	MOVLW       32
	MOVWF       ?LocalText_signalization+6 
	MOVLW       115
	MOVWF       ?LocalText_signalization+7 
	MOVLW       101
	MOVWF       ?LocalText_signalization+8 
	MOVLW       116
	MOVWF       ?LocalText_signalization+9 
	MOVLW       58
	MOVWF       ?LocalText_signalization+10 
	CLRF        ?LocalText_signalization+11 
	MOVLW       ?LocalText_signalization+0
	MOVWF       FARG_MyText_LCD_sentance+0 
	MOVLW       hi_addr(?LocalText_signalization+0)
	MOVWF       FARG_MyText_LCD_sentance+1 
	CALL        _MyText_LCD+0, 0
;MyGeiger_NT.mbas,1105 :: 		MyText_LCD(24, 7, "plus,minus,OK")
	MOVLW       24
	MOVWF       FARG_MyText_LCD_x+0 
	MOVLW       7
	MOVWF       FARG_MyText_LCD_y+0 
	MOVLW       112
	MOVWF       ?LocalText_signalization+0 
	MOVLW       108
	MOVWF       ?LocalText_signalization+1 
	MOVLW       117
	MOVWF       ?LocalText_signalization+2 
	MOVLW       115
	MOVWF       ?LocalText_signalization+3 
	MOVLW       44
	MOVWF       ?LocalText_signalization+4 
	MOVLW       109
	MOVWF       ?LocalText_signalization+5 
	MOVLW       105
	MOVWF       ?LocalText_signalization+6 
	MOVLW       110
	MOVWF       ?LocalText_signalization+7 
	MOVLW       117
	MOVWF       ?LocalText_signalization+8 
	MOVLW       115
	MOVWF       ?LocalText_signalization+9 
	MOVLW       44
	MOVWF       ?LocalText_signalization+10 
	MOVLW       79
	MOVWF       ?LocalText_signalization+11 
	MOVLW       75
	MOVWF       ?LocalText_signalization+12 
	CLRF        ?LocalText_signalization+13 
	MOVLW       ?LocalText_signalization+0
	MOVWF       FARG_MyText_LCD_sentance+0 
	MOVLW       hi_addr(?LocalText_signalization+0)
	MOVWF       FARG_MyText_LCD_sentance+1 
	CALL        _MyText_LCD+0, 0
;MyGeiger_NT.mbas,1107 :: 		WordToStr (ALARM, txt1)
	MOVF        _ALARM+0, 0 
	MOVWF       FARG_WordToStr_input+0 
	MOVF        _ALARM+1, 0 
	MOVWF       FARG_WordToStr_input+1 
	MOVLW       signalization_txt1+0
	MOVWF       FARG_WordToStr_output+0 
	MOVLW       hi_addr(signalization_txt1+0)
	MOVWF       FARG_WordToStr_output+1 
	CALL        _WordToStr+0, 0
;MyGeiger_NT.mbas,1108 :: 		ltrim (txt1)
	MOVLW       signalization_txt1+0
	MOVWF       FARG_ltrim_astring+0 
	MOVLW       hi_addr(signalization_txt1+0)
	MOVWF       FARG_ltrim_astring+1 
	CALL        _ltrim+0, 0
;MyGeiger_NT.mbas,1109 :: 		MyText_LCD (51, 2, txt1)
	MOVLW       51
	MOVWF       FARG_MyText_LCD_x+0 
	MOVLW       2
	MOVWF       FARG_MyText_LCD_y+0 
	MOVLW       signalization_txt1+0
	MOVWF       FARG_MyText_LCD_sentance+0 
	MOVLW       hi_addr(signalization_txt1+0)
	MOVWF       FARG_MyText_LCD_sentance+1 
	CALL        _MyText_LCD+0, 0
;MyGeiger_NT.mbas,1110 :: 		for zzz = 0 to 30000
	CLRF        signalization_zzz+0 
	CLRF        signalization_zzz+1 
L__signalization391:
;MyGeiger_NT.mbas,1111 :: 		if Button (PORTB, 7, 50, 1) or Button (PORTB, 6, 150, 1) then
	MOVLW       PORTB+0
	MOVWF       FARG_Button_port+0 
	MOVLW       hi_addr(PORTB+0)
	MOVWF       FARG_Button_port+1 
	MOVLW       7
	MOVWF       FARG_Button_pin+0 
	MOVLW       50
	MOVWF       FARG_Button_time+0 
	MOVLW       1
	MOVWF       FARG_Button_activeState+0 
	CALL        _Button+0, 0
	MOVF        R0, 0 
	MOVWF       FLOC__signalization+0 
	MOVLW       PORTB+0
	MOVWF       FARG_Button_port+0 
	MOVLW       hi_addr(PORTB+0)
	MOVWF       FARG_Button_port+1 
	MOVLW       6
	MOVWF       FARG_Button_pin+0 
	MOVLW       150
	MOVWF       FARG_Button_time+0 
	MOVLW       1
	MOVWF       FARG_Button_activeState+0 
	CALL        _Button+0, 0
	MOVF        FLOC__signalization+0, 0 
	IORWF       R0, 1 
	BTFSC       STATUS+0, 2 
	GOTO        L__signalization396
;MyGeiger_NT.mbas,1112 :: 		goto CHANGE
	GOTO        L__signalization_change
L__signalization396:
;MyGeiger_NT.mbas,1114 :: 		next zzz
	MOVF        signalization_zzz+1, 0 
	XORLW       117
	BTFSS       STATUS+0, 2 
	GOTO        L__signalization826
	MOVLW       48
	XORWF       signalization_zzz+0, 0 
L__signalization826:
	BTFSC       STATUS+0, 2 
	GOTO        L__signalization394
	INFSNZ      signalization_zzz+0, 1 
	INCF        signalization_zzz+1, 1 
	GOTO        L__signalization391
L__signalization394:
;MyGeiger_NT.mbas,1115 :: 		goto CHANGE2
	GOTO        L__signalization_change2
;MyGeiger_NT.mbas,1117 :: 		CHANGE:
L__signalization_change:
;MyGeiger_NT.mbas,1119 :: 		while (1)
L__signalization401:
;MyGeiger_NT.mbas,1120 :: 		if ALARM >= 200 then
	MOVLW       0
	SUBWF       _ALARM+1, 0 
	BTFSS       STATUS+0, 2 
	GOTO        L__signalization827
	MOVLW       200
	SUBWF       _ALARM+0, 0 
L__signalization827:
	BTFSS       STATUS+0, 0 
	GOTO        L__signalization406
;MyGeiger_NT.mbas,1121 :: 		shag = 100
	MOVLW       100
	MOVWF       signalization_shag+0 
	GOTO        L__signalization407
;MyGeiger_NT.mbas,1122 :: 		else
L__signalization406:
;MyGeiger_NT.mbas,1123 :: 		shag = 10
	MOVLW       10
	MOVWF       signalization_shag+0 
;MyGeiger_NT.mbas,1124 :: 		end if
L__signalization407:
;MyGeiger_NT.mbas,1126 :: 		if Button (PORTB, 7, 150, 1) then
	MOVLW       PORTB+0
	MOVWF       FARG_Button_port+0 
	MOVLW       hi_addr(PORTB+0)
	MOVWF       FARG_Button_port+1 
	MOVLW       7
	MOVWF       FARG_Button_pin+0 
	MOVLW       150
	MOVWF       FARG_Button_time+0 
	MOVLW       1
	MOVWF       FARG_Button_activeState+0 
	CALL        _Button+0, 0
	MOVF        R0, 1 
	BTFSC       STATUS+0, 2 
	GOTO        L__signalization409
;MyGeiger_NT.mbas,1127 :: 		ALARM = ALARM + shag
	MOVF        signalization_shag+0, 0 
	ADDWF       _ALARM+0, 0 
	MOVWF       R1 
	MOVLW       0
	ADDWFC      _ALARM+1, 0 
	MOVWF       R2 
	MOVF        R1, 0 
	MOVWF       _ALARM+0 
	MOVF        R2, 0 
	MOVWF       _ALARM+1 
;MyGeiger_NT.mbas,1128 :: 		if ALARM>5000 then
	MOVF        R2, 0 
	SUBLW       19
	BTFSS       STATUS+0, 2 
	GOTO        L__signalization828
	MOVF        R1, 0 
	SUBLW       136
L__signalization828:
	BTFSC       STATUS+0, 0 
	GOTO        L__signalization412
;MyGeiger_NT.mbas,1129 :: 		ALARM = 5000
	MOVLW       136
	MOVWF       _ALARM+0 
	MOVLW       19
	MOVWF       _ALARM+1 
L__signalization412:
;MyGeiger_NT.mbas,1131 :: 		WordToStr (ALARM, txt1)
	MOVF        _ALARM+0, 0 
	MOVWF       FARG_WordToStr_input+0 
	MOVF        _ALARM+1, 0 
	MOVWF       FARG_WordToStr_input+1 
	MOVLW       signalization_txt1+0
	MOVWF       FARG_WordToStr_output+0 
	MOVLW       hi_addr(signalization_txt1+0)
	MOVWF       FARG_WordToStr_output+1 
	CALL        _WordToStr+0, 0
;MyGeiger_NT.mbas,1132 :: 		ltrim (txt1)
	MOVLW       signalization_txt1+0
	MOVWF       FARG_ltrim_astring+0 
	MOVLW       hi_addr(signalization_txt1+0)
	MOVWF       FARG_ltrim_astring+1 
	CALL        _ltrim+0, 0
;MyGeiger_NT.mbas,1133 :: 		MyText_LCD (51, 2, "     ")
	MOVLW       51
	MOVWF       FARG_MyText_LCD_x+0 
	MOVLW       2
	MOVWF       FARG_MyText_LCD_y+0 
	MOVLW       32
	MOVWF       ?LocalText_signalization+0 
	MOVLW       32
	MOVWF       ?LocalText_signalization+1 
	MOVLW       32
	MOVWF       ?LocalText_signalization+2 
	MOVLW       32
	MOVWF       ?LocalText_signalization+3 
	MOVLW       32
	MOVWF       ?LocalText_signalization+4 
	CLRF        ?LocalText_signalization+5 
	MOVLW       ?LocalText_signalization+0
	MOVWF       FARG_MyText_LCD_sentance+0 
	MOVLW       hi_addr(?LocalText_signalization+0)
	MOVWF       FARG_MyText_LCD_sentance+1 
	CALL        _MyText_LCD+0, 0
;MyGeiger_NT.mbas,1134 :: 		MyText_LCD (51, 2, txt1)
	MOVLW       51
	MOVWF       FARG_MyText_LCD_x+0 
	MOVLW       2
	MOVWF       FARG_MyText_LCD_y+0 
	MOVLW       signalization_txt1+0
	MOVWF       FARG_MyText_LCD_sentance+0 
	MOVLW       hi_addr(signalization_txt1+0)
	MOVWF       FARG_MyText_LCD_sentance+1 
	CALL        _MyText_LCD+0, 0
L__signalization409:
;MyGeiger_NT.mbas,1137 :: 		if Button (PORTB, 6, 150, 1) then
	MOVLW       PORTB+0
	MOVWF       FARG_Button_port+0 
	MOVLW       hi_addr(PORTB+0)
	MOVWF       FARG_Button_port+1 
	MOVLW       6
	MOVWF       FARG_Button_pin+0 
	MOVLW       150
	MOVWF       FARG_Button_time+0 
	MOVLW       1
	MOVWF       FARG_Button_activeState+0 
	CALL        _Button+0, 0
	MOVF        R0, 1 
	BTFSC       STATUS+0, 2 
	GOTO        L__signalization415
;MyGeiger_NT.mbas,1138 :: 		ALARM = ALARM - shag
	MOVF        signalization_shag+0, 0 
	SUBWF       _ALARM+0, 0 
	MOVWF       R1 
	MOVLW       0
	SUBWFB      _ALARM+1, 0 
	MOVWF       R2 
	MOVF        R1, 0 
	MOVWF       _ALARM+0 
	MOVF        R2, 0 
	MOVWF       _ALARM+1 
;MyGeiger_NT.mbas,1139 :: 		if ALARM<10 then
	MOVLW       0
	SUBWF       R2, 0 
	BTFSS       STATUS+0, 2 
	GOTO        L__signalization829
	MOVLW       10
	SUBWF       R1, 0 
L__signalization829:
	BTFSC       STATUS+0, 0 
	GOTO        L__signalization418
;MyGeiger_NT.mbas,1140 :: 		ALARM = 10
	MOVLW       10
	MOVWF       _ALARM+0 
	MOVLW       0
	MOVWF       _ALARM+1 
L__signalization418:
;MyGeiger_NT.mbas,1142 :: 		WordToStr (ALARM, txt1)
	MOVF        _ALARM+0, 0 
	MOVWF       FARG_WordToStr_input+0 
	MOVF        _ALARM+1, 0 
	MOVWF       FARG_WordToStr_input+1 
	MOVLW       signalization_txt1+0
	MOVWF       FARG_WordToStr_output+0 
	MOVLW       hi_addr(signalization_txt1+0)
	MOVWF       FARG_WordToStr_output+1 
	CALL        _WordToStr+0, 0
;MyGeiger_NT.mbas,1143 :: 		ltrim(txt1)
	MOVLW       signalization_txt1+0
	MOVWF       FARG_ltrim_astring+0 
	MOVLW       hi_addr(signalization_txt1+0)
	MOVWF       FARG_ltrim_astring+1 
	CALL        _ltrim+0, 0
;MyGeiger_NT.mbas,1144 :: 		MyText_LCD (51, 2, "     ")
	MOVLW       51
	MOVWF       FARG_MyText_LCD_x+0 
	MOVLW       2
	MOVWF       FARG_MyText_LCD_y+0 
	MOVLW       32
	MOVWF       ?LocalText_signalization+0 
	MOVLW       32
	MOVWF       ?LocalText_signalization+1 
	MOVLW       32
	MOVWF       ?LocalText_signalization+2 
	MOVLW       32
	MOVWF       ?LocalText_signalization+3 
	MOVLW       32
	MOVWF       ?LocalText_signalization+4 
	CLRF        ?LocalText_signalization+5 
	MOVLW       ?LocalText_signalization+0
	MOVWF       FARG_MyText_LCD_sentance+0 
	MOVLW       hi_addr(?LocalText_signalization+0)
	MOVWF       FARG_MyText_LCD_sentance+1 
	CALL        _MyText_LCD+0, 0
;MyGeiger_NT.mbas,1145 :: 		MyText_LCD (51, 2, txt1)
	MOVLW       51
	MOVWF       FARG_MyText_LCD_x+0 
	MOVLW       2
	MOVWF       FARG_MyText_LCD_y+0 
	MOVLW       signalization_txt1+0
	MOVWF       FARG_MyText_LCD_sentance+0 
	MOVLW       hi_addr(signalization_txt1+0)
	MOVWF       FARG_MyText_LCD_sentance+1 
	CALL        _MyText_LCD+0, 0
L__signalization415:
;MyGeiger_NT.mbas,1148 :: 		if Button (PORTB, 5, 150, 1) then
	MOVLW       PORTB+0
	MOVWF       FARG_Button_port+0 
	MOVLW       hi_addr(PORTB+0)
	MOVWF       FARG_Button_port+1 
	MOVLW       5
	MOVWF       FARG_Button_pin+0 
	MOVLW       150
	MOVWF       FARG_Button_time+0 
	MOVLW       1
	MOVWF       FARG_Button_activeState+0 
	CALL        _Button+0, 0
	MOVF        R0, 1 
	BTFSC       STATUS+0, 2 
	GOTO        L__signalization421
;MyGeiger_NT.mbas,1149 :: 		ALARM_L = Lo (ALARM)
	MOVF        _ALARM+0, 0 
	MOVWF       _ALARM_L+0 
;MyGeiger_NT.mbas,1150 :: 		ALARM_H = Hi (ALARM)
	MOVF        _ALARM+1, 0 
	MOVWF       _ALARM_H+0 
;MyGeiger_NT.mbas,1151 :: 		EEPROM_Write (0x02,ALARM_L)
	MOVLW       2
	MOVWF       FARG_EEPROM_Write_address+0 
	MOVF        _ALARM+0, 0 
	MOVWF       FARG_EEPROM_Write_data_+0 
	CALL        _EEPROM_Write+0, 0
;MyGeiger_NT.mbas,1152 :: 		EEPROM_Write (0x03,ALARM_H)
	MOVLW       3
	MOVWF       FARG_EEPROM_Write_address+0 
	MOVF        _ALARM_H+0, 0 
	MOVWF       FARG_EEPROM_Write_data_+0 
	CALL        _EEPROM_Write+0, 0
;MyGeiger_NT.mbas,1153 :: 		goto CHANGE2
	GOTO        L__signalization_change2
L__signalization421:
;MyGeiger_NT.mbas,1155 :: 		wend
	GOTO        L__signalization401
;MyGeiger_NT.mbas,1156 :: 		CHANGE2:
L__signalization_change2:
;MyGeiger_NT.mbas,1157 :: 		ALARM = ALARM / 60             'convert ALARM to cps
	MOVLW       60
	MOVWF       R4 
	MOVLW       0
	MOVWF       R5 
	MOVF        _ALARM+0, 0 
	MOVWF       R0 
	MOVF        _ALARM+1, 0 
	MOVWF       R1 
	CALL        _Div_16x16_U+0, 0
	MOVF        R0, 0 
	MOVWF       _ALARM+0 
	MOVF        R1, 0 
	MOVWF       _ALARM+1 
;MyGeiger_NT.mbas,1158 :: 		ClearLCD()
	CALL        _ClearLCD+0, 0
;MyGeiger_NT.mbas,1159 :: 		end sub
L_end_signalization:
	RETURN      0
; end of _signalization

_parameters:

;MyGeiger_NT.mbas,1161 :: 		sub procedure parameters()                     ' show saved parameters at startup
;MyGeiger_NT.mbas,1163 :: 		MyText_LCD(0,0, "MAX CPM:")
	CLRF        FARG_MyText_LCD_x+0 
	CLRF        FARG_MyText_LCD_y+0 
	MOVLW       77
	MOVWF       ?LocalText_parameters+0 
	MOVLW       65
	MOVWF       ?LocalText_parameters+1 
	MOVLW       88
	MOVWF       ?LocalText_parameters+2 
	MOVLW       32
	MOVWF       ?LocalText_parameters+3 
	MOVLW       67
	MOVWF       ?LocalText_parameters+4 
	MOVLW       80
	MOVWF       ?LocalText_parameters+5 
	MOVLW       77
	MOVWF       ?LocalText_parameters+6 
	MOVLW       58
	MOVWF       ?LocalText_parameters+7 
	CLRF        ?LocalText_parameters+8 
	MOVLW       ?LocalText_parameters+0
	MOVWF       FARG_MyText_LCD_sentance+0 
	MOVLW       hi_addr(?LocalText_parameters+0)
	MOVWF       FARG_MyText_LCD_sentance+1 
	CALL        _MyText_LCD+0, 0
;MyGeiger_NT.mbas,1164 :: 		LongWordToStr (cpm_max, CPM_Display)
	MOVF        _cpm_max+0, 0 
	MOVWF       FARG_LongWordToStr_input+0 
	MOVF        _cpm_max+1, 0 
	MOVWF       FARG_LongWordToStr_input+1 
	MOVF        _cpm_max+2, 0 
	MOVWF       FARG_LongWordToStr_input+2 
	MOVF        _cpm_max+3, 0 
	MOVWF       FARG_LongWordToStr_input+3 
	MOVLW       _CPM_Display+0
	MOVWF       FARG_LongWordToStr_output+0 
	MOVLW       hi_addr(_CPM_Display+0)
	MOVWF       FARG_LongWordToStr_output+1 
	CALL        _LongWordToStr+0, 0
;MyGeiger_NT.mbas,1165 :: 		ltrim(CPM_Display)
	MOVLW       _CPM_Display+0
	MOVWF       FARG_ltrim_astring+0 
	MOVLW       hi_addr(_CPM_Display+0)
	MOVWF       FARG_ltrim_astring+1 
	CALL        _ltrim+0, 0
;MyGeiger_NT.mbas,1166 :: 		MyText_LCD(50,0, CPM_Display)
	MOVLW       50
	MOVWF       FARG_MyText_LCD_x+0 
	CLRF        FARG_MyText_LCD_y+0 
	MOVLW       _CPM_Display+0
	MOVWF       FARG_MyText_LCD_sentance+0 
	MOVLW       hi_addr(_CPM_Display+0)
	MOVWF       FARG_MyText_LCD_sentance+1 
	CALL        _MyText_LCD+0, 0
;MyGeiger_NT.mbas,1168 :: 		MyText_LCD(0,1, "CF=0.0")
	CLRF        FARG_MyText_LCD_x+0 
	MOVLW       1
	MOVWF       FARG_MyText_LCD_y+0 
	MOVLW       67
	MOVWF       ?LocalText_parameters+0 
	MOVLW       70
	MOVWF       ?LocalText_parameters+1 
	MOVLW       61
	MOVWF       ?LocalText_parameters+2 
	MOVLW       48
	MOVWF       ?LocalText_parameters+3 
	MOVLW       46
	MOVWF       ?LocalText_parameters+4 
	MOVLW       48
	MOVWF       ?LocalText_parameters+5 
	CLRF        ?LocalText_parameters+6 
	MOVLW       ?LocalText_parameters+0
	MOVWF       FARG_MyText_LCD_sentance+0 
	MOVLW       hi_addr(?LocalText_parameters+0)
	MOVWF       FARG_MyText_LCD_sentance+1 
	CALL        _MyText_LCD+0, 0
;MyGeiger_NT.mbas,1169 :: 		ch = (CF div 100) mod 10
	MOVLW       100
	MOVWF       R4 
	MOVLW       0
	MOVWF       R5 
	MOVF        _CF+0, 0 
	MOVWF       R0 
	MOVLW       0
	MOVWF       R1 
	CALL        _Div_16x16_U+0, 0
	MOVLW       10
	MOVWF       R4 
	MOVLW       0
	MOVWF       R5 
	CALL        _Div_16x16_U+0, 0
	MOVF        R8, 0 
	MOVWF       R0 
	MOVF        R9, 0 
	MOVWF       R1 
	MOVF        R0, 0 
	MOVWF       _ch+0 
	MOVF        R1, 0 
	MOVWF       _ch+1 
;MyGeiger_NT.mbas,1170 :: 		PositionLCD(36, 1)
	MOVLW       36
	MOVWF       FARG_PositionLCD_x+0 
	MOVLW       1
	MOVWF       FARG_PositionLCD_y+0 
	CALL        _PositionLCD+0, 0
;MyGeiger_NT.mbas,1171 :: 		Char_LCD (48+ch)
	MOVF        _ch+0, 0 
	ADDLW       48
	MOVWF       FARG_Char_LCD_bykva+0 
	CALL        _Char_LCD+0, 0
;MyGeiger_NT.mbas,1172 :: 		Soft_SPI_Write(0x00)
	CLRF        FARG_Soft_SPI_Write_sdata+0 
	CALL        _Soft_SPI_Write+0, 0
;MyGeiger_NT.mbas,1173 :: 		ch = (CF div 10) mod 10
	MOVLW       10
	MOVWF       R4 
	MOVLW       0
	MOVWF       R5 
	MOVF        _CF+0, 0 
	MOVWF       R0 
	MOVLW       0
	MOVWF       R1 
	CALL        _Div_16x16_U+0, 0
	MOVLW       10
	MOVWF       R4 
	MOVLW       0
	MOVWF       R5 
	CALL        _Div_16x16_U+0, 0
	MOVF        R8, 0 
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
	MOVLW       hi_addr(_tube_limit_txt+0)
	MOVWF       FARG_MyText_LCD_sentance+1 
	CALL        _MyText_LCD+0, 0
;MyGeiger_NT.mbas,1197 :: 		MyText_LCD(50,5, "micro seconds")
	MOVLW       50
	MOVWF       FARG_MyText_LCD_x+0 
	MOVLW       5
	MOVWF       FARG_MyText_LCD_y+0 
	MOVLW       109
	MOVWF       ?LocalText_parameters+0 
	MOVLW       105
	MOVWF       ?LocalText_parameters+1 
	MOVLW       99
	MOVWF       ?LocalText_parameters+2 
	MOVLW       114
	MOVWF       ?LocalText_parameters+3 
	MOVLW       111
	MOVWF       ?LocalText_parameters+4 
	MOVLW       32
	MOVWF       ?LocalText_parameters+5 
	MOVLW       115
	MOVWF       ?LocalText_parameters+6 
	MOVLW       101
	MOVWF       ?LocalText_parameters+7 
	MOVLW       99
	MOVWF       ?LocalText_parameters+8 
	MOVLW       111
	MOVWF       ?LocalText_parameters+9 
	MOVLW       110
	MOVWF       ?LocalText_parameters+10 
	MOVLW       100
	MOVWF       ?LocalText_parameters+11 
	MOVLW       115
	MOVWF       ?LocalText_parameters+12 
	CLRF        ?LocalText_parameters+13 
	MOVLW       ?LocalText_parameters+0
	MOVWF       FARG_MyText_LCD_sentance+0 
	MOVLW       hi_addr(?LocalText_parameters+0)
	MOVWF       FARG_MyText_LCD_sentance+1 
	CALL        _MyText_LCD+0, 0
;MyGeiger_NT.mbas,1200 :: 		delay_ms(2000)
	MOVLW       11
	MOVWF       R11, 0
	MOVLW       38
	MOVWF       R12, 0
	MOVLW       93
	MOVWF       R13, 0
L__parameters424:
	DECFSZ      R13, 1, 1
	BRA         L__parameters424
	DECFSZ      R12, 1, 1
	BRA         L__parameters424
	DECFSZ      R11, 1, 1
	BRA         L__parameters424
	NOP
	NOP
;MyGeiger_NT.mbas,1201 :: 		ClearLCD()
	CALL        _ClearLCD+0, 0
;MyGeiger_NT.mbas,1204 :: 		end sub
L_end_parameters:
	RETURN      0
; end of _parameters

_dosextract:
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
